ianm8/uDST/PCB/README.md

# PCB Details

## PCB Complete

PCB Complete


## Revision 1.1

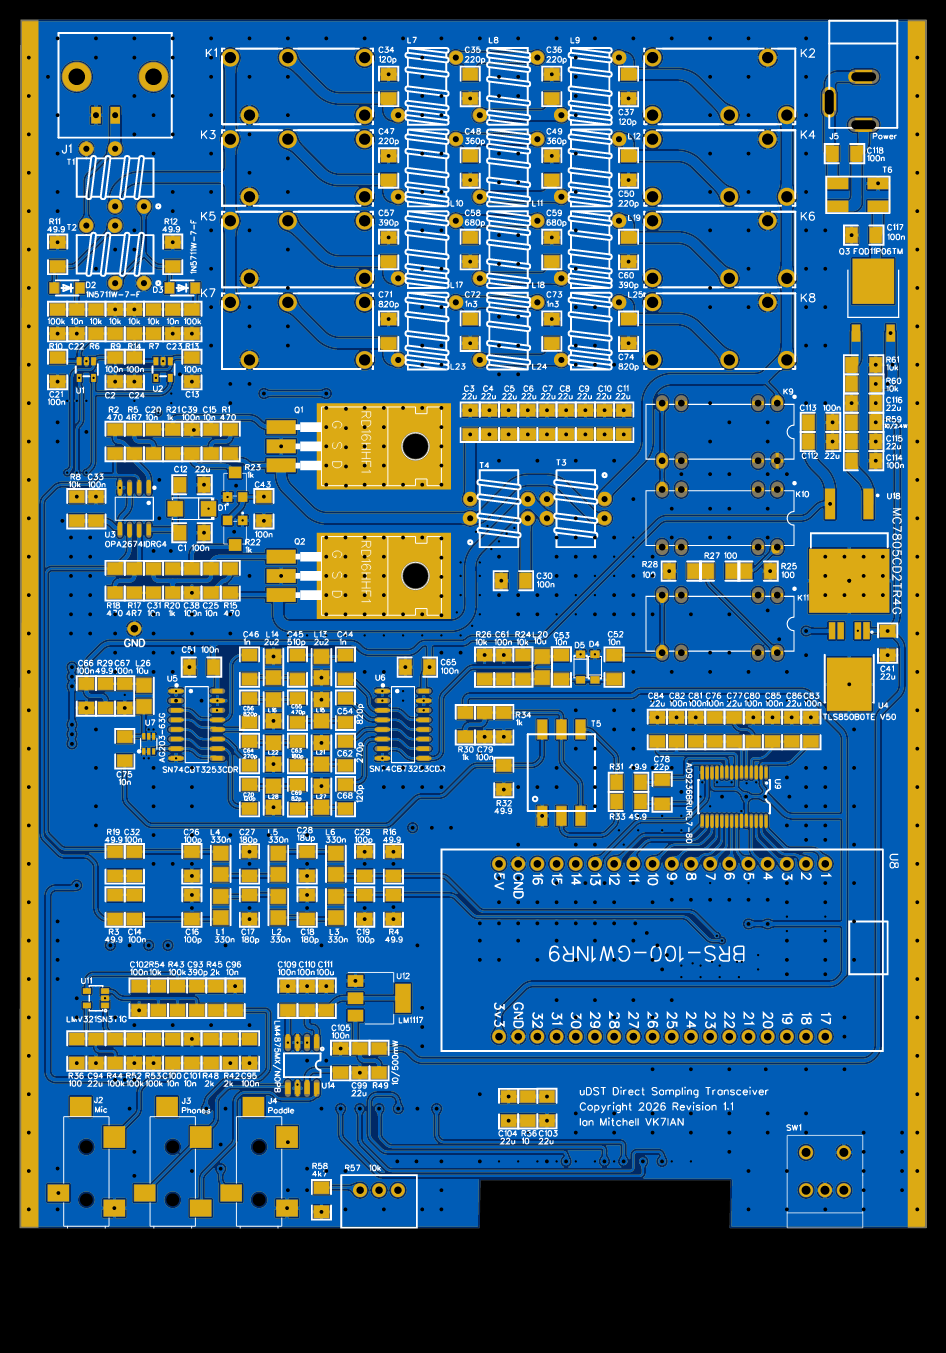
[picture p4: PCB/uDST-Top-1-1.png]
PCB
