ianm8/uDST/docs/README.md

# FPGA Details

## DDC Description

**DDC / receive.** The 12-bit ADC gives an ideal SNR of 6.02×12 + 1.76 = 74.0 dB, but that noise is spread across the full 40 MHz Nyquist band — a density of −74 − 10·log₁₀(40 MHz) = −150 dBFS/Hz. The DDC doesn't remove any noise; it just discards the 39.97 MHz of spectrum you don't want. After mixing to complex baseband and decimating by 2560, the output holds a 31.25 kHz slice, so the retained noise is −150 + 10·log₁₀(31 250) = −105 dBFS. The processing gain is therefore 10·log₁₀(40 MHz / 31.25 kHz) = 10·log₁₀(1280) ≈ **31.1 dB**, split as 24.1 dB from the CIC (÷512 → exactly 4.0 bits) and 7.0 dB from the FIR (÷5 → 1.2 bits). That's 5.2 bits of genuine extra resolution: the 12-bit converter behaves like a ~17-bit converter in the 31.25 kHz channel.

The word-growth bookkeeping matches this exactly. The 3rd-order CIC has a DC gain of 512³ = 2²⁷ (why the 48-bit integrators: worst case 16 + 27 = 43 bits). The ≫22 trim keeps 2⁷⁻²² wait — keeps 2²⁷⁄2²² = ×32, i.e. 5 bits of that gain — and those 5 bits are precisely the 5.2 bits the decimation earned, so the 16-bit I/Q word is filled with real information rather than padded LSBs. It's also why ≫22 calibrated so well: quadrature mixing halves a real carrier's amplitude (A·cosωt → A/2 complex envelope), so the net carrier gain is ×16, and a full-scale ADC input (±2047) lands at ±32 752 — 16-bit full scale within 0.004 dB. The 16-bit interface floor (−98 dBFS) sits ~7 dB above the −105 dBFS theoretical floor, so the pipe, not the ADC, is the final limit — and 98 dB in 31.25 kHz is far beyond anything HF propagation delivers. Firmware channel filtering to a ~2.4 kHz SSB bandwidth adds a further 10·log₁₀(31250⁄2400) ≈ 11 dB on top.

## DDC Block Diagram
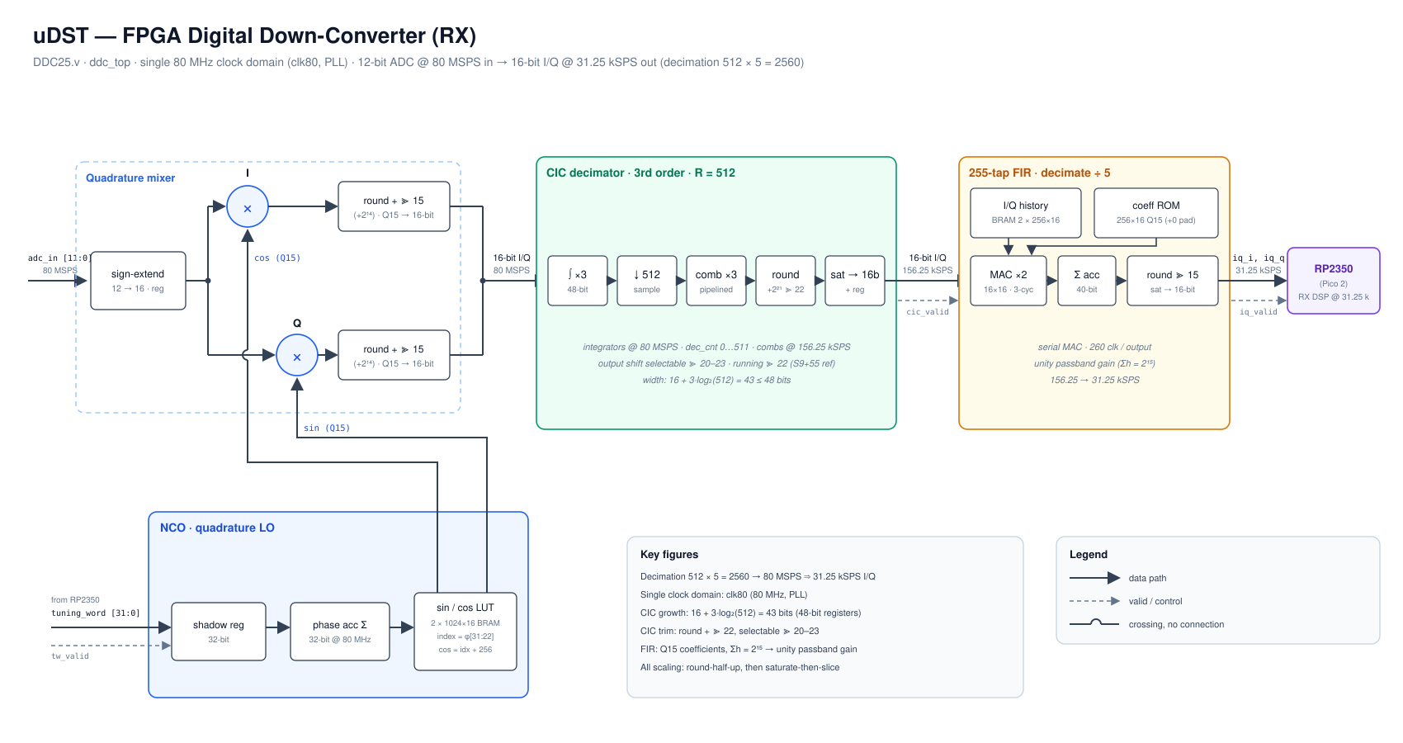
[picture p5: docs/uDST_DDC25_block_diagram.png]
DDC Block Diagram


## DUC Description

**DUC / transmit.** The same bookkeeping runs in reverse, arranged to be unity gain end to end: zero-stuffing ↑5 spreads each sample's energy over five outputs (÷5), which the 63-tap FIR's ≈×5 passband gain restores; the interpolating CIC has DC gain R^(N−1) = 512² = 2¹⁸, cancelled exactly by SCALE_SHIFT = 18; and the Q15 mixer's ≫15 returns to integer scale — so 10-bit TX samples map cleanly onto the 10-bit DAC. Oversampling pays off here too: the DAC's 62 dB SNR is spread over 40 MHz, a quantization-noise density of −138 dBFS/Hz, keeping the digital contribution to close-in transmit noise well below what the analog chain sets.

## DUC Block Diagram
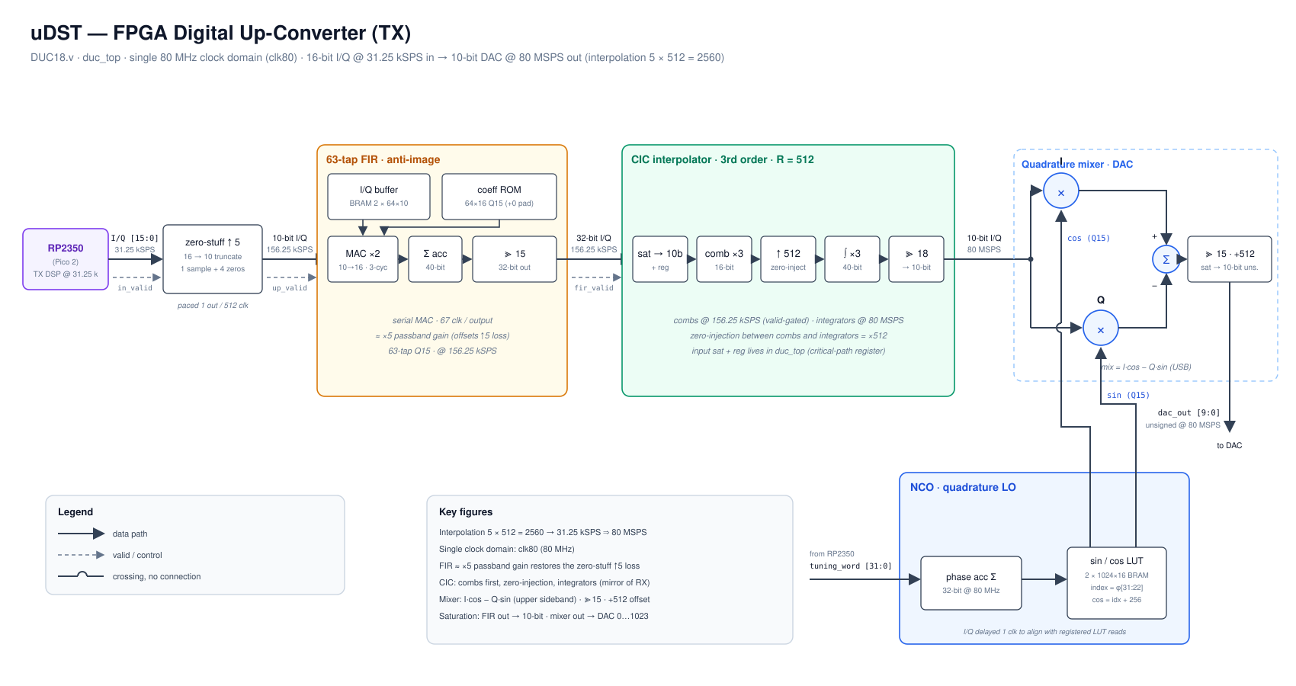
[picture p6: docs/uDST_DUC18_block_diagram.png]
DUC Block Diagram


## Analogue Gain and Attenuation

The uDST has 26dB of analogue gain ahead of the 12b ADC. This consists of an MMIC for 20dB of gain and a trifilar transformer that provides an additional 6dB of gain. A 12dB attenuator can be enabled if necessary.

**Sensitivity.** A bare 12-bit ADC clipping around +8 dBm has a noise density of 8 − 74 − 10·log₁₀(40 MHz) = −142 dBm/Hz, which against the −174 dBm/Hz thermal floor is an effective noise figure of ~32 dB. Gain ahead of the converter divides the ADC's noise contribution by that gain (Friis): antenna-referred, the ADC floor drops from −142 to −168 dBm/Hz, its NF contribution falls to ~6 dB, and the system NF becomes essentially the front-end amp's NF plus a few dB — call it 8–10 dB overall. In a 2.4 kHz SSB bandwidth that's an MDS around −131 to −134 dBm, versus roughly −108 dBm without the gain. The comparison that matters is against ITU-R band noise: quiet-rural at 7 MHz is around −144 dBm/Hz, dropping further on the higher bands. The bare ADC at −142 dBm/Hz would sit *at or above* the band noise — quiet-band weak signals lost in quantization noise — while with 26 dB the converter sits 20-plus dB underneath it on every HF band. Note the gain adds no SNR to any signal already above the amp's own noise; its entire job is to stop the ADC from *subtracting* SNR.

**Headroom.** The cost is exact and unavoidable: every dB of gain lowers the antenna-referred clip point by a dB. With ADC full scale near +8 dBm, 26 dB of gain puts clipping at −18 dBm at the antenna — which is S9+55, i.e. the ≫22 calibration point. That's a satisfying consistency check: the digital scaling and the analog gain plan agree to within a fraction of a dB. It also explains why the selectable shifts are the right companion knob — each step of the ≫20–23 option moves the digital full scale in 6 dB steps (S9+43, +49, +55…), so a future change in analog gain or a switched attenuator can be re-centred without touching the datapath. Practically, −18 dBm of clip headroom has to absorb the *aggregate* power of the whole 0–40 MHz band, since there's no channel filter ahead of a direct-sampling ADC; with typical HF antennas the night-time broadcast aggregate runs perhaps −30 to −20 dBm, so the margin is real but not extravagant — the classic direct-sampling trade, and why an attenuator ahead of a large antenna is worth having.

**Dither** The 31 dB decimation gain assumed quantization noise decorrelated across the band, which requires the LSBs to be genuinely exercised. With band noise arriving 20-odd dB above the ADC's per-Hz floor, the converter is continuously dithered by the antenna itself, so the processing-gain math holds without any added dither.

26 dB of analog gain buys ~23 dB of sensitivity, costs exactly 26 dB of clip headroom (landing full scale at S9+55), leaves every digital number unchanged, and makes the band — not the converter — the noise floor, which is the whole design goal of a direct-sampling receiver.

# Program Structure
Note, for improved resolution, take a look at the associated SVG file.

## Cores

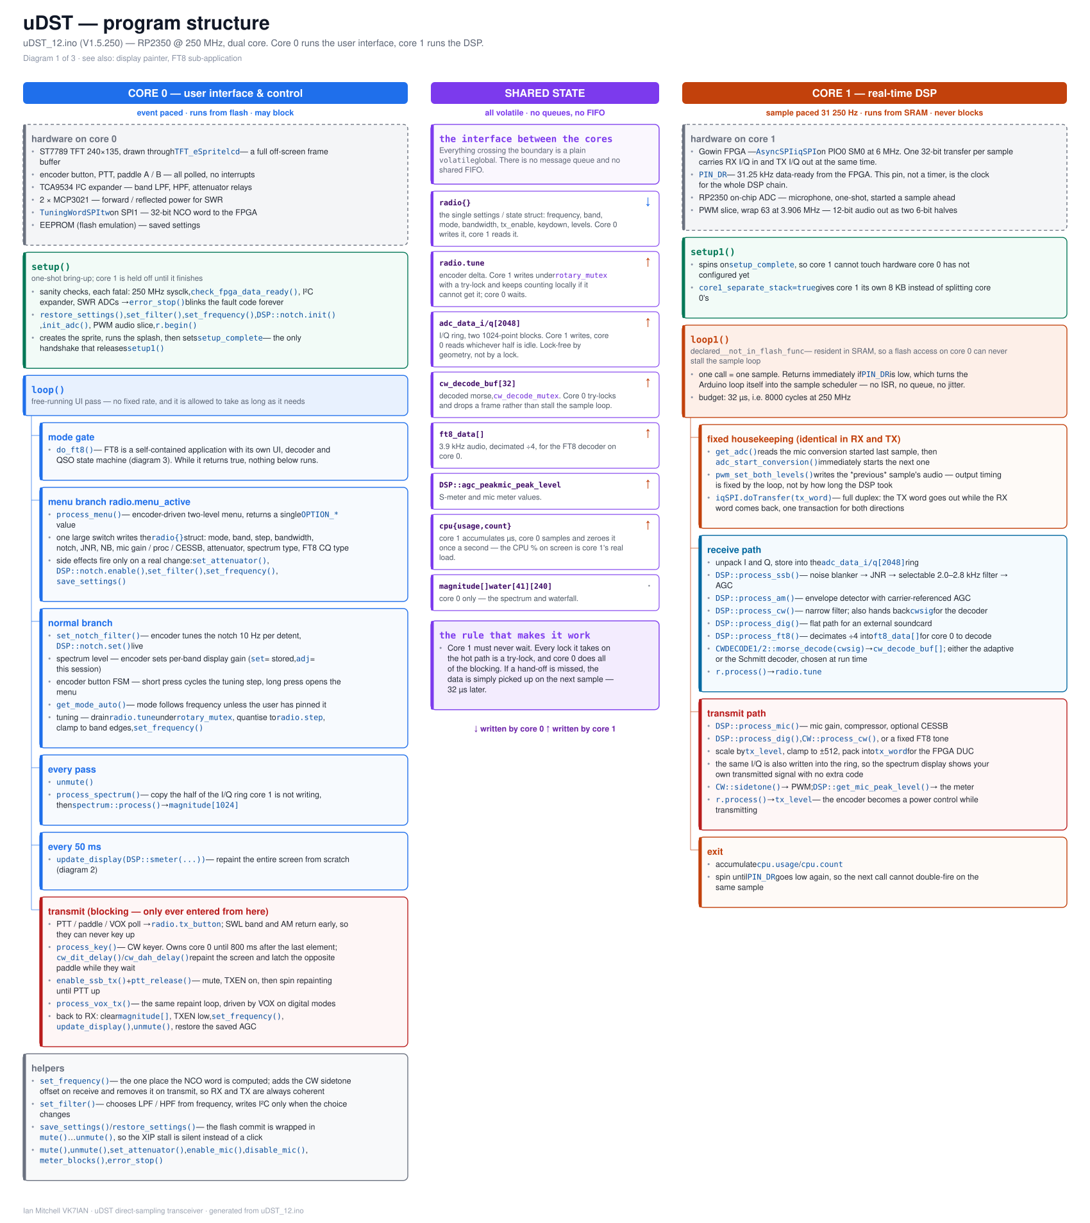
[picture p7: docs/uDST_structure_1_cores.png]


## Display

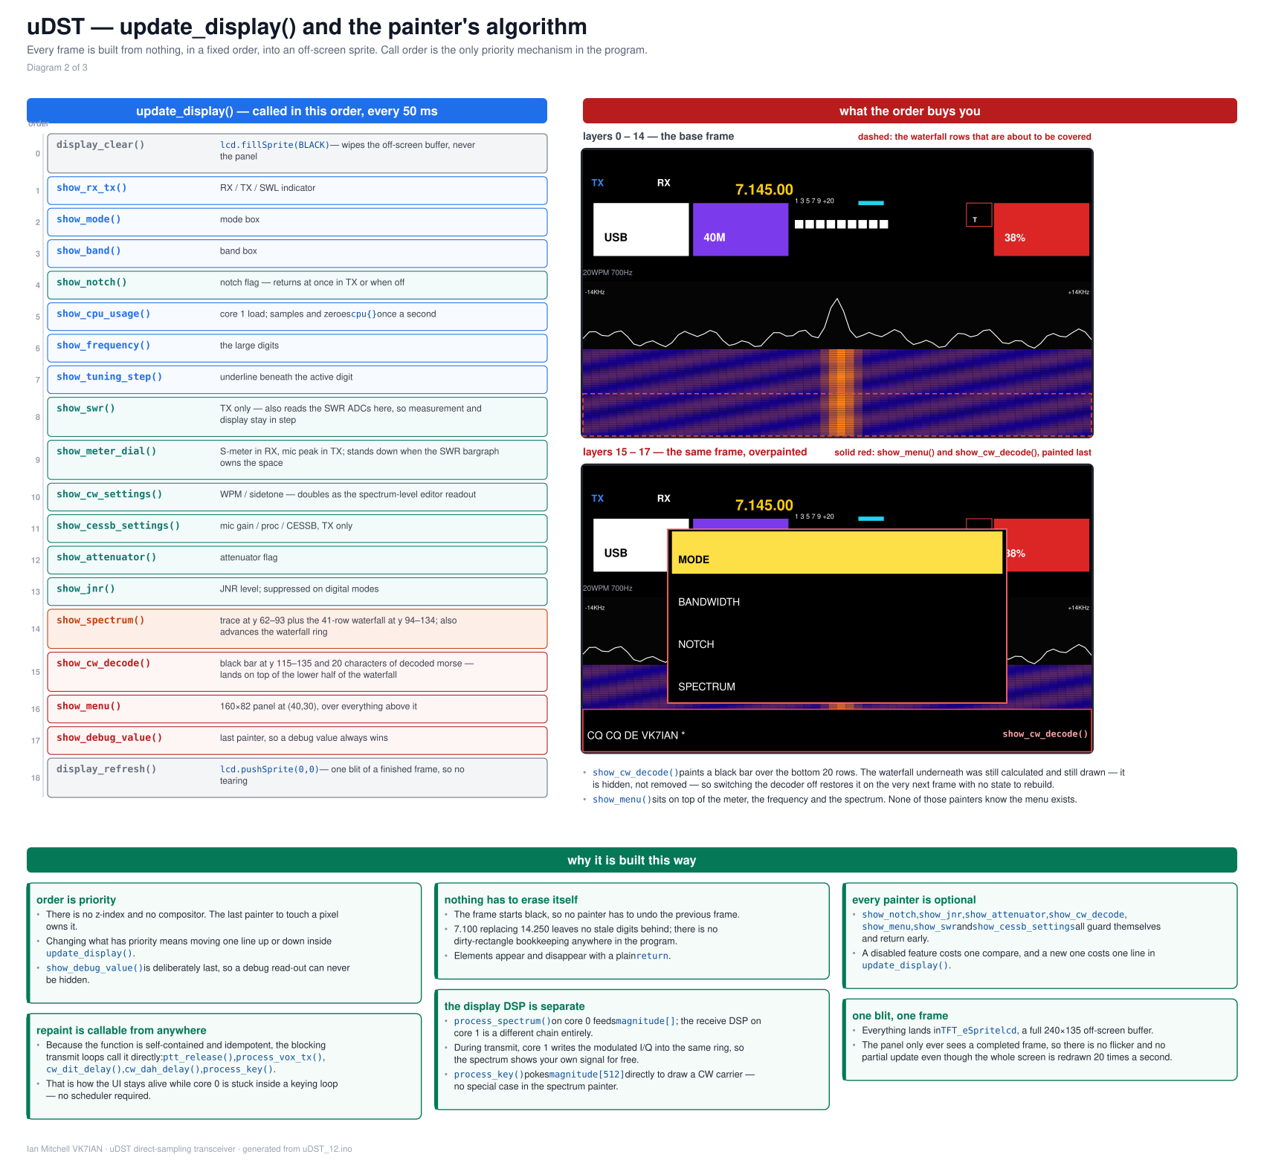
[picture p8: docs/uDST_structure_2_display.png]


## FT8

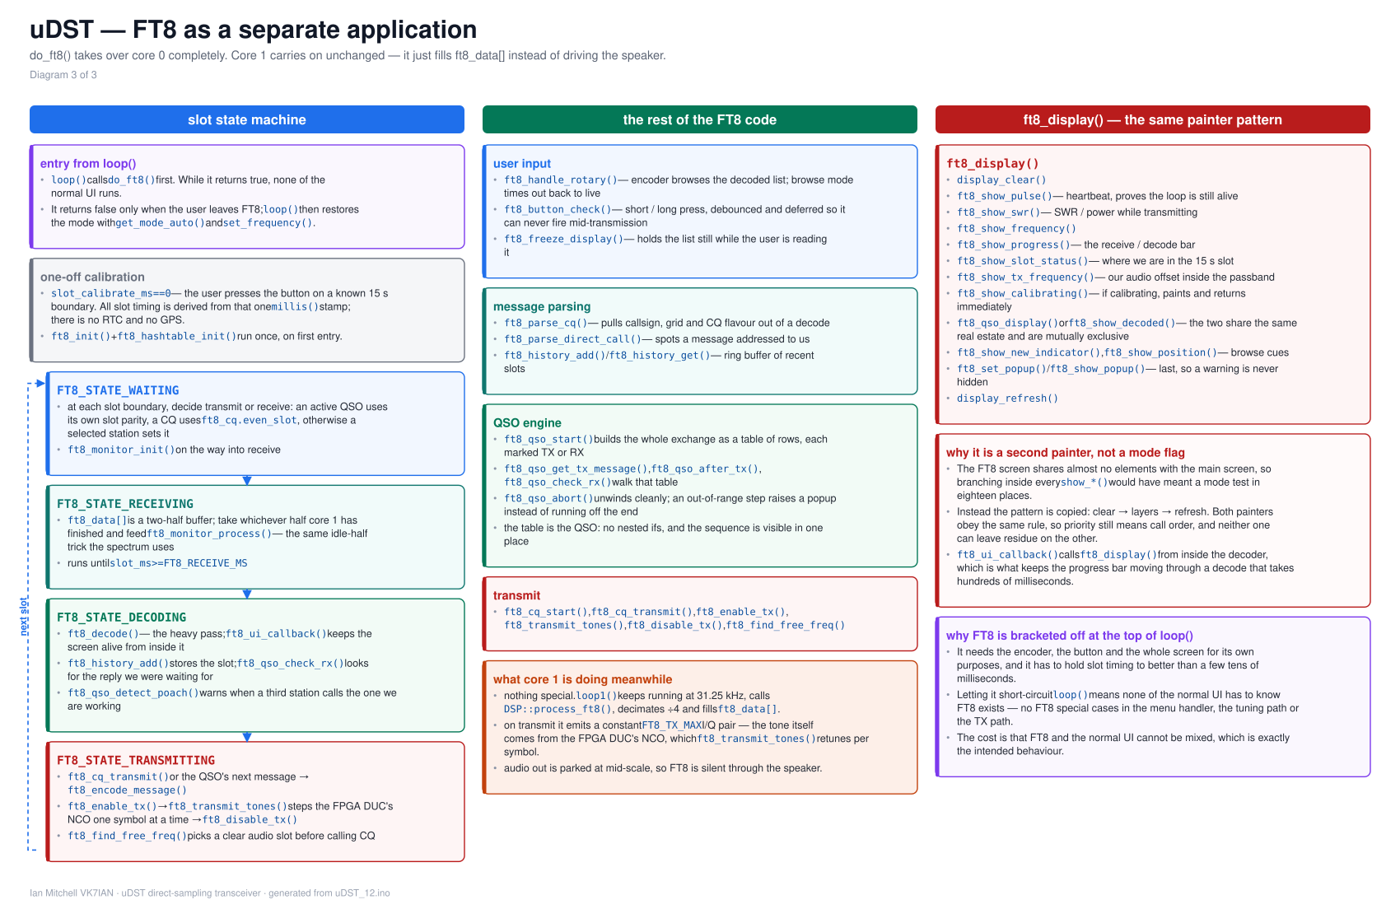
[picture p9: docs/uDST_structure_3_ft8.png]


# How it works

[This file](https://github.com/ianm8/uDST/blob/main/docs/uDST_How_It_Works.pdf) was provided by Brian W8BDM. He wanted to have a better understanding of how uDST worked so he got some help from AI and this file is the result. It is a very interesting and informative read. Thanks Brian!
