ianm8/uDST/src/TFT_eSPI2/README.md

# Modified TFT_eSPI library

* fixes a bug to work with Pico 1 and 2
* adds displayOn() function
