ianm8/uDST/verilog/uDST81/README.md

# 27/81 MHz Version

This version is for the stock, BRS-100 board with the 27MHz clock. **Note, it has not been tested in production**.
