ianm8/uDST/PCB/uDST-Bot-1-1.png

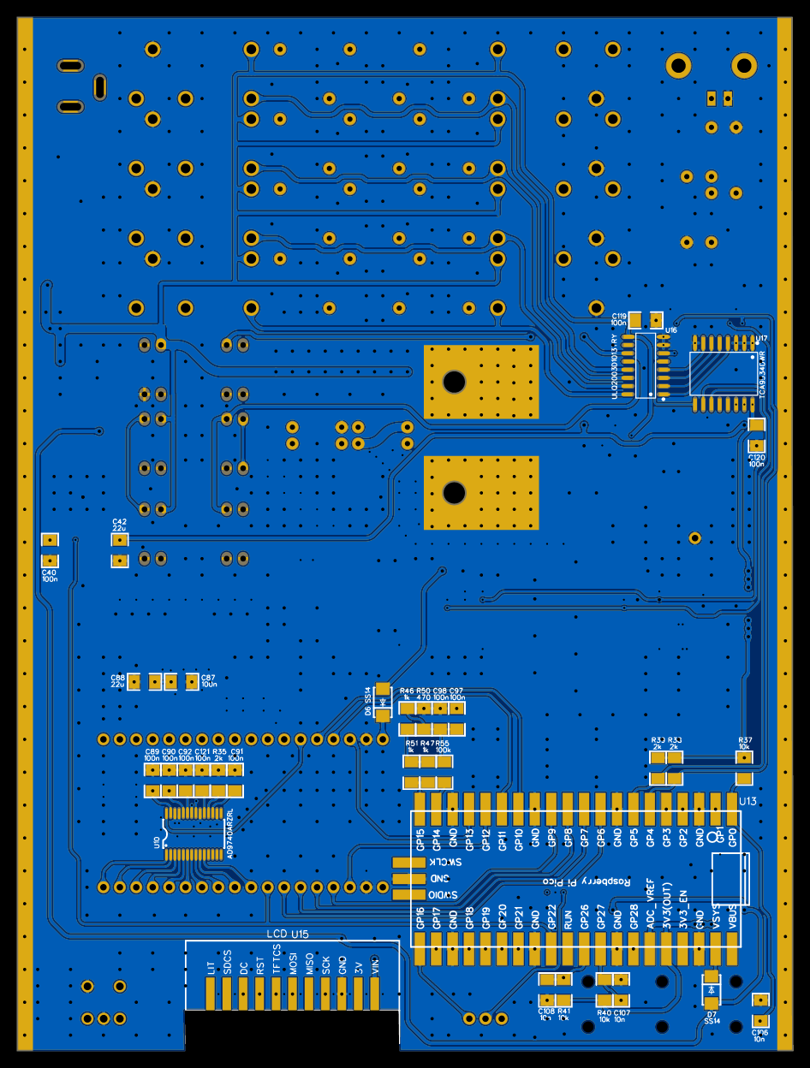
PCB/uDST-Bot-1-1.png
