ianm8/uDST/PCB/uDST-PCB-BOTTOM.png

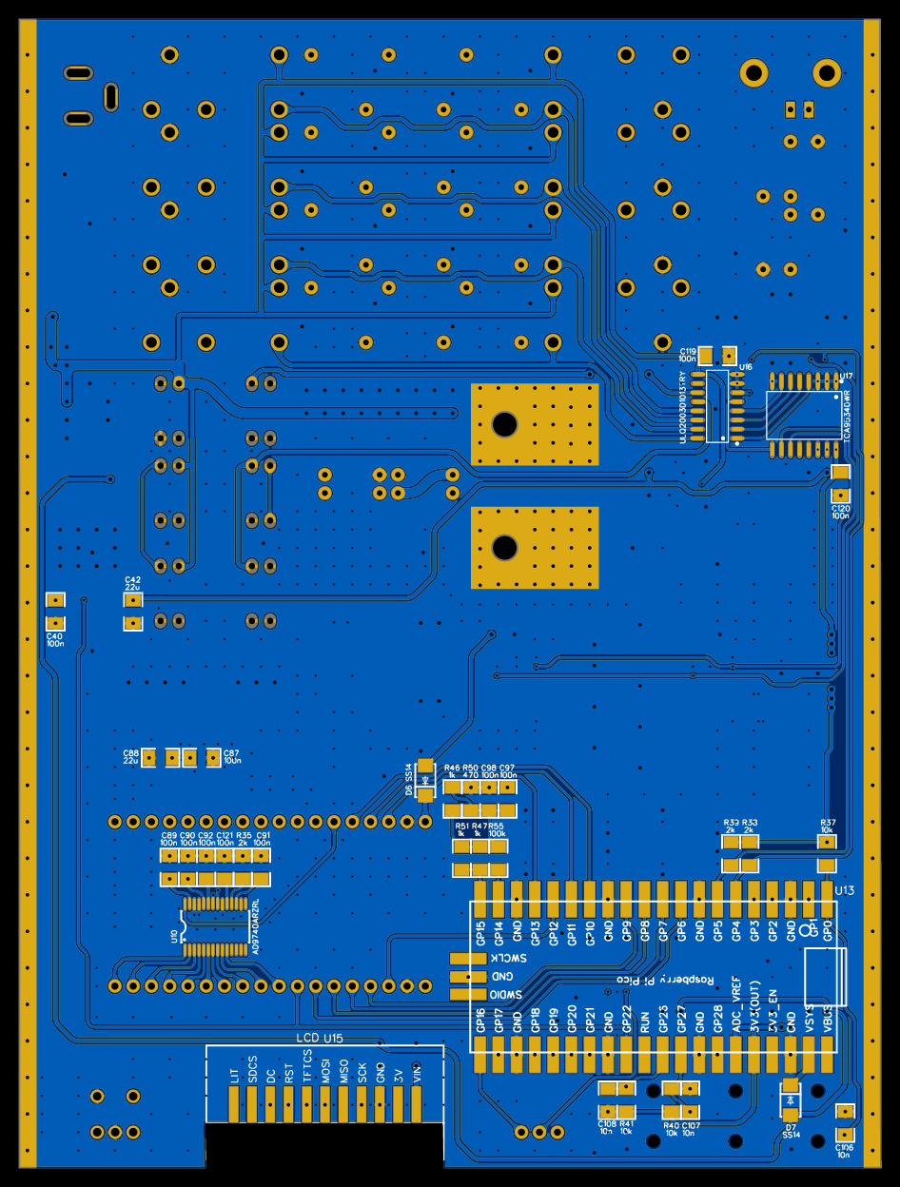
PCB/uDST-PCB-BOTTOM.png
