ianm8/uDST/BOM/BOM_uDST_2026-09-10.md

# BOM — uDST (2026-09-10)

| ID | Name | Designator | Footprint | Quantity | Manufacturer Part | Manufacturer | Supplier | Supplier Part | Notes |
|---|---|---|---|---|---|---|---|---|---|
| 1 | 100n | C1,C2,C13,C14,C21,C24,C30,C32,C33,C38,C39,C40,C43,C51,C61,C65,C66,C67,C76,C79,C80,C81,C82,C83,C85,C87,C89,C90,C91,C92,C95,C97,C98,C102,C105,C109,C110,C113,C114,C117,C118,C119,C120,C121 | 1206 | 44 | | | Mouser | | |
| 2 | 22u | C3,C4,C5,C6,C7,C8,C9,C10,C11,C12,C41,C42,C77,C84,C86,C88,C94,C99,C103,C104,C112,C115,C116 | 1206 | 23 | | | Mouser | | |
| 3 | 10n | C15,C20,C22,C23,C25,C31,C52,C53,C75,C96,C100,C101,C106,C107,C108 | 1206 | 15 | | | Mouser | | |
| 4 | 100p | C16,C19,C26,C29 | 1206 | 4 | | | Mouser | | |
| 5 | 180p | C17,C18,C27,C28,C63 | 1206 | 5 | | | Mouser | | |
| 6 | 120p | C34,C37,C68,C70 | 1206 | 4 | | | Mouser | | |
| 7 | 220p | C35,C36,C47,C50 | 1206 | 4 | | | Mouser | | |
| 8 | 1n | C44,C46 | 1206 | 2 | | | Mouser | | |
| 9 | 510p | C45 | 1206 | 1 | | | Mouser | | |
| 10 | 360p | C48,C49 | 1206 | 2 | | | Mouser | | |
| 11 | 820p | C54,C56,C71,C74 | 1206 | 4 | | | Mouser | | |
| 12 | 470p | C55 | 1206 | 1 | | | Mouser | | |
| 13 | 390p | C57,C60,C93 | 1206 | 3 | | | Mouser | | |
| 14 | 680p | C58,C59 | 1206 | 2 | | | Mouser | | |
| 15 | 270p | C62,C64 | 1206 | 2 | | | Mouser | | |
| 16 | 82p | C69 | 1206 | 1 | | | Mouser | | |
| 17 | 1n3 | C72,C73 | 1206 | 2 | | | Mouser | | |
| 18 | 22p | C78 | 1206 | 1 | | | Mouser | | |
| 19 | 100u | C111 | 1206 | 1 | | | Mouser | | |
| 20 | BZG05C3V3-M3-08 | D1 | SMA_L4.3-W2.6-LS5.2-RD | 1 | BZG05C3V3-M3-08 | VISHAY | Mouser | | |
| 21 | 1N5711W-7-F | D2,D3 | SOD-123_L2.8-W1.8-LS3.7-RD | 2 | 1N5711W-7-F | Diodes Incorporated | Mouser | | |
| 22 | 1N4148W-7-F | D4,D5 | SOD-123_L2.8-W1.8-LS3.7-RD | 2 | 1N4148W-7-F | DIODES | Mouser | | |
| 23 | SS14 | D6,D7 | SMA_L4.4-W2.8-LS5.4-RD | 2 | SS14 | MDD | Mouser | | |
| 24 | Antenna | J1 | BNC_PCB | 1 | | | Mouser | 5227161 | |
| 25 | Mic | J2 | CUI_SJ-3524-SMT | 1 | | | Mouser | SJ-3524-SMT | |
| 26 | Phones | J3 | CUI_SJ-3524-SMT | 1 | | | Mouser | SJ-3524-SMT | |
| 27 | Paddle | J4 | CUI_SJ-3524-SMT | 1 | | | Mouser | SJ-3524-SMT | |
| 28 | Power | J5 | DC-072-165A | 1 | PJ-002AH | Same Sky | Mouser | | |
| 29 | ALQ112 | K1,K2,K3,K4,K5,K6,K7,K8 | RELAY-TH_ALQ1XX | 8 | ALQ112 | PANASONIC | Mouser | | |
| 30 | HE721C1210 | K9,K10,K11 | RELAY-TH_LITTELFUSE_HE700 | 3 | HE721C1200 | Littelfuse | Mouser | | |
| 31 | 330n | L1,L2,L3,L4,L5,L6,L27,L28 | 120608 | 8 | | | Mouser | | |
| 32 | 330n | L7,L9 | T37-6 | 2 | | | Mini Kits | | |
| 33 | 360n | L8 | T37-6 | 1 | | | Mini Kits | | |
| 34 | 560n | L10,L12 | T37-6 | 2 | | | Mini Kits | | |
| 35 | 620n | L11 | T37-6 | 1 | | | Mini Kits | | |
| 36 | 2u2 | L13,L14 | 120608 | 2 | | | Mouser | | |
| 37 | 1u2 | L15,L16 | 120608 | 2 | | | Mouser | | |
| 38 | 1u | L17,L18,L19 | T37-6 | 3 | | | Mouser | | |
| 39 | 10u | L20,L26 | 120608 | 2 | | | Mouser | 1206F-100K-01 | |
| 40 | 680n | L21,L22 | 120608 | 2 | | | Mouser | | |
| 41 | 2u2 | L23,L24,L25 | T37-6 | 3 | | | Mouser | | |
| 42 | RD16HHF1 | Q1,Q2 | TO220 | 2 | | | Mini Kits | | |
| 43 | FQD11P06TM | Q3 | DPAK-3_L6.6-W6.1-P2.28-LS9.9-BR | 1 | FQD11P06TM | ON Semiconductor | Mouser | | |
| 44 | 470 | R1,R2,R15,R18,R50 | 1206 | 5 | | | Mouser | | |
| 45 | 49.9 | R3,R4,R11,R12,R16,R19,R29,R31,R32,R33 | 1206 | 10 | | | Mouser | | |
| 46 | 4R7 | R5,R17 | 1206 | 2 | | | Mouser | | |
| 47 | 10k | R6,R7,R8,R9,R14,R24,R26,R37,R40,R41,R54,R60,R61 | 1206 | 13 | | | Mouser | | |
| 48 | 100k | R10,R13,R43,R44,R52,R53,R55 | 1206 | 7 | | | Mouser | | |
| 49 | 1k | R20,R21,R30,R34,R46,R47,R51 | 1206 | 7 | | | Mouser | | |
| 50 | 1k | R22,R23 | 35WR1KLFTR | 2 | | | Mouser | 35WR1KLFTR | |
| 51 | 100 | R25,R27,R28,R36 | 1206 | 4 | | | Mouser | | |
| 52 | 2k | R35,R38,R39,R42,R45,R48 | 1206 | 6 | | | Mouser | | |
| 53 | 10/500mW | R49 | 1206 | 1 | | | Mouser | 352210RJT | |
| 54 | 10 | R56 | 1206 | 1 | | | Mouser | | |
| 55 | 10k | R57 | BOURNS_PTD901_1GANG | 1 | PTD901-1015F-B103 | Bourns | Mouser | PTD901-1015F-B103 | |
| 56 | 4k7 | R58 | 1206 | 1 | | | Mouser | | |
| 57 | 10/2.4W | R59 | 1206 | 1 | | | Mouser | 352210RJT | |
| 58 | PEC09-SWITCH-T | SW1 | PEC09-SWITCH-T | 1 | PEC09-2320F-T0015 | Bourns | Mouser | 652-PEC092320FT0015 | |
| 59 | FT37_SENSE_TRANSFORMER | T1,T2 | FT37_SENSE_TRANSFORMER | 2 | | | Mini Kits | | |
| 60 | FT50-43 | T3,T4 | SHO-301 | 2 | | | Mini Kits | or SHO-301 from Mouser | |
| 61 | 78602/4JC-2 | T5 | 78602SM | 1 | | | Mouser | | |
| 62 | PA4339.501 | T6 | PA4339.501NLT FOOTPRINT | 1 | PA4339.501NLT | Pulse Electronics Power | Mouser | PA4339.501NLT | |
| 63 | MCP3021A0T-E/OT | U1 | SOT-23-5_L2.9-W1.6-P0.95-LS2.8-BR | 1 | MCP3021A0T-E/OT | MICROCHIP | Mouser | | |
| 64 | MCP3021A1T-E/OT | U2 | SOT-23-5_L2.9-W1.6-P0.95-LS2.8-BR | 1 | MCP3021A1T-E/OT | MICROCHIP | Mouser | | |
| 65 | TLS850B0TE V50 | U4 | PG-TO252-5_L6.5-W6.3-P1.14-LS10.0-BR | 1 | TLS850B0TE V50 | Infineon | Mouser | | |
| 66 | SN74CBT3253CDR | U5,U6 | SOIC-16_L9.9-W3.9-P1.27-LS6.0-BL | 2 | SN74CBT3253CDR | Texas Instruments | Mouser | | |
| 67 | AG203-63G | U7 | SOT-363_L2.0-W1.3-P0.65-LS2.1-BL | 1 | AG203-63G | Qorvo | Mouser | | |
| 68 | BRS-100-GW1NR9 | U8 | BRS-100-GW1NR9 | 1 | | | Brisbane Silicon | Brisbane Silicon | |
| 69 | AD9236BRURL7-80 | U9 | TSSOP-28_L9.7-W4.4-P0.65-LS6.4-TL | 1 | AD9236BRURL7-80 | ADI | DigiKey | | |
| 70 | AD9740ARZRL | U10 | TSSOP-28_L9.7-W4.4-P0.65-LS6.4-TL | 1 | AD9740ARZRL | ADI | DigiKey | | |
| 71 | LMV321SN3T1G | U11 | TSOP-5_L3.0-W1.5-P0.95-BL | 1 | LMV321SN3T1G | | Mouser | | |
| 72 | LM1117 | U12 | SOT-223 | 1 | LM1117MP-5.0/NOPB | TI | Mouser | | |
| 73 | Raspberry Pi Pico 2 Castellated | U13 | PI_PICO_RP2040 | 1 | Pi Pico 2 | Raspberry Pi Foundation | Raspberry Pi or Mouser | Pi Pico 2 | |
| 74 | LM4875MX/NOPB | U14 | SOIC-8 | 1 | LM4875MX/NOPB | TI | Mouser | | |
| 75 | LCD | U15 | LCD4383SM | 1 | 4383 | null | Mouser | 485-4383 | |
| 76 | ULQ2003D1013TRY | U16 | SOIC-16_L9.9-W3.9-P1.27-LS6.0-BL | 1 | ULQ2003D1013TR | STMicroelectronics | Mouser | | |
| 77 | TCA9534DWR | U17 | SOIC-16_L10.3-W7.5-P1.27-LS10.3-BL | 1 | TCA9534DWR | Texas Instruments | Mouser | | |
| 78 | MC7805CD2TR4G | U18 | TO-263-2_L10.0-W9.1-P5.08-LS15.2-TL | 1 | MC7805CD2TR4G | onsemi | Mouser | 863-MC7805CD2TR4G | |
| 79 | OPA2674IDRG4 | U3 | SOIC-8_L4.9-W3.9-P1.27-LS6.0-BL | 1 | OPA2674IDRG4 | TI | Mouser | | |
| 80 | Heatsink | | | 2 | 274-2AB | | Mouser | 567-274-2AB | |
| 81 | Case | | | 1 | 1455P1601BK | | Mouser | 546-1455P1601BK | |
| 82 | TO-220 | | Thermal Insulator | 4 | | | | | |
| 83 | 24MHz TCXO | | | 1 | FT3MHUPM24.0-T1 | | Mouser | FT3MHUPM24.0-T1 | Replaces 27MHz clock on BRS-100 |
