ianm8/uDST/docs/Schematic_uDST_2026-09-06.pdf

20m/17m

## Heat sink: 567-274-2AB

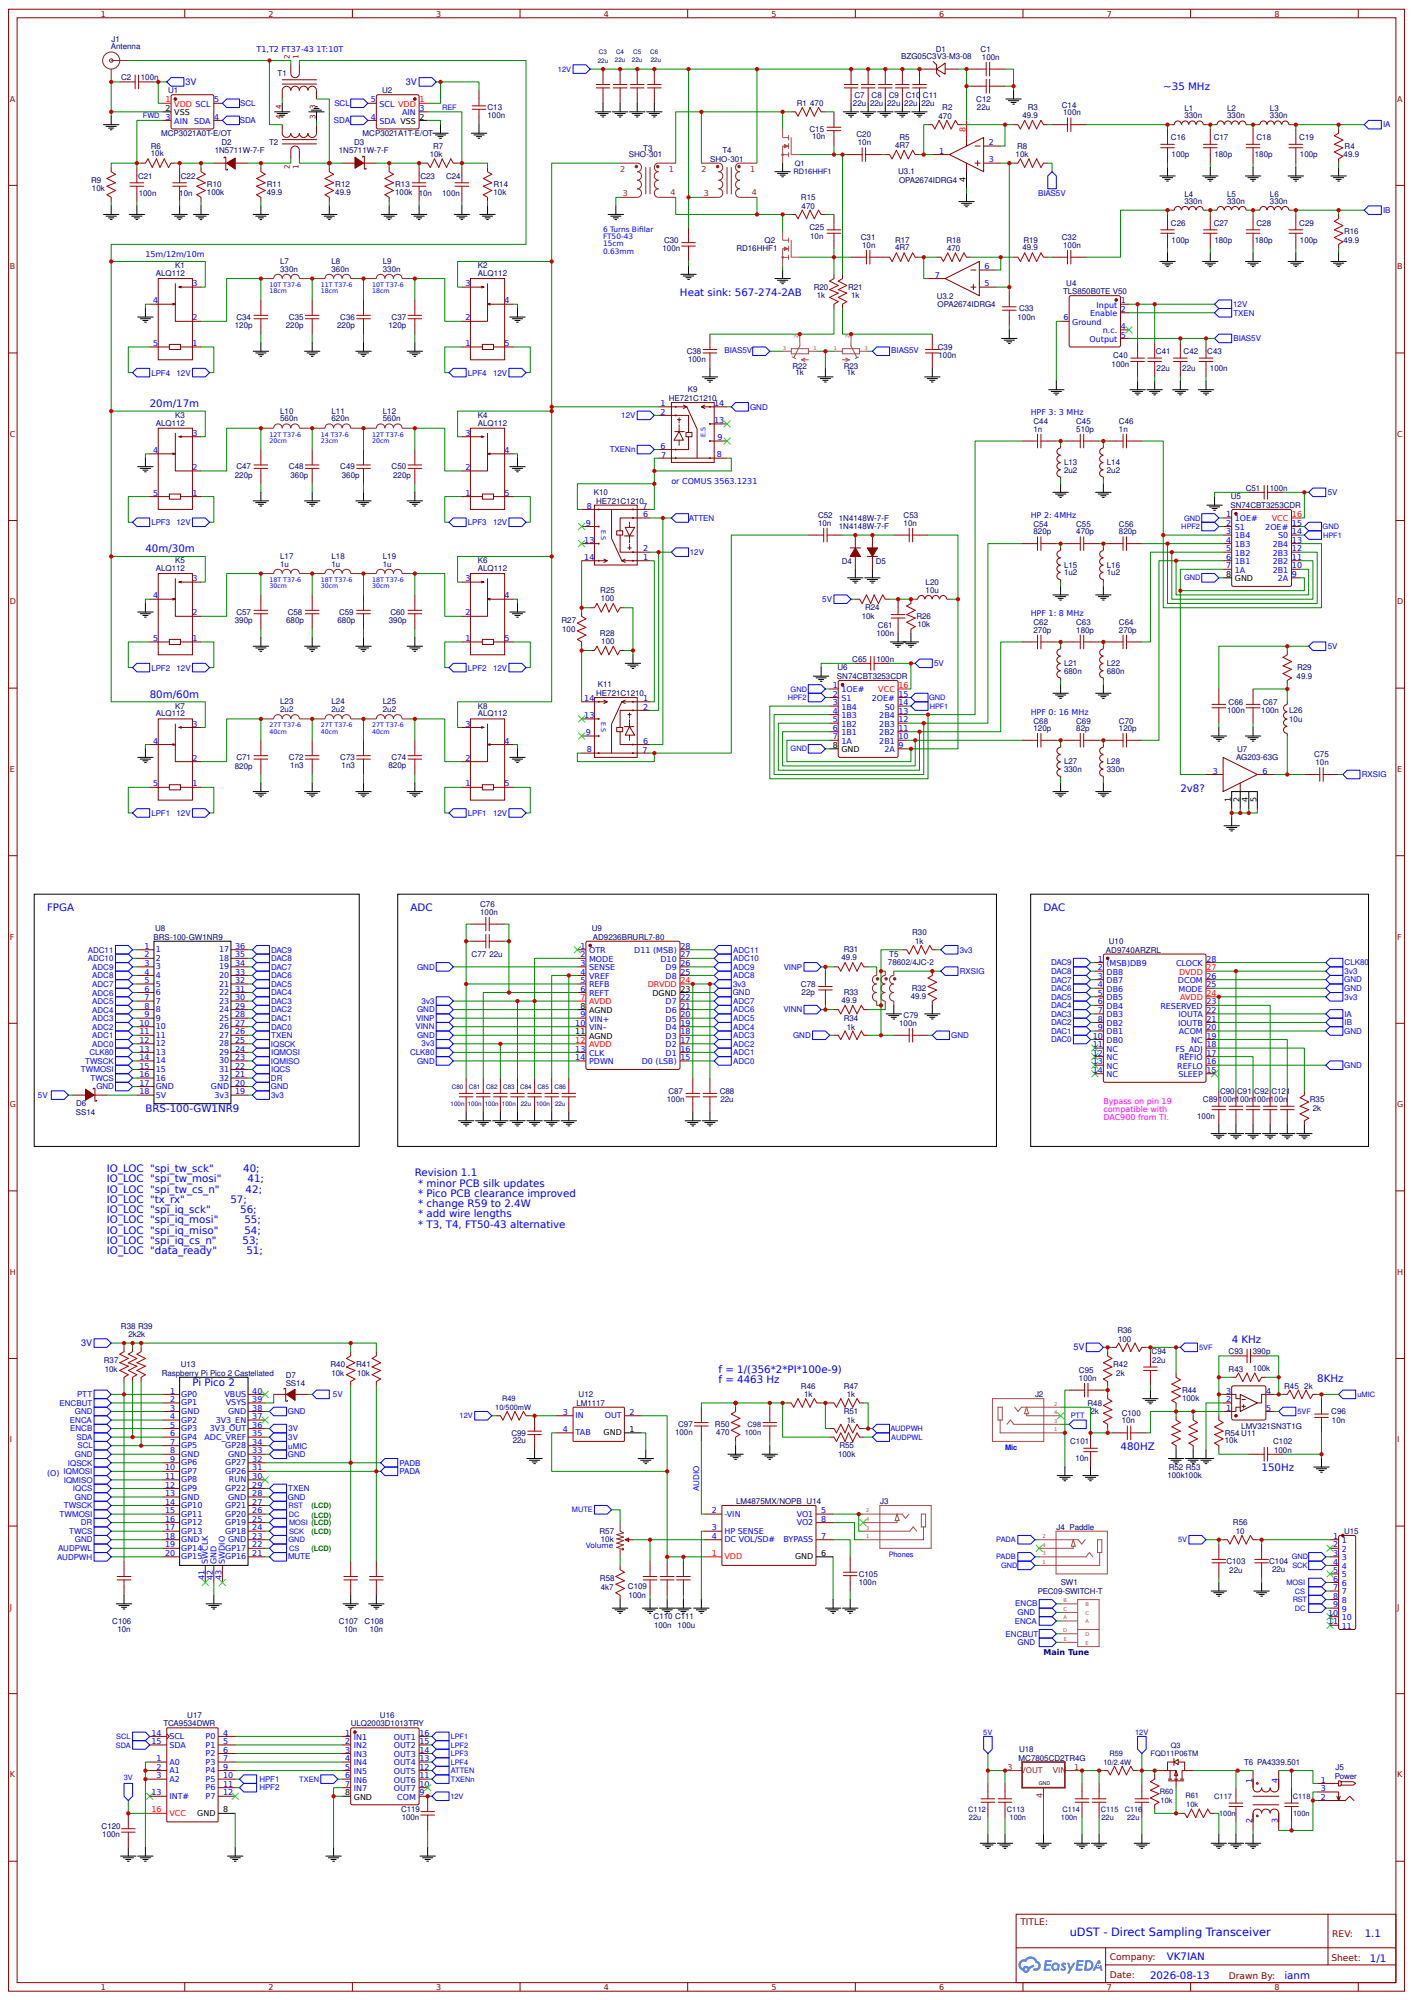
[picture p18: page 1]

Revision 1.1
* minor PCB silk updates
* Pico PCB clearance improved
* change R59 to 2.4W
* add wire lengths
* T3, T4, FT50-43 alternative

Pi Pico 2SWDIO 43 GND 42 SWCLK 41
GP16 21 GP15 20 GP14 19 GND 18 GP13 17 GP12 16 GP11 15 GP10 14 GND 13 GP9 12 GP8 11 GP7 10 GP6 9 GND 8 GP5 7 GP4 6 GP3 5 GP2 4 GND 3 GP1 2 GP0 1

Raspberry Pi Pico 2 Castellated

LM4875MX/NOPB U14
BYPASS 7 DC VOL/SD# 4 HP SENSE 3
