ianm8/uDST/src/uDST.ino

/*
 * uDST Version 4.1.250
 *
 * Copyright 2026 Ian Mitchell VK7IAN
 * Licenced under the GNU GPL Version 3
 *   (unless otherwise indicated)
 *
 * Libraries
 *
 *  TFT_eSPI2 in TFF_ePSI2 folder (based on https://github.com/Bodmer/TFT_eSPI)
 *
 * Filter Design
 *
 *  https://github.com/ianm8/FIR-Designer
 *
 * Build:
 *  Pi Pico 2
 *  CPU Speed: 250Mhz
 *  Optimize: -O3
 *  USB Stack: No USB
 *  Flash Size: 4MB (no FS)
 *
 * Some history
 *  0.01.240 start with MBPTRX code
 *  0.02.240 adjust S meter values
 *  0.03.240 set CW to max gain
 *  0.04.240 improved CESSB
 *  0.05.250 set 250 (not using PCM1808 now)
 *  0.06.250 improved spectrum DC removal
 *  0.07.250 improved AM detection
 *  0.08.250 simplify SSB/DGL/FT8 demod
 *  0.09.250 improved noise blanker
 *  0.10.250 improved s-meter
 *  0.11.250 improved sensitivity (AGC)
 *  0.12.250 notch filter
 *  1.0.250 move DSP to core 1
 *  1.1.250 AM s-meter adjust
 *  1.2.250 s-meter colour
 *  1.3.250 SWR/power meter enhanced
 *  1.4.250 fix spectrum bleed
 *  1.5.250 reduce spectrum stack usage
 *  1.6.250 move mode Auto
 *  1.7.250 add 10000 to quick step
 *  1.8.250 fix frequency step
 *  1.9.250 FT8 hashtable bounds
 *  2.0.250 include TFT_eSPI2 library
 *  2.1.250 add popups
 *  2.2.250 about menu
 *  2.3.250 FT8 AGC display
 *  2.4.250 set all defaults
 *  2.5.250 FT8 auto calibration
 *  2.6.250 FT8 S9 at 80%
 *  2.7.250 fix comments
 *  2.8.250 move mode 2nd menu
 *  2.9.250 reboot option
 *  3.0.250 user set callsign
 *  3.1.250 copyright
 *  3.2.250 spectrum overflow
 *  3.3.250 overflow indicator
 *  3.4.250 float FFT
 *  3.5.250 FPGA version 1.1
 *  3.6.250 improve DC gate
 *  3.7.250 overflow warning
 *  3.8.250 FT8 auto default
 *  3.9.250 fix overflow warning
 *  4.0.250 update all-pass
 *  4.1.250 CW shaping improved
 */

//#define DEBUGGING_SKIP
//#define DEBUG_DDC_SAMPLE
//#define DEBUG_AGC_SAMPLE
//#define DEBUG_STACKCHECK_CORE0
//#define DEBUG_STACKCHECK_CORE1
//#define SPI_LOOPBACK_TEST
// uncomment and connect GP7 and GP8
// using a 220 Ohm resistor
// to test asyncSPI functions

#include <SPI.h>
#include <EEPROM.h>
#include <TFT_eSPI2.h>
#include "tuningWordSPI.h"
#include "asyncSPI.h"
#include "util.h"
#include "mcp3021.h"
#include "TCA9534A.h"
#include "Rotary.h"
#include "spectrum.h"
#include "dsp.h"
#include "menu.h"
#include "CW.h"
#include "cwdecode1.h"
#include "cwdecode2.h"
#include "ft8.h"
#include "ft8ui.h"
#include "hardware/pwm.h"
#include "hardware/adc.h"
#include "hardware/vreg.h"
#include "ArialBold14pt7b.h"
#include "ArialBold16pt7b.h"
#include "stackpaint.h"

// uncomment when dev/debugging
//#define USER_CALL "VK7IAN"
//#define USER_GRID "QE36"

#define VERSION_STRING "  V4.1."
#define CW_TIMEOUT 800u
#define MENU_TIMEOUT 5000u
#define VOX_LEVEL 100u
#define VOX_TIMEOUT 250u
#define POPUP_TIMEOUT 5000u
#define BAND_80M 0
#define BAND_40M 1
#define BAND_30M 2
#define BAND_20M 3
#define BAND_17M 4
#define BAND_15M 5
#define BAND_12M 6
#define BAND_10M 7
#define BAND_SWL 8
#define BAND_MIN BAND_80M
#define BAND_MAX BAND_SWL
#define NUM_BANDS 9
#define DEFAULT_FREQUENCY 7100000ul
#define DEFAULT_BAND BAND_40M
#define DEFAULT_MODE MODE_LSB
#define DEFAULT_STEP 1000ul
#define DEFAULT_CW_SPEED 60ul
#define DEFAULT_SIDETONE 700ul
#define DEFAULT_CW_LEVEL 2ul
#define DEFAULT_MICGAIN 100ul
#define DEFAULT_MICPROC 0ul
#define DEFAULT_BANDWIDTH 3ul
#define NOTCH_LOW 300ul
#define NOTCH_HIGH 2600ul
#define DEFAULT_NOTCH 1000ul
#define BUTTON_LONG_PRESS_TIME 800ul
#define SPECTRUM_LEVEL_MIN -4
#define SPECTRUM_LEVEL_MAX 5
#define LPF_I2C_ADDRESS 0x20U
#define FPGA_CLK 80000000ULL

// sets FT8 output power (technical max is 511)
// when I = Q, maximum peek output value to
// prevent overflow will be when
// I = Q = 511 / sqrt(2) = 361
#define FT8_TX_MAX 360u

#define PIN_PTT      0 // Mic PTT (active low)
#define PIN_ENCBUT   1 // on rotary
#define PIN_ENCA     2 // rotary
#define PIN_ENCB     3 // rotary
#define PIN_SDA      4 // I2C
#define PIN_SCL      5 // I2C
#define PIN_IQSCK    6 // async SPI
#define PIN_IQMOSI   7 // async SPI
#define PIN_IQMISO   8 // async SPI
#define PIN_IQCS     9 // async SPI
#define PIN_TWSCK   10 // sync SPI (SPI1 SCK)
#define PIN_TWMOSI  11 // sync SPI (SPI1 TX)
#define PIN_DR      12 // FPGA Data Ready
#define PIN_TWCS    13 // sync SPI (SPI1 CSn)
#define PIN_AUPWML  14 // audio PWM low
#define PIN_AUPWMH  15 // audio PWM high
#define PIN_MUTE    16 // Audio mute when low
#define PIN_CS      17 // LCD see User_Setup.h (SPI0 CSn)
#define PIN_SCK     18 // LCD see User_Setup.h (SPI0 SCK)
#define PIN_MOSI2   19 // LCD see User_Setup.h (SPI0 TX)
#define PIN_DC      20 // LCD see User_Setup.h
#define PIN_RST     21 // LCD see User_Setup.h
#define PIN_TXEN    22 // enable TX (bias, FPGA, relay)
#define PIN_REG     23 // Pico regulator
#define PIN_PADA    26 // CW Paddle A
#define PIN_PADB    27 // CW Paddle B
#define PIN_MIC     28 // analog MIC (ADC2)

// these "Pins" used with TCA9534
#define I2C_PIN_LPF1 0 // low-pass filter
#define I2C_PIN_LPF2 1 // low-pass filter
#define I2C_PIN_LPF3 2 // low-pass filter
#define I2C_PIN_LPF4 3 // low-pass filter
#define I2C_PIN_ATT  4 // 12dB attenuator relays
#define I2C_PIN_HPF1 5 // high-pass filter low bit
#define I2C_PIN_HPF2 6 // high-pass filter high bit

// width and height of LCD
#define LCD_WIDTH         240
#define LCD_HEIGHT        135
#define POS_CALL_X         70
#define POS_SPLASH_X       80
#define POS_SPLASH_Y       60
#define POS_VERSION_X       0
#define POS_VERSION_Y     122
#define POS_FREQUENCY_X    72
#define POS_FREQUENCY_Y    21
#define POS_TX_X            4
#define POS_TX_Y           17
#define POS_RX_X           35
#define POS_RX_Y           17
#define POS_MODE_X         10
#define POS_MODE_Y         30
#define POS_BAND_X         57
#define POS_BAND_Y         30
#define POS_CPU_X         199
#define POS_CPU_Y          30
#define POS_JNR_X         199
#define POS_JNR_Y          52
#define POS_OVERFLOW_X    199
#define POS_OVERFLOW_Y     62
#define POS_DEBUG1_X       10
#define POS_DEBUG1_Y      100
#define POS_DEBUG2_X      180
#define POS_DEBUG2_Y      100
#define POS_ATT_X         176
#define POS_ATT_Y          38
#define POS_METER_X       100
#define POS_METER_Y        25
#define POS_TUNING_STEP_X 130
#define POS_TUNING_STEP_Y  40
#define POS_NOTCH_X       181
#define POS_NOTCH_Y        25
#define POS_SWR_X         125
#define POS_SWR_Y          40
#define POS_WATER_X         0
#define POS_WATER_Y        62
#define POS_CW_SETTINGS_X   0
#define POS_CW_SETTINGS_Y  52
#define POS_CESSB_MIC_X     0
#define POS_CESSB_MIC_Y    52
#define POS_CENTER_LEFT   119
#define POS_CENTER_RIGHT  120
#define POS_MENU_X         40
#define POS_MENU_Y         30
#define MENU_WIDTH        160
#define MENU_HEIGHT        82
#define SPECTRUM_WIND      0u
#define SPECTRUM_GRASS     1u
#define JNR_OFF            0u
#define JNR_LEVEL1         1u
#define JNR_LEVEL2         2u
#define JNR_LEVEL3         3u
#define NB_OFF             0u
#define NB_LEVEL1          1u
#define NB_LEVEL2          2u
#define NB_LEVEL3          3u
#define NB_LEVEL4          4u
#define NB_LEVEL5          5u
#define MIC_PROC1          1u
#define MIC_PROC2          2u
#define MIC_PROC3          3u
#define MIC_PROC4          4u
#define MIC_PROC5          5u
#define MIC_PROC_OFF       0u

#if PIN_MIC == 26U
#define MIC_MUX 0U
#elif PIN_MIC == 27U
#define MIC_MUX 1U
#elif PIN_MIC == 28U
#define MIC_MUX 2U
#elif PIN_MIC == 29U
#define MIC_MUX 3U
#endif

// two buffers of 1024 FFT bins
#define MAX_ADC_SAMPLES 2048
#define SPECTRUM_BUFFER 1024
#define WATERFALL_ROWS 41

static_assert((MAX_ADC_SAMPLES & (MAX_ADC_SAMPLES - 1)) == 0, "MAX_ADC_SAMPLES must be a power of 2");

// just keep same error codes as MBPTRX
#define ERROR_SYSCLOCK 3u
#define ERROR_FPGA     4u
#define ERROR_LPF      5u
#define ERROR_FWDADC   7u
#define ERROR_REFADC   8u

enum ft8_call_t
{
  FT8_CQ_CQ,
  FT8_CQ_DX,
  FT8_CQ_WWFF,
  FT8_CQ_POTA,
  FT8_CQ_SOTA
};

enum radio_mode_t
{
  MODE_LSB,
  MODE_USB,
  MODE_CWL,
  MODE_CWU,
  MODE_DGL,
  MODE_DGU,
  MODE_FT8,
  MODE_AM
};

volatile static struct
{
  int32_t tune;
  uint32_t step;
  uint32_t frequency;
  uint32_t band;
  uint32_t cw_dit;
  uint32_t cw_level;
  uint32_t sidetone;
  uint32_t cw_phase;
  uint32_t cwdecode;
  uint32_t spectype;
  uint32_t jnrlevel;
  uint32_t nblevel;
  uint32_t micgain;
  uint32_t micproc;
  uint32_t bandwidth;
  uint32_t notch;
  radio_mode_t mode;
  ft8_call_t ft8_cq;
  bool tx_safe;
  bool tx_button;
  bool tx_enable;
  bool keydown;
  bool cessb;
  bool attenuator;
  bool menu_active;
  bool mode_auto;
  bool graph_swr;
  bool notch_enable;
  bool ft8_autocal;
  int8_t level[NUM_BANDS];
  int8_t slevel[NUM_BANDS];
  char callsign[16];
  char grid[16];
}
radio =
{
  0l,
  DEFAULT_STEP,
  DEFAULT_FREQUENCY,
  DEFAULT_BAND,
  DEFAULT_CW_SPEED,
  DEFAULT_CW_LEVEL,
  DEFAULT_SIDETONE,
  (uint32_t)(((uint64_t)DEFAULT_SIDETONE * (1ull << 32)) / SAMPLERATE),
  0l,
  SPECTRUM_WIND,
  JNR_OFF,
  NB_OFF,
  DEFAULT_MICGAIN,
  DEFAULT_MICPROC,
  DEFAULT_BANDWIDTH,
  DEFAULT_NOTCH,
  DEFAULT_MODE,
  FT8_CQ_CQ,
  false,
  false,
  false,
  false,
  false,
  false,
  false,
  true,
  false,
  false,
  true,
  {0,0,0,0,0,0,0,0,0},
  {0,0,0,0,0,0,0,0,0},
  "",
  ""
};

static struct
{
  const uint32_t lo;
  const uint32_t hi;
  uint32_t frequency;
}
bands[] =
{
  { 3500000UL,  3800000UL,  3600000UL},
  { 7000000UL,  7300000UL,  7100000UL},
  {10100000UL, 10150000UL, 10120000UL},
  {14000000UL, 14350000UL, 14200000UL},
  {18068000UL, 18168000UL, 18100000UL},
  {21000000UL, 21450000UL, 21200000UL},
  {24890000UL, 24990000UL, 24900000UL},
  {28000000UL, 29700000UL, 28500000UL},
  {  500000UL, 30000000UL,  5000000UL}
};

volatile static struct
{
  uint32_t frequency;
}
save_data[] =
{
  { 3600000UL},
  { 7100000UL},
  {10120000UL},
  {14200000UL},
  {18100000UL},
  {21200000UL},
  {24900000UL},
  {28500000UL},
  { 5000000UL}
};

volatile static struct
{
  uint32_t usage;
  uint32_t count;
} cpu = {0,0};

// For RP2040/RP2350 multicore: Allocates a dedicated 8KB stack for Core 1
// By default, Core 0 and Core 1 split a single 8KB stack (4KB each)
// Setting this to true prevents Core 1 from causing stack overflow crashes
bool core1_separate_stack = true;

MCP3021 fwdADC;
MCP3021 refADC;
TCA9534 lpf_port;
Rotary r = Rotary(PIN_ENCB,PIN_ENCA);
TuningWordSPI tw(SPI1, PIN_TWCS, 8000000);
AsyncSPI iqSPI(pio0, 0, PIN_IQCS, PIN_IQSCK, PIN_IQMOSI, PIN_IQMISO, 6'000'000.0f);
TFT_eSPI tft = TFT_eSPI();
TFT_eSprite lcd = TFT_eSprite(&tft);

auto_init_mutex(rotary_mutex);
auto_init_mutex(cw_decode_mutex);

volatile static int32_t debug_value_1 = 0;
volatile static int32_t debug_value_2 = 0;
volatile static uint32_t overflow = 0;
volatile static uint32_t audio_pwm = 0;
volatile static uint32_t adc_sample_p = 0;
volatile static uint32_t ft8_sample_p = 0;
volatile static uint32_t mic_peak_level = 0;
volatile static int16_t adc_data_i[MAX_ADC_SAMPLES] = {0};
volatile static int16_t adc_data_q[MAX_ADC_SAMPLES] = {0};
volatile static float ft8_data[FT8_FFT_SIZE] = {0.0f};
volatile static float mic_gain = 0.0f;
volatile static bool dit_latched = false;
volatile static bool dah_latched = false;
volatile static bool setup_complete = false;
volatile static bool set_spectrum_level = false;
volatile static bool adj_spectrum_level = false;
volatile static bool adj_notch_filter = false;
volatile static bool vox_triggered = false;
volatile static bool vox_mic_ready = false;
volatile static char cw_decode_buf[32] = "";
volatile static char sz_version[16] = "";
volatile static uint32_t wp = 0;
static uint8_t water[WATERFALL_ROWS][LCD_WIDTH] = {0};
static uint8_t magnitude[1024] = {0};

/*
 * Callsign and 4-character Maidenhead grid entry for uDST / MBPTRX.
 * 240 x 135 display, drawn into the "lcd" sprite (TFT_eSPI2).
 */
#include "station_entry.h"

static void error_stop(const uint32_t err_code)
{
  // self-test error code
  pinMode(LED_BUILTIN,OUTPUT);
  digitalWrite(LED_BUILTIN,LOW);
  for (;;)
  {
    for (uint32_t i=0;i<err_code;i++)
    {
      digitalWrite(LED_BUILTIN,HIGH);
      delay(50);
      digitalWrite(LED_BUILTIN,LOW);
      delay(250);
    }
    delay(1000);
  }
}

static void run_spi_loopback_test(void)
{
  // connect GP7 to GP8 through a 220 Ohm resistor!
  // --- test parameters ---
  static const uint32_t XFER_GAP_US = 30;     // let each 32-bit transfer finish (~6 us) + margin
  static const uint32_t WINDOW = 16;          // rolling history depth for connect/disconnect decision
  static const uint32_t MATCH_THRESHOLD = 14; // >=14 of last 16 must match to call it "connected"

  // Test vectors chosen to expose specific failures:
  //   0x00000000 / 0xFFFFFFFF : stuck-high / stuck-low bits
  //   0xFFFF0000 / 0x0000FFFF : I-half vs Q-half not swapped
  //   0x80000001              : MSB and LSB positions specifically
  //   alternating + arbitrary : adjacent-bit and general integrity
  static const uint32_t patterns[] =
  {
    0x00000000u, 0xFFFFFFFFu, 0xA5A5A5A5u, 0x5A5A5A5Au,
    0x12345678u, 0x80000001u, 0xDEADBEEFu, 0x0000FFFFu,
    0xFFFF0000u
  };
  static const uint32_t NPAT = sizeof(patterns) / sizeof(patterns[0]);

  // Pull MISO down so a DISCONNECTED input reads a stable 0 (not floating
  // noise). The PIO already claimed the pin; the pad pull bits are independent
  // of the function select, so this is safe to set afterward.
  gpio_pull_down(PIN_IQMISO);
  pinMode(LED_BUILTIN, OUTPUT);

  // Rolling history of recent match results (1 = matched, 0 = mismatch).
  uint8_t hist[WINDOW] = {0};
  uint32_t hist_pos = 0;
  uint32_t match_in_win = 0;
  uint32_t prev_sent  = 0;
  bool have_prev = false;
  uint32_t idx = 0;
  uint32_t pass_total = 0;
  uint32_t fail_total = 0;
  uint32_t last_led_ms = 0;

  for (;;)
  {
    const uint32_t sent = patterns[idx % NPAT];
    const uint32_t got = iqSPI.doTransfer(sent);
    sleep_us(XFER_GAP_US); // let the transfer complete before next call

    // Pipeline: 'got' is the loopback of the PREVIOUS word, so compare to prev_sent.
    if (have_prev)
    {
      const uint8_t matched = (got == prev_sent) ? 1u : 0u;
      if (matched) pass_total++; else fail_total++;

      // slide the rolling window
      match_in_win -= hist[hist_pos];
      hist[hist_pos] = matched;
      match_in_win += matched;
      hist_pos = (hist_pos + 1) % WINDOW;
    }
    prev_sent = sent;
    have_prev = true;
    idx++;

    // "connected" if most of the recent window matched. The rolling window
    // tolerates the one ambiguous case (sending 0x00000000 while disconnected
    // also reads 0 via the pulldown) because the surrounding nonzero patterns
    // dominate the decision.
    const bool connected = (match_in_win >= MATCH_THRESHOLD);

    // live LED: fast blink = passing, slow blink = failing/disconnected
    const uint32_t now = millis();
    const uint32_t period = connected ? 100u : 600u;
    if (now - last_led_ms >= period)
    {
      digitalWrite(LED_BUILTIN, !digitalRead(LED_BUILTIN));
      last_led_ms = now;
    }
  }
}

// Verify the FPGA is alive by checking data_ready is toggling near 31 kHz.
// Returns true if a plausible pulse train is present, false otherwise.
// Call from setup(); on false, invoke error_stop(ERROR_FPGA).
static const bool check_fpga_data_ready(void)
{
  // data_ready is ~31.25 kHz, period ~32 us,
  // ~16 us high / ~16 us low. We don't measure exact frequency -- we just
  // confirm it's toggling at roughly the right rate, which separates "alive"
  // from "dead/disconnected/not-clocking"

  // Count edges over a fixed window and check the count is in a sane band.
  // Over 10 ms at 31.25 kHz we expect ~312 full cycles = ~625 edges.
  // exact clock doesn't matter; we're proving "alive", not measuring Hz.

  static const uint32_t window_us = 10000; // 10 ms observation
  static const uint32_t expect_edges = 625; // ~ at 31.25 kHz
  static const uint32_t min_edges = expect_edges / 2; // ~half rate -> still "alive"
  static const uint32_t max_edges = expect_edges * 2; // ~double rate -> sanity ceiling

  pinMode(PIN_DR, INPUT);
  uint32_t edges = 0;
  int last = digitalRead(PIN_DR);
  const absolute_time_t t_end = make_timeout_time_us(window_us);
  while (!time_reached(t_end))
  {
    const int now = digitalRead(PIN_DR);
    if (now != last)
    {
      edges++;
      last = now;
    }
  }
  return (edges >= min_edges) && (edges <= max_edges);
}

static void mute(void)
{
  digitalWrite(PIN_MUTE,LOW);
}

static void unmute(void)
{
  digitalWrite(PIN_MUTE,HIGH);
}

static void set_filter(void)
{
  // HPF
  static uint8_t old_hpf = 0;
  uint8_t new_hpf = 0;
  if (radio.frequency<5000000UL)
  {
    // HPF 3MHz
    new_hpf = 1;
  }
  else if (radio.frequency<8000000UL)
  {
    // HPF 4MHz
    new_hpf = 2;
  }
  else if (radio.frequency<16000000UL)
  {
    // HPF 8MHz
    new_hpf = 3;
  }
  else
  {
    // HPF 16MHz
    new_hpf = 4;
  }
  if (old_hpf != new_hpf)
  {
    old_hpf = new_hpf;
    switch (new_hpf)
    {
      case 1:
      {
        // HPF 3MHz
        lpf_port.output(I2C_PIN_HPF1,TCA9534::Level::H);
        lpf_port.output(I2C_PIN_HPF2,TCA9534::Level::H);
        break;
      }
      case 2:
      {
        // HPF 4MHz
        lpf_port.output(I2C_PIN_HPF1,TCA9534::Level::L);
        lpf_port.output(I2C_PIN_HPF2,TCA9534::Level::H);
        break;
      }
      case 3:
      {
        // HPF 8MHz
        lpf_port.output(I2C_PIN_HPF1,TCA9534::Level::H);
        lpf_port.output(I2C_PIN_HPF2,TCA9534::Level::L);
        break;
      }
      case 4:
      {
        // HPF 16MHz
        lpf_port.output(I2C_PIN_HPF1,TCA9534::Level::L);
        lpf_port.output(I2C_PIN_HPF2,TCA9534::Level::L);
        break;
      }
    }
  }

  // LPF
  static uint8_t old_lpf = 0;
  uint8_t new_lpf = I2C_PIN_LPF4;
  if (radio.frequency<6000000UL)
  {
    new_lpf = I2C_PIN_LPF1;
  }
  else if (radio.frequency<11000000UL)
  {
    new_lpf = I2C_PIN_LPF2;
  }
  else if (radio.frequency<20000000UL)
  {
    new_lpf = I2C_PIN_LPF3;
  }
  if (old_lpf != new_lpf)
  {
    old_lpf = new_lpf;
    lpf_port.output(I2C_PIN_LPF1,TCA9534::Level::L);
    lpf_port.output(I2C_PIN_LPF2,TCA9534::Level::L);
    lpf_port.output(I2C_PIN_LPF3,TCA9534::Level::L);
    lpf_port.output(I2C_PIN_LPF4,TCA9534::Level::L);
    lpf_port.output(new_lpf,TCA9534::Level::H);
  }
}

static void set_attenuator(void)
{
  TCA9534::Level attenuation = TCA9534::Level::L;
  if (radio.attenuator)
  {
    attenuation = TCA9534::Level::H;
  }
  lpf_port.output(I2C_PIN_ATT,attenuation);
}

static __attribute__((always_inline)) inline void display_clear(void)
{
  lcd.fillSprite(LCD_BLACK);
}

static __attribute__((always_inline)) inline void display_refresh(void)
{
  lcd.pushSprite(0,0);
}

static __attribute__((always_inline)) inline void enable_mic(void)
{
  adc_gpio_init(PIN_MIC);
  adc_select_input(MIC_MUX);
}

static __attribute__((always_inline)) inline void disable_mic(void)
{
  pinMode(PIN_MIC,OUTPUT);
  digitalWrite(PIN_MIC,LOW);
}

static void init_adc(void)
{
  adc_init();
  adc_gpio_init(PIN_MIC);
  adc_select_input(MIC_MUX);
}

static __attribute__((always_inline)) inline void adc_start_conversion(void)
{
  hw_set_bits(&adc_hw->cs, ADC_CS_START_ONCE_BITS);
}

static __attribute__((always_inline)) inline const int16_t get_adc(void)
{
  const uint16_t adc_raw = (uint16_t)adc_hw->result;
  return (int16_t)adc_raw-2048;
}

static void save_settings(void)
{
  static const uint32_t key = 0x12345678ul;
  mute();
  delay(100);
  EEPROM.begin(256);
  uint32_t i = 0;
  EEPROM.put(i,key);                             i += sizeof(uint32_t);
  EEPROM.put(i,(uint32_t)radio.cw_dit);          i += sizeof(uint32_t);
  EEPROM.put(i,(uint32_t)radio.cw_level);        i += sizeof(uint32_t);
  EEPROM.put(i,(uint32_t)radio.sidetone);        i += sizeof(uint32_t);
  EEPROM.put(i,(uint32_t)radio.cw_phase);        i += sizeof(uint32_t);
  EEPROM.put(i,(uint32_t)radio.spectype);        i += sizeof(uint32_t);
  EEPROM.put(i,(uint32_t)radio.jnrlevel);        i += sizeof(uint32_t);
  EEPROM.put(i,(uint32_t)radio.micgain);         i += sizeof(uint32_t);
  EEPROM.put(i,(uint32_t)radio.cessb?1u:0u);     i += sizeof(uint32_t);
  EEPROM.put(i,(uint32_t)radio.bandwidth);       i += sizeof(uint32_t);
  EEPROM.put(i,(uint32_t)radio.graph_swr?1u:0u); i += sizeof(uint32_t);
  for (uint32_t j=0;j<NUM_BANDS;j++)
  {
    EEPROM.put(i,(uint32_t)radio.level[j]);
    i += sizeof(uint32_t);
  }
  EEPROM.put(i,radio.callsign);
  i += sizeof(radio.callsign);
  EEPROM.put(i,radio.grid);
  EEPROM.end();
  unmute();
}

static void restore_settings(void)
{
  uint32_t key = 0 ;
  EEPROM.begin(256);
  EEPROM.get(0,key);
  if (key==0x12345678)
  {
    uint32_t i = sizeof(uint32_t);
    uint32_t data32 = 0;
    EEPROM.get(i,data32); radio.cw_dit   = data32; i += sizeof(uint32_t);
    EEPROM.get(i,data32); radio.cw_level = data32; i += sizeof(uint32_t);
    EEPROM.get(i,data32); radio.sidetone = data32; i += sizeof(uint32_t);
    EEPROM.get(i,data32); radio.cw_phase = data32; i += sizeof(uint32_t);
    EEPROM.get(i,data32); radio.spectype = data32; i += sizeof(uint32_t);
    EEPROM.get(i,data32); radio.jnrlevel = data32; i += sizeof(uint32_t);
    EEPROM.get(i,data32); radio.micgain  = data32; i += sizeof(uint32_t);
    EEPROM.get(i,data32); radio.cessb = data32==1?true:false; i += sizeof(uint32_t);
    EEPROM.get(i,data32); radio.bandwidth = data32; i += sizeof(uint32_t);
    EEPROM.get(i,data32); radio.graph_swr = data32==1?true:false; i += sizeof(uint32_t);
    for (uint32_t j=0;j<NUM_BANDS;j++)
    {
      EEPROM.get(i,data32);
      i += sizeof(uint32_t);
      radio.level[j] = (int8_t)data32;
      if (radio.level[j]<SPECTRUM_LEVEL_MIN || radio.level[j]>SPECTRUM_LEVEL_MAX)
      {
        radio.level[j] = 0;
      }
      radio.slevel[j] = radio.level[j];
    }
    EEPROM.get(i,radio.callsign);
    i += sizeof(radio.callsign);
    EEPROM.get(i,radio.grid);
    radio.callsign[STATION_CALL_MAX] = '\0';
    radio.grid[STATION_GRID_LEN] = '\0';
  }
  if (radio.cw_dit<40 || radio.cw_dit>120)
  {
    radio.cw_dit = DEFAULT_CW_SPEED;
  }
  if (radio.cw_level<1 || radio.cw_level>3)
  {
    radio.cw_level = DEFAULT_CW_LEVEL;
  }
  if (radio.sidetone<500 || radio.sidetone>850)
  {
    radio.sidetone = DEFAULT_SIDETONE;
  }
  radio.cw_phase = ((uint64_t)radio.sidetone * (1ull << 32)) / SAMPLERATE;
  if (radio.spectype!=SPECTRUM_WIND && radio.spectype!=SPECTRUM_GRASS)
  {
    radio.spectype = SPECTRUM_WIND;
  }
  if (radio.jnrlevel>3)
  {
    radio.jnrlevel = JNR_OFF;
  }
  if (radio.micgain<25ul || radio.micgain>200ul)
  {
    radio.micgain = DEFAULT_MICGAIN;
  }
  if (radio.bandwidth<1ul || radio.bandwidth>5ul)
  {
    radio.bandwidth = DEFAULT_BANDWIDTH;
  }
  EEPROM.end();
}

static void set_frequency(const uint32_t ft8_offset = 0u)
{
  constexpr uint64_t TWO32 = 1ULL << 32; // 2^32
  constexpr uint64_t DENOM = FPGA_CLK * 100ULL; // 80e6 Hz * 100 = 8e9
  const int32_t cwoffset = radio.tx_enable?0:radio.sidetone;
  int32_t rx_cwoffsetw = 0;
  switch (radio.mode)
  {
    case MODE_CWL: rx_cwoffsetw = +cwoffset;  break;
    case MODE_CWU: rx_cwoffsetw = -cwoffset;  break;
  }
  const uint64_t f_centiHz = 100ull * (radio.frequency+rx_cwoffsetw) + ft8_offset;
  // numerator = f_centiHz * 2^32  -- check this can't overflow 64 bits:
  //   max f_centiHz for 30 MHz = 3,000,000,000 (3e9)
  //   3e9 * 2^32 ~= 1.29e19, and uint64 max ~= 1.84e19 -> fits, but tightly.
  // Round-to-nearest: add half the denominator before dividing.
  const uint64_t num = f_centiHz * TWO32;
  const uint32_t tuning_word = (uint32_t)((num + DENOM/2) / DENOM);
  tw.write(tuning_word);
  return ;
}

void setup(void)
{
#ifdef DEBUG_STACKCHECK_CORE0
  stackpaint_core();
#endif

  // run UI on core 0
  pinMode(PIN_REG,OUTPUT);
  // set pico regulator to low noise
  digitalWrite(PIN_REG,HIGH);
  pinMode(LED_BUILTIN,OUTPUT);
  digitalWrite(LED_BUILTIN,HIGH);
  delay(1000);
  digitalWrite(LED_BUILTIN,LOW);
  vreg_set_voltage(VREG_VOLTAGE_1_30);
  const uint32_t clksys = frequency_count_khz(CLOCKS_FC0_SRC_VALUE_CLK_SYS);
  // frequency_count_khz() isn't accurate!
  if (clksys < (250000ul - 5ul) || clksys > (250000ul + 5ul))
  {
    // trap the wrong system clock
    error_stop(ERROR_SYSCLOCK);
  }
  pinMode(LED_BUILTIN,OUTPUT);
  pinMode(PIN_TXEN,OUTPUT);
  pinMode(PIN_MUTE,OUTPUT);
  pinMode(PIN_PTT,INPUT_PULLUP);
  pinMode(PIN_PADA,INPUT_PULLUP);
  pinMode(PIN_PADB,INPUT_PULLUP);
  pinMode(PIN_ENCBUT,INPUT_PULLUP);
  pinMode(PIN_DR,INPUT);

#ifndef SPI_LOOPBACK_TEST
  if (!check_fpga_data_ready())
  {
    // FPGA not present
    error_stop(ERROR_FPGA);
  }
#endif

  // ensure TX is off
  digitalWrite(PIN_TXEN, LOW);

  // mute until ready
  digitalWrite(PIN_MUTE, LOW);

  // high speed I2C
  Wire.setSDA(PIN_SDA);
  Wire.setSCL(PIN_SCL);
  Wire.setClock(400000ul);
  Wire.begin();

  // filters and attenuator control
  lpf_port.attach(Wire);
#ifndef SPI_LOOPBACK_TEST
  if (!lpf_port.setDeviceAddress(LPF_I2C_ADDRESS))
  {
    error_stop(ERROR_LPF);
  }
  lpf_port.config(TCA9534::Config::OUT);
  lpf_port.polarity(TCA9534::Polarity::ORIGINAL);
  lpf_port.output(I2C_PIN_LPF1,TCA9534::Level::L);
  lpf_port.output(I2C_PIN_LPF2,TCA9534::Level::L);
  lpf_port.output(I2C_PIN_LPF3,TCA9534::Level::L);
  lpf_port.output(I2C_PIN_LPF4,TCA9534::Level::L);
  lpf_port.output(I2C_PIN_ATT,TCA9534::Level::L);
  lpf_port.output(I2C_PIN_HPF1,TCA9534::Level::L);
  lpf_port.output(I2C_PIN_HPF2,TCA9534::Level::L);
#endif
  delay(40);
  digitalWrite(LED_BUILTIN,LOW);

  // TX unsafe if PTT enabled at start up
  if (digitalRead(PIN_PTT)==HIGH && digitalRead(PIN_PADA)==HIGH && digitalRead(PIN_PADB)==HIGH)
  {
    radio.tx_safe = true;
  }

  // set up audio out PWM
  gpio_set_function(PIN_AUPWMH,GPIO_FUNC_PWM);
  gpio_set_function(PIN_AUPWML,GPIO_FUNC_PWM);
  audio_pwm = pwm_gpio_to_slice_num(PIN_AUPWML);
  pwm_set_wrap(audio_pwm,63); // 250,000,000 / 64 = 3,906,250
  pwm_set_both_levels(audio_pwm,0,31);
  pwm_set_enabled(audio_pwm,true);

#ifdef DEBUG_LED
  pinMode(LED_BUILTIN,OUTPUT);
  for (int i=0;i<2;i++)
  {
    digitalWrite(LED_BUILTIN,HIGH);
    delay(10);
    digitalWrite(LED_BUILTIN,LOW);
    delay(250);
  }
#endif

  // set default frequency
  SPI1.setSCK(PIN_TWSCK);
  SPI1.setTX(PIN_TWMOSI);
  tw.begin();
  set_frequency();

#ifdef DEBUG_LED
  pinMode(LED_BUILTIN,OUTPUT);
  for (int i=0;i<2;i++)
  {
    digitalWrite(LED_BUILTIN,HIGH);
    delay(50);
    digitalWrite(LED_BUILTIN,LOW);
    delay(250);
  }
#endif

#ifndef SPI_LOOPBACK_TEST
  if (!fwdADC.begin(0))
  {
    error_stop(ERROR_FWDADC);
  }
  if (!refADC.begin(1))
  {
    error_stop(ERROR_REFADC);
  }
#endif

#ifdef DEBUG_LED
  pinMode(LED_BUILTIN,OUTPUT);
  for (int i=0;i<2;i++)
  {
    digitalWrite(LED_BUILTIN,HIGH);
    delay(50);
    digitalWrite(LED_BUILTIN,LOW);
    delay(250);
  }
#endif

#ifdef SPI_LOOPBACK_TEST
  run_spi_loopback_test();
#endif

  // init rotary
  r.begin();

  // init critical radio defaults
  radio.frequency = DEFAULT_FREQUENCY;
  radio.band = DEFAULT_BAND;
  radio.mode = DEFAULT_MODE;
  restore_settings();
  set_filter();

  // notch init and not enabled
  // default frequency
  // bandwidth and depth (dB)
  DSP::notch.init(31250.0f);
  DSP::notch.set((float)DEFAULT_NOTCH, 100.0f, 30.0f);
  DSP::notch.enable(false);

#ifdef DEBUG_LED
  pinMode(LED_BUILTIN,OUTPUT);
  for (int i=0;i<2;i++)
  {
    digitalWrite(LED_BUILTIN,HIGH);
    delay(10);
    digitalWrite(LED_BUILTIN,LOW);
    delay(250);
  }
#endif

  // set up mic ADC
  init_adc();

  // disable Mic in RX mode
  disable_mic();

  // init LCD
  char sz_clksys[16] = "";
  memset(sz_clksys,0,sizeof(sz_clksys));
  memset((char*)sz_version,0,sizeof(sz_version));
  ultoa(clksys,sz_clksys,10);
  sz_clksys[3] = '\0';
  strcpy((char*)sz_version,VERSION_STRING);
  strcat((char*)sz_version,sz_clksys);
  tft.init();
  tft.setRotation(1);
  tft.fillScreen(LCD_BLACK);
  tft.displayOn();
  lcd.createSprite(LCD_WIDTH, LCD_HEIGHT);
  lcd.fillSprite(LCD_BLACK);
  lcd.pushSprite(0,0);
  for (uint32_t i=0;i<32;i++)
  {
    lcd.fillSprite(LCD_BLACK);
    lcd.setFreeFont(&FreeSansBold18pt7b);
    lcd.setTextSize(1);
    lcd.setTextColor(spectrum::color_map_32[i],LCD_BLACK);
    lcd.setCursor(POS_SPLASH_X,POS_SPLASH_Y);
    lcd.print("uDST");
    lcd.setTextFont(1);
    lcd.setTextSize(1);
    lcd.setTextColor(LCD_WHITE,LCD_BLACK);
    lcd.setCursor(POS_VERSION_X,POS_VERSION_Y);
    lcd.print((const char*)sz_version);
    lcd.pushSprite(0,0);
    delay(50);
  }
  delay(250);

  // make sure callsign is valid
  if (!check_station_details())
  {
#ifdef USER_CALL
    memset((char*)radio.callsign,0,sizeof(radio.callsign));
    memset((char*)radio.grid,0,sizeof(radio.grid));
    strncpy((char*)radio.callsign,USER_CALL,sizeof(radio.callsign)-1);
    strncpy((char*)radio.grid,USER_GRID,sizeof(radio.grid)-1);
#else
    enter_station_details();
#endif
    save_settings();
    delay(2000);
  }

  // intro screen
  lcd.setTextFont(1);
  lcd.setTextSize(1);
  lcd.fillSprite(LCD_BLACK);
  lcd.setTextColor(LCD_WHITE,LCD_BLACK);
  lcd.setCursor(POS_VERSION_X,POS_VERSION_Y);
  lcd.print((const char*)sz_version);
  lcd.setFreeFont(&FreeSansBold18pt7b);
  lcd.setCursor(POS_CALL_X,POS_SPLASH_Y);
  lcd.print((const char*)radio.callsign);
  lcd.pushSprite(0,0);
  lcd.setTextFont(1);

  for (uint8_t i=0;i<sizeof(cw_decode_buf);i++)
  {
    cw_decode_buf[i] = '\0';
  }

  // splash delay
  delay(2000);

  // unmute
  unmute();

  setup_complete = true;
}

void setup1(void)
{
  // run DSP on core 1
  // only go to loop1 when setup() has completed
#ifdef DEBUG_STACKCHECK_CORE1
  stackpaint_core();
#endif
  while (!setup_complete)
  {
    tight_loop_contents();
  }
#ifdef DEBUG_LED
  pinMode(LED_BUILTIN,OUTPUT);
  for (int i=0;i<5;i++)
  {
    digitalWrite(LED_BUILTIN,HIGH);
    delay(100);
    digitalWrite(LED_BUILTIN,LOW);
    delay(250);
  }
#endif
}

static void show_frequency(void)
{
  const uint16_t tx_rx = radio.tx_enable?LCD_RED:LCD_WHITE;
  const uint16_t fcolour = radio.tx_safe?tx_rx:LCD_YELLOW;
  char sz_frequency[16] = "";
  memset(sz_frequency,0,sizeof(sz_frequency));
  ultoa(radio.frequency,sz_frequency,10);
  if (radio.frequency<1000000u)
  {
    // 6 digits
    //            012 345
    // 936000 ->  936.000
    // 012345    01234567
    sz_frequency[7] = sz_frequency[5];
    sz_frequency[6] = sz_frequency[4];
    sz_frequency[5] = sz_frequency[3];
    sz_frequency[4] = '.';
    sz_frequency[3] = sz_frequency[2];
    sz_frequency[2] = sz_frequency[1];
    sz_frequency[1] = sz_frequency[0];
    sz_frequency[0] = ' ';
  }
  else if (radio.frequency<10000000u)
  {
    // 7 digits
    // 3555000 -> 3.555.000
    // 0123456    012345678
    sz_frequency[9] = sz_frequency[6];
    sz_frequency[8] = sz_frequency[5];
    sz_frequency[7] = sz_frequency[4];
    sz_frequency[6] = '.';
    sz_frequency[5] = sz_frequency[3];
    sz_frequency[4] = sz_frequency[2];
    sz_frequency[3] = sz_frequency[1];
    sz_frequency[2] = '.';
    sz_frequency[1] = sz_frequency[0];
    sz_frequency[0] = ' ';
  }
  else
  {
    // 8 digits
    // 14222000 -> 14.222.000
    // 01234567    0123456789
    sz_frequency[9] = sz_frequency[7];
    sz_frequency[8] = sz_frequency[6];
    sz_frequency[7] = sz_frequency[5];
    sz_frequency[6] = '.';
    sz_frequency[5] = sz_frequency[4];
    sz_frequency[4] = sz_frequency[3];
    sz_frequency[3] = sz_frequency[2];
    sz_frequency[2] = '.';
  }
  lcd.setFreeFont(&Arial_Bold16pt7b);
  lcd.setTextSize(1);
  lcd.setTextColor(fcolour,LCD_BLACK);
  lcd.setCursor(POS_FREQUENCY_X,POS_FREQUENCY_Y);
  lcd.print(sz_frequency);
  lcd.setTextFont(1);
}

static void show_tuning_step(void)
{
  if (radio.tx_enable)
  {
    return;
  }
  lcd.setTextSize(1);
  lcd.setCursor(POS_TUNING_STEP_X-30,POS_TUNING_STEP_Y);
  lcd.setTextColor(LCD_WHITE);
  lcd.print("STEP");
  lcd.setCursor(POS_TUNING_STEP_X,POS_TUNING_STEP_Y);
  lcd.setTextColor(LCD_WHITE);
  lcd.print(radio.step);
}

// ---------------------------------------------------------------------------
// Non-linear meter scale, shared by the PO and SWR bargraphs.
// Knot values are in hundredths (100 = 1.0), positions are per-mille of the
// bar (1000 = full scale). Bottom of the range is expanded so that 1.0..3.0
// occupies the first ~55% of the bar. Retune here only; nothing else changes.
// ---------------------------------------------------------------------------
#define METER_SEGMENTS   16u
#define METER_PITCH       5u
#define METER_BLOCK       4u
#define METER_BAR_WIDTH  (METER_SEGMENTS*METER_PITCH)   // 90 px
#define METER_PO_FS      1000u                          // 10.0 W full scale

struct meter_knot_t { uint16_t value; uint16_t pos; };
static const meter_knot_t METER_SCALE[] =
{
  {    0u,    0u },
  {  100u,   60u },
  {  200u,  320u },
  {  300u,  550u },
  {  500u,  760u },
  {  700u,  890u },
  { 1000u, 1000u }
};
static const uint8_t METER_KNOTS = sizeof(METER_SCALE)/sizeof(METER_SCALE[0]);
struct meter_label_t { uint16_t value; const char *text; };
static const meter_label_t METER_LABELS[] =
{
  {  100u, "1"  },
  {  200u, "2"  },
  {  300u, "3"  },
  {  500u, "5"  },
  { 1000u, "10" }
};
static const uint8_t METER_LABEL_COUNT = sizeof(METER_LABELS)/sizeof(METER_LABELS[0]);

// value in hundredths -> number of lit blocks (0..METER_SEGMENTS)
static uint8_t meter_blocks(uint32_t value)
{
  uint32_t pos = 1000ul;
  if (value<=(uint32_t)METER_SCALE[0].value)
  {
    pos = METER_SCALE[0].pos;
  }
  else for (uint8_t i=1u;i<METER_KNOTS;i++)
  {
    if (value<(uint32_t)METER_SCALE[i].value)
    {
      const uint32_t v0 = METER_SCALE[i-1u].value;
      const uint32_t p0 = METER_SCALE[i-1u].pos;
      const uint32_t v1 = METER_SCALE[i].value;
      const uint32_t p1 = METER_SCALE[i].pos;
      pos = p0 + ((value-v0)*(p1-p0))/(v1-v0);
      break;
    }
  }
  return (uint8_t)((pos*METER_SEGMENTS + 500ul)/1000ul);
}

static void show_swr(void)
{
  static const uint32_t PO_DECAY_RATE = 250ul;
  static const float A = 0.141570128f;
  static const float B = 5.64859373f;
  volatile static uint32_t max_po = 0; 
  volatile static uint32_t po_decay = 0;
  if (!radio.tx_enable)
  {
    max_po = 0;
    return;
  }
  const uint32_t adc_fwd_raw = (uint32_t)fwdADC.read();
  const uint32_t adc_ref_raw = (uint32_t)refADC.read();
  if (adc_fwd_raw==0xffffu || adc_ref_raw==0xffffu)
  {
    return;
  }

  // vswr
  uint32_t vswr = 100u;
  const float adcfwd = (float)(FILTER::ma1(adc_fwd_raw));
  const float adcref = (float)(FILTER::ma2(adc_ref_raw));
  const float vfwd = A * adcfwd + B;
  const float vref = A * adcref + (adcref>2.0f?B:0.0f);
  if (vfwd>vref)
  {
    vswr = (uint32_t)(100.0f * (vfwd + vref) / (vfwd - vref));
    vswr = constrain(vswr,100u,999u);
  }
  // power out
  // Vpp * Vpp / 400
  const uint32_t now = millis();
  const float fwd = A * (float)adc_fwd_raw + (adc_fwd_raw>2?B:0.0f);
  const uint32_t po = (uint32_t)(((fwd * fwd) / 400.0f) * 10.0f + 0.5f);
  if (po<max_po)
  {
    if (now>po_decay)
    {
      if (max_po>0) max_po--;
      po_decay = now + PO_DECAY_RATE;
    }
  }
  else
  {
    max_po = po;
    po_decay = now + PO_DECAY_RATE;
  }

  // show power and SWR
  if (radio.graph_swr)
  {
    // scale labels, positioned from the same warp as the bars
    lcd.setTextSize(1);
    lcd.setTextColor(LCD_WHITE,LCD_BLACK);
    for (uint8_t i=0u;i<METER_LABEL_COUNT;i++)
    {
      const int16_t tick = (int16_t)(meter_blocks(METER_LABELS[i].value)*METER_PITCH);
      const int16_t w = (int16_t)(strlen(METER_LABELS[i].text)*6u - 1u);
      int16_t x = tick - w/2;
      if (x<0) x = 0;
      if (x+w > (int16_t)METER_BAR_WIDTH) x = (int16_t)METER_BAR_WIDTH - w;
      lcd.setCursor(POS_METER_X+x,POS_METER_Y+2);
      lcd.print(METER_LABELS[i].text);
    }
    // graph power (max_po is in 0.1W, so x10 gives hundredths)
    const uint8_t p = meter_blocks(min(max_po*10ul,(uint32_t)METER_PO_FS));
    for (uint8_t i=0u;i<p;i++)
    {
      lcd.fillRect(POS_METER_X+i*METER_PITCH,POS_METER_Y+14,METER_BLOCK,METER_BLOCK,LCD_WHITE);
    }
    // graph SWR (vswr is already in hundredths)
    const uint8_t s = meter_blocks(vswr);
    for (uint8_t i=0u;i<s;i++)
    {
      const uint32_t c = i>3u?LCD_RED:LCD_WHITE;
      lcd.fillRect(POS_METER_X+i*METER_PITCH,POS_METER_Y+20,METER_BLOCK,METER_BLOCK,c);
    }
  }
  else
  {
    // display SWR
    char sz_swr[16] = "";
    memset(sz_swr,0,sizeof(sz_swr));
    ultoa(vswr,sz_swr,10);
    sz_swr[3] = sz_swr[2];
    sz_swr[2] = sz_swr[1];
    sz_swr[1] = '.';
    lcd.setTextSize(1);
    lcd.setCursor(POS_SWR_X-25,POS_SWR_Y);
    lcd.setTextColor(LCD_WHITE);
    lcd.print("SWR");
    lcd.setCursor(POS_SWR_X-5,POS_SWR_Y);
    lcd.setTextColor(LCD_WHITE);
    lcd.print(sz_swr);

    // display power
    char sz_po[16] = "";
    memset(sz_po,0,sizeof(sz_po));
    ultoa(max_po,sz_po,10);
    if (max_po<10)
    {
      sz_po[2] = sz_po[0];
      sz_po[1] = '.';
      sz_po[0] = '0';
    }
    else if (max_po<100)
    {
      sz_po[2] = sz_po[1];
      sz_po[1] = '.';
    }
    else
    {
      sz_po[3] = sz_po[2];
      sz_po[2] = '.';
    }
    lcd.setCursor(POS_SWR_X+25,POS_SWR_Y);
    lcd.print("PO");
    lcd.setCursor(POS_SWR_X+40,POS_SWR_Y);
    lcd.print(sz_po);
  }
}

static void show_tx(void)
{
  lcd.setTextSize(1);
  lcd.setFreeFont(&FreeSansBold9pt7b);
  lcd.setCursor(POS_TX_X,POS_TX_Y);
  lcd.setTextColor(LCD_WHITE);
  lcd.print("TX");
  lcd.setCursor(POS_RX_X,POS_RX_Y);
  lcd.setTextColor(LCD_BLUE);
  lcd.print("RX");
  lcd.setTextFont(1);
}

static void show_rx(void)
{
  lcd.setTextSize(1);
  lcd.setFreeFont(&FreeSansBold9pt7b);
  lcd.setCursor(POS_TX_X,POS_TX_Y);
  lcd.setTextColor(LCD_BLUE);
  lcd.print("TX");
  lcd.setCursor(POS_RX_X,POS_RX_Y);
  lcd.setTextColor(LCD_WHITE);
  lcd.print("RX");
  lcd.setTextFont(1);
}

static void show_swl(void)
{
  lcd.setTextSize(1);
  lcd.setFreeFont(&FreeSansBold9pt7b);
  lcd.setCursor(POS_TX_X,POS_TX_Y);
  lcd.setTextColor(radio.tx_button?LCD_RED:LCD_GREEN);
  lcd.print("TX");
  lcd.setCursor(POS_RX_X,POS_RX_Y);
  lcd.setTextColor(radio.tx_button?LCD_RED:LCD_GREEN);
  lcd.print("RX");
  lcd.setTextFont(1);
}

static void show_rx_tx(void)
{
  if ((radio.band==BAND_SWL) || (radio.mode==MODE_AM))
  {
    show_swl();
  }
  else if (radio.tx_enable)
  {
    show_tx();
  }
  else
  {
    show_rx();
  }
}

static void show_mode(void)
{
  lcd.fillRect(POS_MODE_X-5,POS_MODE_Y-5,45,25,LCD_WHITE);
  lcd.setTextSize(2);
  lcd.setTextColor(LCD_BLACK);
  lcd.setCursor(POS_MODE_X,POS_MODE_Y);
  const char *sz_mode = "XXX";
  if (radio.tx_enable)
  {
    // no TX in AM
    switch (radio.mode)
    {
      case MODE_LSB: sz_mode = "LSB"; break;
      case MODE_USB: sz_mode = "USB"; break;
      case MODE_CWL: sz_mode = "CWL"; break;
      case MODE_CWU: sz_mode = "CWU"; break;
      case MODE_DGL: sz_mode = "DGL"; break;
      case MODE_DGU: sz_mode = "DGU"; break;
      case MODE_FT8: sz_mode = "FT8"; break;
    }
  }
  else
  {
    switch (radio.mode)
    {
      case MODE_LSB: sz_mode = "LSB"; break;
      case MODE_USB: sz_mode = "USB"; break;
      case MODE_CWL: sz_mode = "CWL"; break;
      case MODE_CWU: sz_mode = "CWU"; break;
      case MODE_DGL: sz_mode = "DGL"; break;
      case MODE_DGU: sz_mode = "DGU"; break;
      case MODE_FT8: sz_mode = "FT8"; break;
      case MODE_AM:  sz_mode = "AM";  break;
    }
  }
  lcd.print(sz_mode);
}

static void show_band(void)
{
  const uint32_t background = (radio.band==BAND_SWL)?LCD_RED:LCD_PURPLE;
  lcd.fillRect(POS_BAND_X-5,POS_BAND_Y-5,45,25,background);
  lcd.setTextSize(2);
  lcd.setTextColor(LCD_WHITE);
  lcd.setCursor(POS_BAND_X,POS_BAND_Y);
  const char *sz_band = "";
  switch (radio.band)
  {
    case BAND_80M: sz_band = "80M"; break;
    case BAND_40M: sz_band = "40M"; break;
    case BAND_30M: sz_band = "30M"; break;
    case BAND_20M: sz_band = "20M"; break;
    case BAND_17M: sz_band = "17M"; break;
    case BAND_15M: sz_band = "15M"; break;
    case BAND_12M: sz_band = "12M"; break;
    case BAND_10M: sz_band = "10M"; break;
    case BAND_SWL: sz_band = "SWL"; break;
  }
  lcd.print(sz_band);
}

static void show_cpu_usage(void)
{
  static uint32_t cpu_usage = 0;
  static uint32_t next_update = 0;
  const uint32_t now = millis();
  if (now>next_update)
  {
    next_update = now + 1000ul;
    const uint32_t usage = cpu.usage;
    const uint32_t count = cpu.count;
    cpu.usage = 0;
    cpu.count = 0;
    cpu_usage = (100u * usage / count) >> 5;
  }
  lcd.fillRect(POS_CPU_X-5,POS_CPU_Y-5,45,25,LCD_RED);
  lcd.setTextSize(2);
  lcd.setTextColor(LCD_WHITE);
  lcd.setCursor(POS_CPU_X,POS_CPU_Y);
  lcd.print(cpu_usage);
  if (cpu_usage<100)
  {
    lcd.print("%");
  }
}

static void show_overflow(void)
{
  static constexpr uint32_t HOLD_MS = 1000;
  static uint32_t red_start = 0;
  static uint32_t green_start = 0;
  static bool red_on = false;
  static bool green_on = false;

  const uint32_t now = millis();
  const uint8_t level = overflow;
  overflow = 0;

  if (level == 2)
  {
    red_on = true;
    red_start = now;
  }
  else if (level == 1)
  {
    green_on = true;
    green_start = now;
  }

  if (red_on && (now - red_start) >= HOLD_MS) red_on = false;
  if (green_on && (now - green_start) >= HOLD_MS) green_on = false;
  if (!red_on && !green_on) return;

  lcd.fillRect(POS_OVERFLOW_X-5,POS_OVERFLOW_Y-5,45,25,red_on?LCD_DARKRED:LCD_GREEN);
  lcd.setTextSize(2);
  lcd.setTextColor(LCD_WHITE);
  lcd.setCursor(POS_OVERFLOW_X,POS_OVERFLOW_Y);
  lcd.print("OVR");
}

static void show_notch(void)
{
  if (radio.tx_enable)
  {
    return;
  }
  if (radio.notch_enable)
  {
    lcd.drawRect(POS_NOTCH_X,POS_NOTCH_Y,12,11,LCD_RED);
    lcd.setCursor(POS_NOTCH_X+3,POS_NOTCH_Y+2);
    lcd.setTextSize(1);
    lcd.print("T");
  }
}

static void show_jnr(void)
{
  if (radio.jnrlevel==0)
  {
    return;
  }
  if (radio.mode==MODE_DGU || radio.mode==MODE_DGL || radio.mode==MODE_FT8)
  {
    // no JNR for digital modes
    return;
  }
  lcd.fillRect(POS_JNR_X-5,POS_JNR_Y-1,45,10,LCD_PURPLE);
  lcd.setTextSize(1);
  lcd.setTextColor(LCD_WHITE);
  lcd.setCursor(POS_JNR_X,POS_JNR_Y);
  switch (radio.jnrlevel)
  {
    case 1u: lcd.print("JNR:1"); break;
    case 2u: lcd.print("JNR:2"); break;
    case 3u: lcd.print("JNR:3"); break;
  }
}

static void show_debug_value(const int32_t v1,const int32_t v2 = 0)
{
  if (v1 != 0)
  {
    lcd.setTextSize(2);
    lcd.setTextColor(LCD_WHITE);
    lcd.setCursor(POS_DEBUG1_X,POS_DEBUG1_Y);
    lcd.print(v1);
  }
  if (v2 != 0)
  {
    lcd.setTextSize(2);
    lcd.setTextColor(LCD_WHITE);
    lcd.setCursor(POS_DEBUG2_X,POS_DEBUG2_Y);
    lcd.print(v2);
  }
}

static void show_meter_dial(const uint8_t sig)
{
  if (radio.graph_swr && radio.tx_enable)
  {
    return;
  }
  const uint8_t v = min(sig,15);
  lcd.setTextSize(1);
  lcd.setCursor(POS_METER_X,POS_METER_Y);
  lcd.setTextColor(LCD_WHITE);
  lcd.print("1 3 5 7 9 +20");
  for (uint8_t i=0;i<v;i++)
  {
    const uint32_t c = i<11?LCD_WHITE:LCD_RED;
    lcd.fillRect(POS_METER_X+i*5+0,POS_METER_Y+8,4,4,c);
  }
}

static void show_attenuator(void)
{
  if (radio.tx_enable)
  {
    return;
  }
  if (radio.attenuator)
  {
    lcd.drawRect(POS_ATT_X,POS_ATT_Y,12,11,LCD_RED);
    lcd.setCursor(POS_ATT_X+3,POS_ATT_Y+2);
    lcd.print("T");
  }
}

static void show_cw_settings(void)
{
  if (set_spectrum_level || adj_spectrum_level)
  {
    return;
  }
  if (radio.mode==MODE_CWL || radio.mode==MODE_CWU)
  {
    lcd.setTextSize(1);
    lcd.setTextColor(LCD_YELLOW);
    lcd.setCursor(POS_CW_SETTINGS_X,POS_CW_SETTINGS_Y);
    const char *sz_wpm = "";
    switch (radio.cw_dit)
    {
      case 120u: sz_wpm = "10"; break;
      case 80u:  sz_wpm = "15"; break;
      case 60u:  sz_wpm = "20"; break;
      case 48u:  sz_wpm = "25"; break;
      case 40u:  sz_wpm = "30"; break;
    }
    lcd.print("WPM:");
    lcd.print(sz_wpm);
    const char *sz_level = "";
    switch (radio.cw_level)
    {
      case 1u: sz_level = "LOW"; break;
      case 2u: sz_level = "MED"; break;
      case 3u: sz_level = "HI";  break;
    }
    lcd.print(" Level:");
    lcd.print(sz_level);
    lcd.print(" Sidetone:");
    lcd.print(radio.sidetone);
    if (radio.cwdecode!=0)
    {
      lcd.drawRect(176,POS_CW_SETTINGS_Y-2,12,11,LCD_RED);
      lcd.setCursor(179,POS_CW_SETTINGS_Y);
      lcd.print(radio.cwdecode==1?"A":"S");
    }
  }
}

static void show_cessb_settings(void)
{
  if (set_spectrum_level || adj_spectrum_level)
  {
    lcd.setTextSize(1);
    lcd.setTextColor(LCD_GREEN);
    lcd.setCursor(POS_CESSB_MIC_X,POS_CESSB_MIC_Y);
    lcd.print("Spectrum Level: ");
    lcd.print(radio.level[radio.band]*6);
    lcd.print("dB");
  }
  else if (adj_notch_filter)
  {
    lcd.setTextSize(1);
    lcd.setTextColor(LCD_GREEN);
    lcd.setCursor(POS_CESSB_MIC_X,POS_CESSB_MIC_Y);
    lcd.print("Notch: ");
    lcd.print(radio.notch);
    lcd.print("Hz");
  }
  else
  {
    if (radio.mode==MODE_FT8)
    {
      lcd.setTextSize(1);
      lcd.setTextColor(LCD_GREEN);
      lcd.setCursor(POS_CESSB_MIC_X,POS_CESSB_MIC_Y);
      lcd.print("AGC:Off");
      lcd.print(" BW:3000Hz");
      lcd.print(" CESSB:Off");
      lcd.print(" NB:Off");
    }
    else if (radio.mode==MODE_DGU || radio.mode==MODE_DGL)
    {
      lcd.setTextSize(1);
      lcd.setTextColor(LCD_GREEN);
      lcd.setCursor(POS_CESSB_MIC_X,POS_CESSB_MIC_Y);
      lcd.print("Vox:On");
      lcd.print(" BW:3000Hz");
      lcd.print(" CESSB:Off");
      lcd.print(" NB:Off");
    }
    else if (radio.mode==MODE_LSB || radio.mode==MODE_USB)
    {
      lcd.setTextSize(1);
      lcd.setTextColor(LCD_GREEN);
      lcd.setCursor(POS_CESSB_MIC_X,POS_CESSB_MIC_Y);
      lcd.print("CESSB:");
      lcd.print(radio.cessb?"On":"Off");
      lcd.setCursor(POS_CESSB_MIC_X+58,POS_CESSB_MIC_Y);
      if (radio.micproc==0)
      {
        lcd.print("Mic:");
        lcd.print(radio.micgain);
        lcd.print("%");
      }
      else
      {
        lcd.setTextColor(LCD_RED);
        lcd.print("Mic:");
        lcd.print(radio.micproc);
        lcd.print("P");
        lcd.setTextColor(LCD_GREEN);
      }
      lcd.setCursor(POS_CESSB_MIC_X+110,POS_CESSB_MIC_Y);
      lcd.print("BW:");
      switch (radio.bandwidth)
      {
        case 1: lcd.print("2000Hz"); break;
        case 2: lcd.print("2200Hz"); break;
        case 3: lcd.print("2400Hz"); break;
        case 4: lcd.print("2600Hz"); break;
        case 5: lcd.print("2800Hz"); break;
      }
      lcd.setCursor(POS_CESSB_MIC_X+168,POS_CESSB_MIC_Y);
      switch (radio.nblevel)
      {
        case 0: lcd.print("NB0"); break;
        case 1: lcd.print("NB1"); break;
        case 2: lcd.print("NB2"); break;
        case 3: lcd.print("NB3"); break;
        case 4: lcd.print("NB4"); break;
        case 5: lcd.print("NB5"); break;
      }
    }
  }
}

static void show_cw_decode(void)
{
  static char z_buf[32] = "";
  if (radio.cwdecode==0)
  {
    return;
  }
  if (!(radio.mode==MODE_CWU || radio.mode==MODE_CWL))
  {
    return;
  }
  if (!mutex_try_enter(&cw_decode_mutex,0ul))
  {
    return;
  }
  strcpy(z_buf,(char*)cw_decode_buf);
  mutex_exit(&cw_decode_mutex);
  lcd.fillRect(0,115,240,20,LCD_BLACK);
  lcd.setTextSize(2);
  lcd.setTextColor(LCD_WHITE);
  lcd.setCursor(0,116);
  lcd.print(z_buf);
}

static void show_spectrum(void)
{
  // show the spectrum
  static constexpr uint32_t SSB_WIDTH = 25;
  static constexpr uint32_t DGL_WIDTH = 30;
  static constexpr uint32_t AM_WIDTH = 50;
  lcd.setTextSize(1);
  lcd.setTextColor(LCD_WHITE);
  lcd.setCursor(0,POS_WATER_Y+4);
  lcd.print("-14KHz");
  lcd.setCursor(LCD_WIDTH-38,POS_WATER_Y+4);
  lcd.print("+14KHz");

  if (radio.tx_enable)
  {
    switch (radio.mode)
    {
      case MODE_LSB:
      {
        for (uint32_t x=0;x<SSB_WIDTH;x++)
        {
          lcd.drawLine(POS_CENTER_RIGHT-x,POS_WATER_Y,POS_CENTER_RIGHT-x,POS_WATER_Y+31,LCD_MODE);
        }
        break;
      }
      case MODE_USB:
      {
        for (uint32_t x=0;x<SSB_WIDTH;x++)
        {
          lcd.drawLine(POS_CENTER_RIGHT+x,POS_WATER_Y,POS_CENTER_RIGHT+x,POS_WATER_Y+31,LCD_MODE);
        }
        break;
      }
      case MODE_DGL:
      {
        for (uint32_t x=0;x<DGL_WIDTH;x++)
        {
          lcd.drawLine(POS_CENTER_RIGHT-x,POS_WATER_Y,POS_CENTER_RIGHT-x,POS_WATER_Y+31,LCD_MODE);
        }
        break;
      }
      case MODE_DGU:
      {
        for (uint32_t x=0;x<DGL_WIDTH;x++)
        {
          lcd.drawLine(POS_CENTER_RIGHT+x,POS_WATER_Y,POS_CENTER_RIGHT+x,POS_WATER_Y+31,LCD_MODE);
        }
        break;
      }
      case MODE_FT8:
      {
        for (uint32_t x=0;x<DGL_WIDTH;x++)
        {
          lcd.drawLine(POS_CENTER_RIGHT+x,POS_WATER_Y,POS_CENTER_RIGHT+x,POS_WATER_Y+31,LCD_MODE);
        }
        break;
      }
      case MODE_CWL:
      {
        for (uint32_t x=0;x<5;x++)
        {
          lcd.drawLine(POS_CENTER_LEFT-x,POS_WATER_Y,POS_CENTER_LEFT-x,POS_WATER_Y+31,LCD_MODE);
        }
        break;
      }
      case MODE_CWU:
      {
        for (uint32_t x=0;x<5;x++)
        {
          lcd.drawLine(POS_CENTER_RIGHT+x,POS_WATER_Y,POS_CENTER_RIGHT+x,POS_WATER_Y+31,LCD_MODE);
        }
        break;
      }
    }
  }
  else
  {
    // receive
    switch (radio.mode)
    {
      case MODE_LSB:
      {
        for (uint32_t x=0;x<SSB_WIDTH;x++)
        {
          lcd.drawLine(POS_CENTER_LEFT-x,POS_WATER_Y,POS_CENTER_LEFT-x,POS_WATER_Y+31,LCD_MODE);
        }
        break;
      }
      case MODE_USB:
      {
        for (uint32_t x=0;x<SSB_WIDTH;x++)
        {
          lcd.drawLine(POS_CENTER_RIGHT+x,POS_WATER_Y,POS_CENTER_RIGHT+x,POS_WATER_Y+31,LCD_MODE);
        }
        break;
      }
      case MODE_DGL:
      {
        for (uint32_t x=0;x<DGL_WIDTH;x++)
        {
          lcd.drawLine(POS_CENTER_LEFT-x,POS_WATER_Y,POS_CENTER_LEFT-x,POS_WATER_Y+31,LCD_MODE);
        }
        break;
      }
      case MODE_DGU:
      {
        for (uint32_t x=0;x<DGL_WIDTH;x++)
        {
          lcd.drawLine(POS_CENTER_RIGHT+x,POS_WATER_Y,POS_CENTER_RIGHT+x,POS_WATER_Y+31,LCD_MODE);
        }
        break;
      }
      case MODE_FT8:
      {
        for (uint32_t x=0;x<DGL_WIDTH;x++)
        {
          lcd.drawLine(POS_CENTER_RIGHT+x,POS_WATER_Y,POS_CENTER_RIGHT+x,POS_WATER_Y+31,LCD_MODE);
        }
        break;
      }
      case MODE_AM:
      {
        for (uint32_t x=0;x<AM_WIDTH;x++)
        {
          lcd.drawLine(POS_CENTER_RIGHT+x-(AM_WIDTH/2),POS_WATER_Y,POS_CENTER_RIGHT+x-(AM_WIDTH/2),POS_WATER_Y+31,LCD_MODE);
        }
        break;
      }
      case MODE_CWL:
      {
        for (uint32_t x=0;x<10;x++)
        {
          lcd.drawLine(POS_CENTER_LEFT-x,POS_WATER_Y,POS_CENTER_LEFT-x,POS_WATER_Y+31,LCD_MODE);
        }
        break;
      }
      case MODE_CWU:
      {
        for (uint32_t x=0;x<10;x++)
        {
          lcd.drawLine(POS_CENTER_RIGHT+x,POS_WATER_Y,POS_CENTER_RIGHT+x,POS_WATER_Y+31,LCD_MODE);
        }
        break;
      }
    }
  }

  // greatest of 4 adjacent magnitudes
  for (uint32_t x=0;x<LCD_WIDTH;x++)
  {
    // x=0 => x*4+33 = 0*4+33 = 33
    // x=0 => x*4+34 = 0*4+34 = 34
    // x=0 => x*4+35 = 0*4+35 = 35
    // x=0 => x*4+36 = 0*4+36 = 36
    // x=1 => x*4+33 = 1*4+33 = 37
    // x=1 => x*4+34 = 1*4+34 = 38
    // x=1 => x*4+35 = 1*4+35 = 39
    // x=1 => x*4+36 = 1*4+36 = 40
    // ...
    // x=238 => x*4+33 = 238*4+33 = 985
    // x=238 => x*4+34 = 238*4+34 = 986
    // x=238 => x*4+35 = 238*4+35 = 987
    // x=238 => x*4+36 = 238*4+36 = 988
    // x=239 => x*4+33 = 239*4+33 = 989
    // x=239 => x*4+34 = 239*4+34 = 990
    // x=239 => x*4+35 = 239*4+35 = 991
    // x=239 => x*4+36 = 239*4+36 = 992
    uint8_t droplet = magnitude[x*4+33];
    droplet = max(droplet,magnitude[x*4+34]);
    droplet = max(droplet,magnitude[x*4+35]);
    droplet = max(droplet,magnitude[x*4+36]);
    if (droplet>31) droplet = 31;
    water[wp][x] = droplet;
  }

  // draw the spectrum
  if (radio.spectype==SPECTRUM_WIND)
  {
    for (uint32_t x=0;x<LCD_WIDTH-1;x++)
    {
      const int32_t v0 = water[wp][x];
      const int32_t v1 = water[wp][x+1];
      const int32_t x0 = x;
      const int32_t y0 = POS_WATER_Y+31-v0;
      const int32_t x1 = x+1;
      const int32_t y1 = POS_WATER_Y+31-v1;
      lcd.drawLine(x0,y0,x1,y1,LCD_WHITE);
    }
  }
  else
  {
    // SPECTRUM_GRASS
    lcd.fillRectVGradient(0,POS_WATER_Y,240,32,LCD_RED,LCD_YELLOW);
    for (uint32_t x=0;x<LCD_WIDTH;x++)
    {
      /*
      // single colour grass
      const int32_t x0 = x;
      const int32_t y0 = POS_WATER_Y+31;
      const int32_t x1 = x;
      const int32_t y1 = POS_WATER_Y+31-water[wp][x];
      lcd.drawLine(x0,y0,x1,y1,LCD_WHITE);
      */
      const int32_t x0 = x;
      const int32_t y0 = POS_WATER_Y;
      const int32_t x1 = x;
      const int32_t y1 = POS_WATER_Y+30-water[wp][x];
      lcd.drawLine(x0,y0,x1,y1,LCD_BLACK);
    }
  }

  // draw the waterfall
  int32_t r = wp;
  int32_t y = POS_WATER_Y+32;
  for (uint32_t i=0;i<WATERFALL_ROWS;i++,y++)
  {
    for (uint32_t x=0;x<LCD_WIDTH;x++)
    {
      const uint16_t c = spectrum::color_map_32[water[r][x]];
      lcd.drawPixel(x,y,c);
    }
    r--;
    if (r<0) r = WATERFALL_ROWS-1;
  }
  wp++;
  if (wp>=WATERFALL_ROWS) wp = 0;
}

enum menu_button_state_t {MENU_BUTTON_IDLE,MENU_BUTTON_PRESSED,MENU_WAIT_RELEASE_0,MENU_WAIT_RELEASE_1};
enum menu_button_action_t {MENU_NONE,MENU_TOP_SELECT,MENU_OPTION_SELECT};
static menu_button_state_t menu_button_state = MENU_BUTTON_IDLE;
static menu_button_action_t menu_button_action = MENU_NONE;
static uint8_t menu_window = 0;
static uint8_t menu_current = 0;
static uint8_t option_window = 0;
static uint8_t option_current = 0;

static void show_menu(void)
{
  if (!radio.menu_active)
  {
    return;
  }
  lcd.fillRect(POS_MENU_X,POS_MENU_Y,MENU_WIDTH,MENU_HEIGHT,LCD_BLACK);
  lcd.drawRect(POS_MENU_X,POS_MENU_Y,MENU_WIDTH,MENU_HEIGHT,LCD_WHITE),
  lcd.setTextSize(1);
  lcd.setFreeFont(&FreeSansBold9pt7b);
  if (menu_button_action==MENU_NONE) // MENU_MENU_SELECT
  {
    // display top level menu
    for (uint8_t i=menu_window,j=0;i<NUM_MENU_ITEMS && j<4;i++,j++)
    {
      char sz_menu_name[16] = "";
      memset(sz_menu_name,' ',sizeof(sz_menu_name));
      sz_menu_name[12] = '\0';
      for (int k=0;k<12;k++)
      {
        const char c = menu_options[i].menu_name[k];
        if (c=='\0') break;
        sz_menu_name[k] = c;
      }
      if (i==menu_current)
      {
        lcd.setTextColor(LCD_BLACK);
        lcd.fillRectHGradient(POS_MENU_X+2,POS_MENU_Y+20*j+1,MENU_WIDTH-4,20,LCD_YELLOW,LCD_PINK);
      }
      else
      {
        lcd.setTextColor(LCD_WHITE);
      }
      lcd.setCursor(POS_MENU_X+5,POS_MENU_Y+20*j+16);
      lcd.print(sz_menu_name);
    }
  }
  else if (menu_button_action==MENU_TOP_SELECT) // MENU_OPTION_SELECT
  {
    if (menu_current<NUM_MENU_ITEMS)
    {
      const uint8_t num_options = menu_options[menu_current].num_options;
      if (option_window<num_options && option_current<num_options)
      {
        lcd.setCursor(POS_MENU_X+5,POS_MENU_Y+16);
        lcd.print(menu_options[menu_current].menu_name);
        for (uint8_t i=option_window,j=1;i<num_options && j<4;i++,j++)
        {
          char sz_option_name[16] = "";
          memset(sz_option_name,' ',sizeof(sz_option_name));
          sz_option_name[10] = '\0';
          for (int k=1;k<10;k++)
          {
            const char c = menu_options[menu_current].options[i].option_name[k-1];
            if (c=='\0') break;
            sz_option_name[k] = c;
          }
          if (i==option_current)
          {
            lcd.setTextColor(LCD_BLACK);
            lcd.fillRectHGradient(POS_MENU_X+2,POS_MENU_Y+20*j,MENU_WIDTH-4,20,LCD_YELLOW,LCD_PINK);
          }
          else
          {
            lcd.setTextColor(LCD_WHITE);
          }
          lcd.setCursor(POS_MENU_X+10,POS_MENU_Y+20*j+16);
          lcd.print(sz_option_name);
        }
      }
    }
  }
  lcd.setTextFont(1);
}

static char sz_popup[64] = "";
static char sz_popup_heading[64] = "";
static uint32_t popup_timeout = 0;

static void set_popup(const char *sz_message,const char *sz_heading = NULL)
{
  if (sz_message)
  {
    memset(sz_popup,0,sizeof(sz_popup));
    memset(sz_popup_heading,0,sizeof(sz_popup_heading));
    strncpy(sz_popup,sz_message,sizeof(sz_popup)-1);
    if (sz_heading)
    {
      strncpy(sz_popup_heading,sz_heading,sizeof(sz_popup_heading)-1);
    }
    else
    {
      strcpy(sz_popup_heading,"ATTENTION:");
    }
    popup_timeout = millis() + POPUP_TIMEOUT;
  }
}

static void set_popup(volatile char *sz_message,const char *sz_heading = NULL)
{
  set_popup((const char*)sz_message,sz_heading);
}

static void show_popup(void)
{
  if (sz_popup[0] == '\0') return;
  if (millis() > popup_timeout)
  {
    sz_popup[0] = '\0';
    return;
  }
  // Filled box centred on screen
  lcd.fillRect(10, 48, 220, 40, LCD_DARKRED);
  lcd.drawRect(10, 48, 220, 40, LCD_WHITE);
  lcd.setTextFont(1);
  lcd.setTextSize(1);
  lcd.setTextColor(LCD_YELLOW, LCD_DARKRED);
  lcd.setCursor(16, 52);
  lcd.print(sz_popup_heading);
  lcd.setTextSize(2);
  lcd.setTextColor(LCD_WHITE, LCD_DARKRED);
  lcd.setCursor(16, 64);
  lcd.print(sz_popup);
  lcd.setTextFont(1);
  lcd.setTextSize(1);
}

static void update_display(const uint32_t signal_level = 0u)
{
  display_clear();
  show_rx_tx();
  show_mode();
  show_band();
  show_notch();
  show_cpu_usage();
  show_frequency();
  show_tuning_step();
  show_swr();
  show_meter_dial(signal_level);
  show_cw_settings();
  show_cessb_settings();
  show_attenuator();  
  show_jnr();
  show_spectrum();
  show_overflow();
  show_cw_decode();
  show_menu();
  show_popup();
  show_debug_value(debug_value_1,debug_value_2);
  display_refresh();
}

static void init_menu(void)
{
  menu_window = 0;
  menu_current = 0;
  option_window = 0;
  option_current = 0;
  menu_button_state = MENU_WAIT_RELEASE_0;
  menu_button_action = MENU_NONE;
}

static const option_value_t process_menu(void)
{
  static uint32_t menu_timeout = millis()+MENU_TIMEOUT;
  option_value_t option = OPTION_NONE;
  switch (menu_button_state)
  {
    case MENU_WAIT_RELEASE_0:
    {
      if (digitalRead(PIN_ENCBUT)==HIGH)
      {
        menu_button_state = MENU_BUTTON_IDLE;
        delay(50);
      }
      menu_timeout = millis()+MENU_TIMEOUT;
      break;
    }
    case MENU_BUTTON_IDLE:
    {
      // has the button been pressed?
      if (digitalRead(PIN_ENCBUT)==LOW)
      {
        menu_button_state = MENU_WAIT_RELEASE_1;
        menu_timeout = millis()+MENU_TIMEOUT;
        delay(50);
      }
      break;
    }
    case MENU_WAIT_RELEASE_1:
    {
      if (digitalRead(PIN_ENCBUT)==HIGH)
      {
        menu_button_state = MENU_BUTTON_IDLE;
        switch (menu_button_action)
        {
          case MENU_NONE:          menu_button_action = MENU_TOP_SELECT;    break;
          case MENU_TOP_SELECT:    menu_button_action = MENU_OPTION_SELECT; break;
          case MENU_OPTION_SELECT: menu_button_action = MENU_NONE;          break;
        }
        delay(50);
      }
      menu_timeout = millis()+MENU_TIMEOUT;
      break;
    }
  }
  // process the button action
  switch (menu_button_action)
  {
    case MENU_NONE:
    {
      mutex_enter_blocking(&rotary_mutex);
      const int32_t rotary_delta = radio.tune;
      radio.tune = 0;
      mutex_exit(&rotary_mutex);
      if (rotary_delta>0)
      {
        menu_timeout = millis()+MENU_TIMEOUT;
        if (menu_current<NUM_MENU_ITEMS-1)
        {
          menu_current++;
          if (menu_current>menu_window+3)
          {
            if (menu_window<NUM_MENU_ITEMS-1)
            {
              menu_window++;
            }
          }
        }
      }
      else if (rotary_delta<0)
      {
        menu_timeout = millis()+MENU_TIMEOUT;
        if (menu_current>0)
        {
          menu_current--;
          if (menu_current<menu_window)
          {
            if (menu_window>0)
            {
              menu_window--;
            }          
          }
        }
      }
      break;
    }
    case MENU_TOP_SELECT:
    {
      if (menu_options[menu_current].menu_value==MENU_EXIT)
      {
        return OPTION_EXIT;
      }
      // process menu options
      const uint8_t num_options = menu_options[menu_current].num_options;
      mutex_enter_blocking(&rotary_mutex);
      const int32_t rotary_delta = radio.tune;
      radio.tune = 0;
      mutex_exit(&rotary_mutex);
      if (rotary_delta>0)
      {
        menu_timeout = millis()+MENU_TIMEOUT;
        if (option_current<num_options-1)
        {
          option_current++;
          if (option_current>option_window+2)
          {
            if (option_window<num_options-1)
            {
              option_window++;
            }
          }
        }
      }
      else if (rotary_delta<0)
      {
        menu_timeout = millis()+MENU_TIMEOUT;
        if (option_current>0)
        {
          option_current--;
          if (option_current<option_window)
          {
            if (option_window>0)
            {
              option_window--;
            }          
          }
        }
      }
      break;
    }
    case MENU_OPTION_SELECT:
    {
      option = menu_options[menu_current].options[option_current].option_value;
      radio.menu_active = false;
      break;
    }
  }
  if (millis()>menu_timeout)
  {
    radio.menu_active = false;
  }
  return option;
}

void __not_in_flash_func(loop1)(void)
{
  // run DSP on core 1
  static bool tx = false;
  static uint32_t tx_peak_delay = 0;
  static float tx_level = 100.0f;
  volatile static uint32_t tx_word = 0;
  volatile static int16_t adc_value = 0;
  volatile static int32_t dac_h = 0;
  volatile static int32_t dac_l = 0;
  if (tx)
  {
    // TX, check if changed to RX
    if (radio.tx_enable)
    {
      // wait for FPGA ready for data
      if (digitalRead(PIN_DR)==LOW)
      {
        return;
      }
      volatile const uint32_t cpu_start = time_us_32();
      adc_value = get_adc();
      adc_start_conversion();
      pwm_set_both_levels(audio_pwm,dac_l,dac_h);
      iqSPI.doTransfer(tx_word);
      if ((radio.mode==MODE_DGL||radio.mode==MODE_DGU) && vox_mic_ready && abs(adc_value)>VOX_LEVEL)
      {
        vox_triggered = true;
      }
      int16_t tx_i = 0;
      int16_t tx_q = 0;
      switch (radio.mode)
      {
        case MODE_LSB: DSP::process_mic(adc_value,tx_q,tx_i,mic_gain,radio.micproc,radio.cessb); break;
        case MODE_USB: DSP::process_mic(adc_value,tx_i,tx_q,mic_gain,radio.micproc,radio.cessb); break;
        case MODE_DGL: DSP::process_dig(adc_value,tx_q,tx_i);                                    break;
        case MODE_DGU: DSP::process_dig(adc_value,tx_i,tx_q);                                    break;
        case MODE_CWL: CW::process_cw(radio.keydown,tx_i,tx_q);                                  break;
        case MODE_CWU: CW::process_cw(radio.keydown,tx_i,tx_q);                                  break;
        case MODE_FT8: tx_i = tx_q = FT8_TX_MAX;                                                 break;
      }
      tx_i = (int16_t)((float)tx_i * tx_level / 100.0f);
      tx_q = (int16_t)((float)tx_q * tx_level / 100.0f);
      tx_i = constrain(tx_i,-512,+511);
      tx_q = constrain(tx_q,-512,+511);
      tx_word = ((uint32_t)(uint16_t)tx_q << 16) | (uint16_t)tx_i;
      adc_data_i[adc_sample_p] = tx_i<<5;
      adc_data_q[adc_sample_p] = tx_q<<5;
      adc_sample_p = (adc_sample_p+1) & (MAX_ADC_SAMPLES-1);
      if (radio.mode==MODE_LSB || radio.mode==MODE_USB ||
        radio.mode==MODE_DGL || radio.mode==MODE_DGU)
      {
        if (millis()>tx_peak_delay)
        {
          mic_peak_level = DSP::get_mic_peak_level(adc_value);
        }
        else
        {
          mic_peak_level = 0;
        }
      }
      else if (radio.mode==MODE_CWL || radio.mode==MODE_CWU)
      {
        // generate the sidetone
        int32_t dac_audio = CW::sidetone(radio.keydown);
        dac_audio = constrain(dac_audio,-2048l,+2047l);
        dac_audio += 2048l;
        dac_h = dac_audio >> 6;
        dac_l = dac_audio & 0x3f;
      }
      if (radio.mode!=MODE_FT8)
      {
        // only change TX level in TX mode
        static int32_t rotary = 0l;
        switch (r.process())
        {
          case DIR_CW:  rotary++; break;
          case DIR_CCW: rotary--; break;
        }
        if (rotary!=0)
        {
          // don't hang around if we can't own the mutex immediately
          // rotary will record any rotations
          if (mutex_try_enter(&rotary_mutex,0ul))
          {
            tx_level += (float)rotary;
            rotary = 0;
            mutex_exit(&rotary_mutex);
            tx_level = constrain(tx_level,0.0f,100.0f);
          }
        }
      }
      volatile const uint32_t cpu_end = time_us_32();
      cpu.usage += (cpu_end-cpu_start);
      cpu.count++;
      while (digitalRead(PIN_DR)==HIGH)
      {
        // make sure data ready is LOW before returning
        tight_loop_contents();
      }
    }
    else
    {
      // switched to RX
      if (radio.mode==MODE_DGL || radio.mode==MODE_DGU)
      {
        enable_mic();
      }
      else
      {
        disable_mic();
      }
      // set TX output to zero in receive mode
      tx = false;
    }
  }
  else
  {
    // RX, check if changed to TX
    if (radio.tx_enable)
    {
      // switch to TX
      enable_mic();
      mic_gain = (float)radio.micgain / 100.0f;
      tx_peak_delay = millis() + 100u;
      tx = true;
    }
    else
    {
      // wait for sample from FPGA
      if (digitalRead(PIN_DR)==LOW)
      {
        return;
      }
      volatile const uint32_t cpu_start = time_us_32();
      adc_value = get_adc();
      adc_start_conversion();
      pwm_set_both_levels(audio_pwm,dac_l,dac_h);
      const uint32_t rx_sample = iqSPI.doTransfer(0);
      if ((radio.mode==MODE_DGL||radio.mode==MODE_DGU) && vox_mic_ready && abs(adc_value)>VOX_LEVEL)
      {
        vox_triggered = true;
      }
      const int16_t ii = (int16_t)(rx_sample>>16);
      const int16_t qq = (int16_t)(rx_sample & 0xffff);
      static constexpr uint32_t WARNING_THRESHOLD = 16000;
      static constexpr uint32_t OVERFLOW_THRESHOLD = 32000;
      const uint32_t pk_i = (uint32_t)abs(ii);
      const uint32_t pk_q = (uint32_t)abs(qq);
      const uint32_t pk = (pk_i > pk_q) ? pk_i : pk_q;
      if (pk > OVERFLOW_THRESHOLD)
      {
        overflow = 2;
      }
      else if (pk > WARNING_THRESHOLD && overflow < 2)
      {
        overflow = 1;
      }
#ifdef DEBUG_DDC_SAMPLE
      static uint32_t debug_count = 0;
      static uint32_t debug_abs_1 = 0;
      static uint32_t debug_abs_2 = 0;
      if (abs(ii) > debug_abs_1) debug_abs_1 = abs(ii);
      if (abs(qq) > debug_abs_2) debug_abs_2 = abs(qq);
      if (debug_count >= 15000)
      {
        debug_value_1 = debug_abs_1;
        debug_value_2 = debug_abs_2;
        debug_abs_1 = 0;
        debug_abs_2 = 0;
        debug_count = 0;
      }
      debug_count++;
#endif
#ifdef DEBUG_AGC_SAMPLE
      static uint32_t debug_count = 0;
      static uint32_t debug_abs_1 = 0;
      static uint32_t debug_abs_2 = 0;
      const int32_t agc = DSP::get_agc();
      if (abs(ii) > debug_abs_1) debug_abs_1 = abs(ii);
      if (abs(agc) > debug_abs_2) debug_abs_2 = abs(agc);
      if (debug_count >= 15000)
      {
        debug_value_1 = debug_abs_1;
        debug_value_2 = debug_abs_2;
        debug_abs_1 = 0;
        debug_abs_2 = 0;
        debug_count = 0;
      }
      debug_count++;
#endif
      adc_data_i[adc_sample_p] = ii;
      adc_data_q[adc_sample_p] = qq;
      adc_sample_p = (adc_sample_p+1) & (MAX_ADC_SAMPLES-1);
      int32_t dac_audio = 0;
      float ft8_audio = 0.0f;
      float cwsig = 0.0f;
      const uint8_t jnr = radio.jnrlevel;
      const uint8_t nb = radio.nblevel;
      const uint8_t bw = radio.bandwidth - 1;
      switch (radio.mode)
      {
        case MODE_LSB: dac_audio = DSP::process_ssb(qq,ii,jnr,bw,nb); break;
        case MODE_USB: dac_audio = DSP::process_ssb(ii,qq,jnr,bw,nb); break;
        case MODE_AM:  dac_audio = DSP::process_am(ii,qq,jnr);        break;
        case MODE_CWL: dac_audio = DSP::process_cw(qq,ii,cwsig);      break;
        case MODE_CWU: dac_audio = DSP::process_cw(ii,qq,cwsig);      break;
        case MODE_DGL: dac_audio = DSP::process_dig(qq,ii);           break;
        case MODE_DGU: dac_audio = DSP::process_dig(ii,qq);           break;
        case MODE_FT8: ft8_audio = DSP::process_ft8(ii,qq);           break;
      }
      if (radio.mode==MODE_FT8)
      {
        dac_audio = 2048l;
        volatile static struct {uint32_t c : 2; } downsample = { 0 };
        if (downsample.c == 0)
        {
          // note, ft8_data is two buffers of FT8_FFT_SIZE/2 values
          ft8_data[ft8_sample_p] = ft8_audio;
          ft8_sample_p = (ft8_sample_p + 1) % FT8_FFT_SIZE;
        }
        downsample.c++;
      }
      else
      {
        dac_audio = constrain(dac_audio,-2048l,+2047l);
        dac_audio += 2048l;
      }
      dac_h = dac_audio >> 6;
      dac_l = dac_audio & 0x3f;
      if (radio.cwdecode != 0)
      {
        if (radio.mode==MODE_CWL || radio.mode==MODE_CWU)
        {
          static bool last_key_down = false;
          const uint8_t raw = radio.cwdecode==1?
            CWDECODE1::morse_decode(cwsig):
            CWDECODE2::morse_decode(cwsig);
          const bool cw_key_down = raw&0x80?true:false;
          const char raw_char = raw & 0x7f;
          if (cw_key_down != last_key_down || raw_char!='\0')
          {
            last_key_down = cw_key_down;
            mutex_enter_blocking(&cw_decode_mutex);
            cw_decode_buf[20] = '\0';
            cw_decode_buf[19] = cw_key_down?'*':' ';
            if (raw_char!='\0')
            {
              for (uint8_t i=0;i<18;i++)
              {
                const char c = cw_decode_buf[i+1];
                cw_decode_buf[i] = (c=='\0'?' ':c);
              }
              cw_decode_buf[18] = raw_char;
            }
            mutex_exit(&cw_decode_mutex);
          }
        }
        else
        {
          CWDECODE1::md1_initialised = 0;
          CWDECODE2::md2_initialised = 0;
          memset((char*)cw_decode_buf,0,sizeof(cw_decode_buf));
        }
      }
      else
      {
        CWDECODE1::md1_initialised = 0;
        CWDECODE2::md2_initialised = 0;
        memset((char*)cw_decode_buf,0,sizeof(cw_decode_buf));
      }
      // only process tune in receive mode
      static int32_t rotary = 0l;
      switch (r.process())
      {
        case DIR_CW:  rotary++; break;
        case DIR_CCW: rotary--; break;
      }
      if (rotary!=0)
      {
        // don't hang around if we can't own the mutex immediately
        // rotary will record any rotations
        if (mutex_try_enter(&rotary_mutex,0ul))
        {
          radio.tune += rotary;
          rotary = 0;
          mutex_exit(&rotary_mutex);
        }
      }
      volatile const uint32_t cpu_end = time_us_32();
      cpu.usage += (cpu_end-cpu_start);
      cpu.count++;
      while (digitalRead(PIN_DR)==HIGH)
      {
        // make sure data ready is LOW before returning
        tight_loop_contents();
      }
    }
  }
}

static void process_spectrum(void)
{
  uint32_t offset = 0;
  const uint32_t sample_p = adc_sample_p;
  if (sample_p<800)
  {
    // first half is in use, get the second half
    offset = SPECTRUM_BUFFER;
  }
  else if (sample_p>1023 && sample_p<1800)
  {
    // second half is in use, get the first half
    offset = 0;
  }
  else
  {
    return;
  }
  static constexpr int8_t fcomp = 4;
  static int16_t data_re[SPECTRUM_BUFFER] = {0};
  static int16_t data_im[SPECTRUM_BUFFER] = {0};
  const int8_t ga = (radio.mode==MODE_DGL || radio.mode==MODE_DGU)?-3:0;
  const int8_t gain = radio.tx_enable?ga:radio.level[radio.band]+fcomp;
  for (uint32_t i=0;i<SPECTRUM_BUFFER;i++)
  {
    data_re[i] = adc_data_i[i+offset];
    data_im[i] = adc_data_q[i+offset];
  }
  spectrum::process(data_re,data_im,magnitude,gain);
}

static void enable_ssb_tx(void)
{
  // 1. mute the receiver
  // 2. set TX/RX relay to TX
  // 3. enable MIC (DSP)
  // 4. enable TX bias

  // indicate PTT pressed
  digitalWrite(LED_BUILTIN,HIGH);

  // mute the receiver
  mute();
  delay(10);

  // enable MIC processing
  radio.tx_enable = true;
  set_frequency();
  update_display();
  digitalWrite(PIN_TXEN, HIGH);
  delay(50);
}

static void ptt_release(void)
{
  // wait for PTT release
  uint32_t tx_display_update = 0;
  while (digitalRead(PIN_PTT)==LOW)
  {
    // spectrum data is mic input
    process_spectrum();

    // update display
    const uint32_t now = millis();
    if (now>tx_display_update)
    {
      update_display(mic_peak_level);
      tx_display_update = now + 50ul;
    }
  }
}

static void process_vox_tx(void)
{
  // wait for PTT release
  uint32_t tx_display_update = 0;

  // spectrum data is mic input
  process_spectrum();

  // update display
  const uint32_t now = millis();
  if (now>tx_display_update)
  {
    update_display(mic_peak_level);
    tx_display_update = now + 50ul;
  }
}

static void cw_dit_delay(const uint32_t ms,const uint32_t level)
{
  const uint32_t delay_time = millis()+ms;
  update_display(level);
  while (delay_time>millis())
  {
    // check for dah
    if (digitalRead(PIN_PADB)==LOW)
    {
      dah_latched = true;
    }
  }
}

static void cw_dah_delay(const uint32_t ms,const uint32_t level)
{
  const uint32_t delay_time = millis()+ms;
  update_display(level);
  while (delay_time>millis())
  {
    // check for dit
    if (digitalRead(PIN_PADA)==LOW)
    {
      dit_latched = true;
    }
  }
}

static void process_key(void)
{
  static const uint8_t spectrum_display_level = 16u;

  // enable QSE and TX bias
  digitalWrite(PIN_TXEN, HIGH);
  delay(10);

  // enable TX processing
  radio.keydown = false;
  radio.tx_enable = true;
  set_frequency();
  delay(10);

  // clear spectrum
  memset(magnitude,0,sizeof(magnitude));

  // stay here until timeout after key up (PTT released)
  uint32_t cw_timeout = millis() + CW_TIMEOUT;
  for (;;)
  {
    if (digitalRead(PIN_PTT)==LOW)
    {
      // indicate PTT pressed
      digitalWrite(LED_BUILTIN,HIGH);
      radio.keydown = true;
      magnitude[512] = spectrum_display_level;
      update_display(15u);
      while (digitalRead(PIN_PTT)==LOW)
      {
        update_display(15u);
      }
      // indicate PTT released
      digitalWrite(LED_BUILTIN,LOW);
      radio.keydown = false;
      magnitude[512] = 0u;
      update_display(0u);
      cw_timeout = millis() + CW_TIMEOUT;
    }
    if (digitalRead(PIN_PADA)==LOW || dit_latched)
    {
      // dit
      dit_latched = false;
      cw_dit_delay(radio.cw_dit,0u);
      radio.keydown = true;
      magnitude[512] = spectrum_display_level;
      digitalWrite(LED_BUILTIN,HIGH);
      cw_dit_delay(radio.cw_dit,15u);
      radio.keydown = false;
      magnitude[512] = 0u;
      digitalWrite(LED_BUILTIN,LOW);
      cw_timeout = millis() + CW_TIMEOUT;
    }
    if (digitalRead(PIN_PADB)==LOW || dah_latched)
    {
      // dah
      dah_latched = false;
      cw_dah_delay(radio.cw_dit,0u);
      radio.keydown = true;
      magnitude[512] = spectrum_display_level;
      digitalWrite(LED_BUILTIN,HIGH);
      cw_dah_delay(radio.cw_dit * 3, 15u);
      radio.keydown = false;
      magnitude[512] = 0u;
      digitalWrite(LED_BUILTIN,LOW);
      cw_timeout = millis() + CW_TIMEOUT;
    }
    if (millis()>cw_timeout)
    {
      break;
    }
  }

  // mute during transition back to receive
  mute();
}

static const radio_mode_t get_mode_auto(void)
{
  if (!radio.mode_auto)
  {
    return radio.mode;
  }
  if (radio.band==BAND_SWL)
  {
    return MODE_AM;
  }
  if (radio.frequency<10000000ul)
  {
    if (radio.frequency==7074000ul)
    {
      return MODE_USB;
    }
    if (radio.frequency==3573000ul)
    {
      return MODE_USB;
    }
    if (radio.frequency<7060000ul && radio.frequency>=7000000ul)
    {
      return MODE_CWL;
    }
    return MODE_LSB;
  }
  else if (radio.frequency<14060000ul && radio.frequency>=14000000ul)
  {
    return MODE_CWU;
  }
  return MODE_USB;
}

/*
 * FT8 processing
 */

//------------------------------------------------------------------------------
// FT8 STATIC DATA
//------------------------------------------------------------------------------
static monitor_t ft8mon = { 0 };

// Rolling history ring buffer - accumulates across slots, never cleared
static ft8_history_entry_t ft8_history[FT8_HISTORY_SIZE] = { 0 };
static uint32_t ft8_history_count = 0;
static uint32_t ft8_history_head = 0;

// Frozen display snapshot - taken when user first touches the rotary
static ft8_history_entry_t ft8_display_buf[FT8_HISTORY_SIZE] = { 0 };
static uint32_t ft8_display_count = 0;
static uint32_t ft8_cal_freeze = 0;

// UI state
static bool ft8_new_available = false; // new decodes since last freeze
static ft8_ui_state_t ft8_ui_state = FT8_UI_AUTO;
static int32_t ft8_cursor = 0; // selected line in browse mode
static uint32_t ft8_last_interaction = 0; // millis() of last rotary/button

// Selected message for TX
static ft8_selected_t ft8_selected = { 0 };

// show QSO after completion
static ft8_qso_t ft8_qso = { 0 };
static uint32_t ft8_qso_display_until = 0;
static uint32_t ft8_exit_pending_until = 0;

// CQ state
static ft8_cq_t ft8_cq = { 0 };

// record button during decode callback
static ft8_btn_t ft8_button_deferred = FT8_BTN_IDLE;
static uint32_t ft8_button_down_time = 0;

// auto calibrate
static uint32_t ft8_cal_try = 0;

//------------------------------------------------------------------------------
// DISPLAY FUNCTIONS
//------------------------------------------------------------------------------
static char ft8_sz_popup[64] = "";
static char ft8_sz_heading[64] = "";
static uint32_t ft8_popup_timeout = 0;

static void ft8_set_popup(const char *sz_message,const char *sz_heading = NULL)
{
  if (sz_message)
  {
    memset(ft8_sz_popup,0,sizeof(ft8_sz_popup));
    memset(ft8_sz_heading,0,sizeof(ft8_sz_heading));
    strncpy(ft8_sz_popup,sz_message,sizeof(ft8_sz_popup)-1);
    if (sz_heading)
    {
      strncpy(ft8_sz_heading,sz_heading,sizeof(ft8_sz_heading)-1);
    }
    ft8_popup_timeout = millis() + FT8_POPUP_TIME;
  }
}

static void ft8_show_popup(void)
{
  if (ft8_sz_popup[0] == '\0') return;
  if (millis() > ft8_popup_timeout)
  {
    ft8_sz_popup[0] = '\0';
    return;
  }

  // Filled box centred on screen
  lcd.fillRect(10, 48, 220, 40, LCD_BLUE);
  lcd.drawRect(10, 48, 220, 40, LCD_WHITE);

  lcd.setTextFont(1);
  lcd.setTextSize(1);
  lcd.setTextColor(LCD_YELLOW, LCD_BLUE);
  lcd.setCursor(16, 52);
  lcd.print(ft8_sz_heading[0]=='\0'?"QSO MESSAGE:":ft8_sz_heading);

  lcd.setTextSize(2);
  lcd.setTextColor(LCD_WHITE, LCD_BLUE);
  lcd.setCursor(16, 64);
  lcd.print(ft8_sz_popup);

  lcd.setTextFont(1);
  lcd.setTextSize(1);
}

static void ft8_show_frequency(void)
{
  const uint16_t tx_rx = radio.tx_enable?LCD_RED:LCD_WHITE;
  const uint16_t fcolour = radio.tx_safe?tx_rx:LCD_YELLOW;
  char sz_frequency[16] = "";
  memset(sz_frequency,0,sizeof(sz_frequency));
  ultoa(radio.frequency,sz_frequency,10);
  if (radio.frequency<1000000u)
  {
    // 6 digits
    //            012 345
    // 936000 ->  936.000
    // 012345    01234567
    sz_frequency[7] = sz_frequency[5];
    sz_frequency[6] = sz_frequency[4];
    sz_frequency[5] = sz_frequency[3];
    sz_frequency[4] = '.';
    sz_frequency[3] = sz_frequency[2];
    sz_frequency[2] = sz_frequency[1];
    sz_frequency[1] = sz_frequency[0];
    sz_frequency[0] = ' ';
  }
  else if (radio.frequency<10000000u)
  {
    // 7 digits
    // 3555000 -> 3.555.000
    // 0123456    012345678
    sz_frequency[9] = sz_frequency[6];
    sz_frequency[8] = sz_frequency[5];
    sz_frequency[7] = sz_frequency[4];
    sz_frequency[6] = '.';
    sz_frequency[5] = sz_frequency[3];
    sz_frequency[4] = sz_frequency[2];
    sz_frequency[3] = sz_frequency[1];
    sz_frequency[2] = '.';
    sz_frequency[1] = sz_frequency[0];
    sz_frequency[0] = ' ';
  }
  else
  {
    // 8 digits
    // 14222000 -> 14.222.000
    // 01234567    0123456789
    sz_frequency[9] = sz_frequency[7];
    sz_frequency[8] = sz_frequency[6];
    sz_frequency[7] = sz_frequency[5];
    sz_frequency[6] = '.';
    sz_frequency[5] = sz_frequency[4];
    sz_frequency[4] = sz_frequency[3];
    sz_frequency[3] = sz_frequency[2];
    sz_frequency[2] = '.';
  }
  lcd.setFreeFont(&Arial_Bold14pt7b);
  lcd.setTextSize(1);
  lcd.setTextColor(fcolour,LCD_BLACK);
  lcd.setCursor(FT8_FREQUENCY_X,FT8_FREQUENCY_Y);
  lcd.print(sz_frequency);
  lcd.setTextFont(1);
  lcd.setTextSize(1);
}

static void ft8_show_pulse(void)
{
  if (millis() % 1000 < 500)
  {
    const bool poached = ft8_qso.poached && ft8_qso.active;
    lcd.setFreeFont(&Arial_Bold14pt7b);
    lcd.setTextSize(1);
    lcd.setTextColor(poached?LCD_RED:LCD_BLUE,LCD_BLACK);
    lcd.setCursor(FT8_PULSE_X,FT8_PULSE_Y);
    lcd.print("*");
  }
  lcd.setTextFont(1);
  lcd.setTextSize(1);
}

static void ft8_show_progress(const uint32_t progress)
{
  if (progress == 0) return;
  const uint32_t bar = ((progress>240)?240:progress) - 1;
  lcd.drawLine(0,132,bar,132,radio.tx_enable?LCD_RED:LCD_GREEN);
  lcd.drawLine(0,133,bar,133,radio.tx_enable?LCD_RED:LCD_GREEN);
  lcd.drawLine(0,134,bar,134,radio.tx_enable?LCD_RED:LCD_GREEN);
}

static void ft8_show_agc(void)
{
  // Show RX audio level as a bar across the top. agc_peak is an amplitude
  // (audio_out * 32768.0f) so it spans roughly 0..32768 - the bar has to be
  // logarithmic or everything below a very strong signal sits in the first
  // two pixels. 0 dB (peak 1.0) to 90 dB (peak 32768) across the full width,
  // but the scale bends at S9 (peak ~200, 46 dB) so S9 lands at 80% of the
  // bar - below S9 gets most of the resolution, S9+ reports compress into
  // the remaining 20%, like a conventional S-meter.
  static constexpr float DB_FULL_SCALE = 90.0f;
  static constexpr float DB_S9 = 20.0f * log10f(200.0f); // 46.0206f = 20*log10(200)
  static constexpr float BAR_WIDTH = 239.0f;
  static constexpr float BAR_AT_S9 = BAR_WIDTH * 0.8f;

  const float peak = DSP::agc_peak;

  // dark track, so "no signal" reads as an empty bar rather than a missing one
  lcd.drawLine(0,FT8_AGC_Y+0,239,FT8_AGC_Y+0,LCD_DARKGREY);
  lcd.drawLine(0,FT8_AGC_Y+1,239,FT8_AGC_Y+1,LCD_DARKGREY);
  lcd.drawLine(0,FT8_AGC_Y+2,239,FT8_AGC_Y+2,LCD_DARKGREY);
  if (peak <= 1.0f) return;

  const float db = 20.0f * log10f(peak);
  float barf = 0.0f;
  if (db <= DB_S9)
  {
    barf = db * (BAR_AT_S9 / DB_S9);
  }
  else
  {
    barf = BAR_AT_S9 + (db - DB_S9) * ((BAR_WIDTH - BAR_AT_S9) / (DB_FULL_SCALE - DB_S9));
  }
  int32_t bar = (int32_t)barf;
  if (bar < 0) bar = 0;
  if (bar > 239) bar = 239;

  lcd.drawLine(0,FT8_AGC_Y+0,bar,FT8_AGC_Y+0,LCD_YELLOW);
  lcd.drawLine(0,FT8_AGC_Y+1,bar,FT8_AGC_Y+1,LCD_YELLOW);
  lcd.drawLine(0,FT8_AGC_Y+2,bar,FT8_AGC_Y+2,LCD_YELLOW);
}

// Show slot parity indicator and TX/RX status top-right
static void ft8_show_slot_status(const uint32_t slot_calibrate_ms,const ft8_state_t ft8_state)
{
  const uint32_t slot_number = (millis() - slot_calibrate_ms) / FT8_SLOT_MS;
  const bool even = (slot_number % 2) == 0;

  lcd.setTextFont(1);
  lcd.setTextSize(1);
  lcd.setCursor(FT8_STATUS_X, FT8_STATUS_Y);

  if (ft8_state == FT8_STATE_TRANSMITTING)
  {
    lcd.setTextColor(LCD_RED, LCD_BLACK);
    lcd.print("TX");
  }
  else
  {
    lcd.setTextColor(LCD_GREEN, LCD_BLACK);
    lcd.print("RX");
  }

  // show slot parity
  lcd.setTextColor(LCD_CYAN, LCD_BLACK);
  lcd.print(even ? " E" : " O");

  // flash CQ so it's obvious
  if (ft8_cq.active)
  {
    if (millis() % 1000 < 500) 
    {
      lcd.setCursor(FT8_CQ_X, FT8_CQ_Y);
      lcd.setTextColor(LCD_BLACK, LCD_YELLOW);
      lcd.print("CQ");
    }
  }
}

// Show browse/select position indicator "047/200"
static void ft8_show_position(void)
{
  lcd.setTextFont(1);
  lcd.setTextSize(1);
  lcd.setTextColor(LCD_CYAN, LCD_BLACK);
  lcd.setCursor(FT8_POSITION_X, FT8_POSITION_Y);
  char pos[16];
  snprintf(pos, sizeof(pos), "%3d/%3d", (int)(ft8_cursor + 1), (int)ft8_display_count);
  lcd.print(pos);
}

static void ft8_show_tx_frequency(void)
{
  if (ft8_cq.active)
  {
    lcd.setTextFont(1);
    lcd.setTextSize(1);
    lcd.setTextColor(LCD_CYAN, LCD_BLACK);
    lcd.setCursor(FT8_TXAUDIO_X, FT8_TXAUDIO_Y);
    lcd.print((uint32_t)ft8_cq.audio_freq);
    return;
  }
  if (ft8_qso.active)
  {
    lcd.setTextFont(1);
    lcd.setTextSize(1);
    lcd.setTextColor(LCD_CYAN, LCD_BLACK);
    lcd.setCursor(FT8_TXAUDIO_X, FT8_TXAUDIO_Y);
    lcd.print((uint32_t)ft8_qso.audio_freq);
    return;
  }
}

// Show [NEW] flash when new decodes arrived since last freeze
static void ft8_show_new_indicator(void)
{
  if (!ft8_new_available) return;
  if (millis() % 1000 >= 500) return;
  lcd.setTextFont(1);
  lcd.setTextSize(1);
  lcd.setCursor(FT8_NEW_X,FT8_NEW_Y);
  lcd.setTextColor(LCD_YELLOW, LCD_BLACK);
  lcd.print("NEW");
}

// Main decoded message display
// AUTO mode: live history, newest 12 entries, no cursor
// BROWSE/SELECTED: frozen snapshot, scrollable, cursor highlighted
static void ft8_show_decoded(const uint32_t slot_calibrate_ms)
{
  lcd.setTextFont(1);
  lcd.setTextSize(1);

  if (ft8_ui_state == FT8_UI_AUTO)
  {

    // Live view - show newest FT8_DISPLAY_LINES entries from history
    const int32_t total  = (int32_t)min(ft8_history_count, (uint32_t)FT8_HISTORY_SIZE);
    if (total == 0)
    {
      lcd.setCursor(0, 40);
      lcd.setTextColor(LCD_WHITE, LCD_BLACK);
      lcd.print("Waiting for FT8 signals...");
      return;
    }
    const int32_t lines_show = (total < (int32_t)FT8_DISPLAY_LINES) ? total : (int32_t)FT8_DISPLAY_LINES;
    const int32_t from = total - lines_show;   // always >= 0, no underflow possible
    lcd.setCursor(0, 30);
    for (int32_t i = from; i < total; i++)
    {
      const ft8_history_entry_t* e = ft8_history_get(i);
      lcd.setTextColor(LCD_WHITE, LCD_BLACK);
      char buf[FT8_DISPLAY_COLS + 1];
      strncpy(buf, e->text, FT8_DISPLAY_COLS);
      buf[FT8_DISPLAY_COLS] = '\0';
      if (strstr(buf,(const char*)radio.callsign) !=NULL)
      {
        lcd.setTextColor(LCD_WHITE, LCD_RED);
      }
      else if (strstr(buf,"CQ ") !=NULL)
      {
        lcd.setTextColor(LCD_WHITE, LCD_BLUE);
      }
      lcd.println(buf);
    }
  }
  else
  {
    // Browse/selected mode - frozen snapshot with scrolling cursor
    // Keep cursor visible: window follows cursor
    const int32_t total = (int32_t)ft8_display_count;
    int32_t from = ft8_cursor - FT8_DISPLAY_LINES + 3; // cursor near bottom
    if (from < 0) from = 0;
    if (from > total - FT8_DISPLAY_LINES) from = max(0, total - FT8_DISPLAY_LINES);

    // Age warning threshold - entries older than this many slots
    const uint8_t current_slot_low = (uint8_t)((millis() - slot_calibrate_ms) / FT8_SLOT_MS);

    lcd.setCursor(0, 30);
    for (int32_t i = from; i < from + FT8_DISPLAY_LINES && i < total; i++)
    {
      const ft8_history_entry_t* e = &ft8_display_buf[i];
      const bool is_cursor   = (i == ft8_cursor);
      const bool is_selected = (ft8_ui_state == FT8_UI_SELECTED) && is_cursor;

      // Message text (truncated)
      char buf[FT8_DISPLAY_COLS - 1];
      memset(buf,0,sizeof(buf));
      strncpy(buf, e->text, sizeof(buf) - 1);
      buf[sizeof(buf) - 1] = '\0';

      // Age check: warn if entry is more than 4 slots old
      const uint8_t age = current_slot_low - e->slot_number_low;
      const bool is_old = (age > 4);
      const bool is_cq = strstr(buf,"CQ ") != NULL;
      const bool is_mycall = strstr(buf,(const char*)radio.callsign) != NULL;

      // Slot parity indicator prefix (1 char)
      if (is_selected) lcd.setTextColor(LCD_BLACK, LCD_GREEN);
      else if (is_cursor) lcd.setTextColor(LCD_BLACK, LCD_WHITE);
      else if (is_mycall) lcd.setTextColor(is_old?FT8_AGED_COLOUR:LCD_WHITE, LCD_RED);
      else if (is_cq) lcd.setTextColor(is_old?FT8_AGED_COLOUR:LCD_WHITE, LCD_BLUE);
      else lcd.setTextColor(is_old?FT8_AGED_COLOUR:LCD_WHITE, LCD_BLACK);

      // Parity prefix: E=even slot, O=odd slot
      lcd.print(e->received_in_even_slot ? "E" : "O");
      lcd.print(" ");
      lcd.println(buf);
    }
    lcd.setTextColor(LCD_WHITE, LCD_BLACK); // restore
    ft8_show_position();
    ft8_show_new_indicator();
  }
}

//------------------------------------------------------------------------------
// ft8_qso_display()
// Replaces ft8_show_decoded() during an active QSO.
// Shows all 6 exchange rows, each colour-coded by state.
//------------------------------------------------------------------------------
static void ft8_qso_display(void)
{
  lcd.setTextFont(1);
  lcd.setTextSize(2);
  lcd.setCursor(0, 30);

  bool any_timeout = false;
  for (int i = 0; i < ft8_qso.num_rows; i++)
  {
    const ft8_qso_row_t* row = &ft8_qso.rows[i];
    uint16_t fg = 0;
    uint16_t bg = 0;
    switch (row->state)
    {
      case FT8_QSO_ROW_PENDING: fg = LCD_DARKGREY; bg = LCD_BLACK; break;
      case FT8_QSO_ROW_CURRENT: fg = LCD_BLACK;    bg = LCD_WHITE; break;
      case FT8_QSO_ROW_WAITING: fg = LCD_YELLOW;   bg = LCD_BLACK; break;
      case FT8_QSO_ROW_RETRY:   fg = LCD_PINK;     bg = LCD_BLACK; break;
      case FT8_QSO_ROW_TIMEOUT: fg = LCD_RED;      bg = LCD_BLACK; break;
      case FT8_QSO_ROW_DONE:    fg = LCD_GREEN;    bg = LCD_BLACK; break;
      default:                  fg = LCD_WHITE;    bg = LCD_BLACK; break;
    }
    if (row->state == FT8_QSO_ROW_TIMEOUT) any_timeout = true;
    lcd.setTextColor(fg, bg);

    // Row 0 is the heard CQ (no TX/RX prefix)
    // Rows 1-5 show TX/RX
    if (i > 0)
      lcd.print(row->is_tx ? "T " : "R ");
    else
      lcd.print("  ");
    char buf[FT8_DISPLAY_COLS - 1];
    memset(buf,0,sizeof(buf));
    strncpy(buf, row->text, sizeof(buf) - 1);
    buf[18] = '\0';
    lcd.println(buf);
  }

  lcd.setTextColor(LCD_WHITE, LCD_BLACK);

  // only fire once
  if (any_timeout && !ft8_qso.popup_shown)
  {
    ft8_qso.popup_shown = true;
    ft8_set_popup("Hold to abort");
  }
}

static void ft8_show_swr(void)
{
  static const uint32_t PO_DECAY_RATE = 250ul;
  static const float A = 0.141570128f;
  static const float B = 5.64859373f;
  volatile static uint32_t max_po = 0; 
  volatile static uint32_t po_decay = 0;
  if (!radio.tx_enable)
  {
    max_po = 0;
    return;
  }
  const uint32_t adc_fwd_raw = (uint32_t)fwdADC.read();
  const uint32_t adc_ref_raw = (uint32_t)refADC.read();
  if (adc_fwd_raw==0xffffu || adc_ref_raw==0xffffu)
  {
    return;
  }

  // vswr
  uint32_t vswr = 100u;
  const float adcfwd = (float)(FILTER::ma1(adc_fwd_raw));
  const float adcref = (float)(FILTER::ma2(adc_ref_raw));
  const float vfwd = A * adcfwd + B;
  const float vref = A * adcref + (adcref>2.0f?B:0.0f);
  if (vfwd>vref)
  {
    vswr = (uint32_t)(100.0f * (vfwd + vref) / (vfwd - vref));
    vswr = constrain(vswr,100u,999u);
  }
  // power out
  // Vpp * Vpp / 400
  const uint32_t now = millis();
  const float fwd = A * (float)adc_fwd_raw + (adc_fwd_raw>2?B:0.0f);
  const uint32_t po = (uint32_t)(((fwd * fwd) / 400.0f) * 10.0f + 0.5f);
  if (po<max_po)
  {
    if (now>po_decay)
    {
      if (max_po>0) max_po--;
      po_decay = now + PO_DECAY_RATE;
    }
  }
  else
  {
    max_po = po;
    po_decay = now + PO_DECAY_RATE;
  }

  // display SWR
  char sz_swr[16] = "";
  memset(sz_swr,0,sizeof(sz_swr));
  ultoa(vswr,sz_swr,10);
  sz_swr[3] = sz_swr[2];
  sz_swr[2] = sz_swr[1];
  sz_swr[1] = '.';
  lcd.setTextFont(1);
  lcd.setTextSize(1);
  lcd.setTextColor(LCD_WHITE);
  lcd.setCursor(FT8_SWR_X,FT8_SWR_Y);
  lcd.print(sz_swr);

  // display power
  char sz_po[16] = "";
  memset(sz_po,0,sizeof(sz_po));
  ultoa(max_po,sz_po,10);
  if (max_po<10)
  {
    sz_po[2] = sz_po[0];
    sz_po[1] = '.';
    sz_po[0] = '0';
  }
  else if (max_po<100)
  {
    sz_po[2] = sz_po[1];
    sz_po[1] = '.';
  }
  else
  {
    sz_po[3] = sz_po[2];
    sz_po[2] = '.';
  }
  lcd.setCursor(FT8_PWR_X,FT8_PWR_Y);
  lcd.print(sz_po);
}

static void ft8_show_calibrating(void)
{
  const uint32_t now = millis() % 1000000;
  lcd.setTextFont(1);
  lcd.setTextSize(2);
  lcd.setTextColor(LCD_RED);
  lcd.setCursor(0,30);
  lcd.print("Calibrate:");
  lcd.print(now);
  lcd.println("ms");
  lcd.setTextColor(LCD_WHITE);
  lcd.print("Calibrate:");
  lcd.print(now);
  lcd.println("ms");
  lcd.setTextColor(LCD_GREEN);
  lcd.print("Calibrate:");
  lcd.print(now);
  lcd.println("ms");
  lcd.setTextColor(LCD_BLUE);
  lcd.print("Calibrate:");
  lcd.print(now);
  lcd.println("ms");
  lcd.setTextColor(LCD_PURPLE);
  lcd.print("Calibrate:");
  lcd.print(now);
  lcd.println("ms");
  lcd.setTextColor(LCD_YELLOW);
  lcd.print("Calibrate:");
  lcd.print(now);
  lcd.println("ms");
}

static void ft8_display(
  const uint32_t slot_calibrate_ms,
  const ft8_state_t ft8_state,
  const uint32_t progress = 0,
  const bool calibrating = false)
{
  display_clear();
  ft8_show_agc();
  ft8_show_pulse();
  ft8_show_swr();
  ft8_show_frequency();
  ft8_show_progress(progress);
  ft8_show_slot_status(slot_calibrate_ms, ft8_state);
  ft8_show_tx_frequency();
  if (calibrating)
  {
    ft8_show_calibrating();
    display_refresh();
    return;
  }
  if (ft8_qso.active || millis() < ft8_qso_display_until)
    ft8_qso_display();
  else
    ft8_show_decoded(slot_calibrate_ms);
  ft8_show_popup();
  display_refresh();
}

//------------------------------------------------------------------------------
// HISTORY RING BUFFER
//------------------------------------------------------------------------------

// Get the i-th entry in chronological order (0=oldest, count-1=newest)
static const ft8_history_entry_t* ft8_history_get(uint32_t i)
{
  // if buffer not full yet
  uint32_t idx = i;
  if (ft8_history_count >= FT8_HISTORY_SIZE)
    // oldest is at head
    idx = (ft8_history_head + i) % FT8_HISTORY_SIZE;
  return &ft8_history[idx];
}

// Append decoded messages from one slot into the rolling history
static void ft8_history_add(
  const char lines[][FTX_MAX_DISPLAY_LENGTH],
  const uint32_t count,
  const bool even_slot,
  const uint8_t slot_num)
{
  if (count==0) return;
  for (uint32_t i = 0; i < count; i++)
  {
    ft8_history_entry_t* entry = &ft8_history[ft8_history_head];
    memcpy(entry->text, lines[i], FTX_MAX_DISPLAY_LENGTH);
    entry->text[FTX_MAX_DISPLAY_LENGTH - 1] = '\0';
    entry->received_in_even_slot = even_slot;
    entry->slot_number_low = slot_num;
    ft8_history_head = (ft8_history_head + 1) % FT8_HISTORY_SIZE;
    if (ft8_history_count < FT8_HISTORY_SIZE) ft8_history_count++;
  }
  ft8_new_available = true;
}

// Snapshot live history into the frozen display buffer
// Called once when user first moves the rotary encoder
static void ft8_freeze_display(void)
{
  ft8_display_count = (ft8_history_count < FT8_HISTORY_SIZE)? ft8_history_count : FT8_HISTORY_SIZE;
  for (uint32_t i = 0; i < ft8_display_count; i++)
    ft8_display_buf[i] = *ft8_history_get(i);
  // start at most recent
  ft8_cursor = (int32_t)ft8_display_count - 1;
  ft8_new_available = false;
}

//------------------------------------------------------------------------------
// ROTARY ENCODER HANDLER
// Call this every tick - reads radio.tune via rotary_mutex (same pattern as
// the rest of the codebase)
//------------------------------------------------------------------------------
static void ft8_handle_rotary(void)
{
  // Read and consume rotary delta
  if (!mutex_try_enter(&rotary_mutex,0ul))
  {
    // do not block but try again later
    return;
  }
  const int32_t delta = radio.tune;
  radio.tune = 0;
  mutex_exit(&rotary_mutex);

  if (delta == 0) return;

  ft8_last_interaction = millis();
  ft8_exit_pending_until = 0;
  switch (ft8_ui_state)
  {
    case FT8_UI_AUTO:
    {
      // First rotary movement - freeze display and enter browse mode
      if (ft8_history_count > 0)
      {
        ft8_freeze_display();
        ft8_ui_state = FT8_UI_BROWSE;
      }
      break;
    }
    case FT8_UI_BROWSE:
    {
      // Scroll cursor through frozen display buffer
      // CCW (delta < 0) moves toward older entries (lower index)
      // CW  (delta > 0) moves toward newer entries (higher index)
      ft8_cursor += delta;
      if (ft8_cursor < 0) ft8_cursor = 0;
      if (ft8_cursor >= (int32_t)ft8_display_count) ft8_cursor = (int32_t)ft8_display_count - 1;
      break;
    }
    case FT8_UI_SELECTED:
    {
      break;
    }
  }
}

static const ft8_btn_t ft8_button_check(void)
{
  const bool pressed = (digitalRead(PIN_ENCBUT) == LOW);

  if (ft8_button_down_time == 0)
  {
    if (pressed) ft8_button_down_time = millis();
    return FT8_BTN_IDLE;
  }

  if (pressed) return FT8_BTN_IDLE; // still down

  // Released — classify and consume
  const uint32_t held = millis() - ft8_button_down_time;
  ft8_button_down_time = 0;

  if (held < 50) return FT8_BTN_IDLE;   // debounce
  if (held >= FT8_BUTTON_LONG_PRESS) return FT8_BTN_LONG;
  return FT8_BTN_SHORT;
}

//------------------------------------------------------------------------------
// DECODE CALLBACK
// Called every N candidates during ft8_decode() so the UI stays responsive.
//------------------------------------------------------------------------------
static void ft8_ui_callback(void)
{
  // update display,
  // monitor rotary,
  // monitor button,
  // but only in browse mode
  if (ft8_ui_state != FT8_UI_BROWSE) return;
  ft8_handle_rotary();

  const ft8_btn_t btn = ft8_button_check();
  if (btn != FT8_BTN_IDLE) ft8_button_deferred = btn;

  static uint32_t next_update = 0;
  if (millis() > next_update)
  {
    next_update = millis() + 50ul;
    ft8_display(ft8_cal_freeze, FT8_STATE_DECODING);
  }
}
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
void loop(void)
{
  // run UI on core 0
#if defined(DEBUG_STACKCHECK_CORE0) || defined(DEBUG_STACKCHECK_CORE1)
  static uint32_t stack_next = 0;
  if (millis() > stack_next)
  {
    stack_next = millis() + 1000u;
    // get bytes of margin left
    debug_value_1 = (int32_t)stackpaint_check();
  }  
#endif
  if (radio.mode == MODE_FT8)
  {
    // keep FT8 completely separate
    if (do_ft8())
    {
      return;
    }
    radio.mode_auto = true;
    radio.mode = get_mode_auto();
    set_frequency();
  }
  static uint32_t old_frequency = radio.frequency;
  static uint32_t old_band = radio.band;
  static uint32_t old_sidetone = radio.sidetone;
  static uint32_t old_cw_level = radio.cw_level;
  static uint32_t old_cw_dit = radio.cw_dit;
  static uint32_t old_spectype = radio.spectype;
  static uint32_t old_jnrlevel = radio.jnrlevel;
  static uint32_t old_micgain = radio.micgain;
  static uint32_t old_bandwidth = radio.bandwidth;
  static int8_t old_level = 0;
  static bool old_cessb = radio.cessb;
  static bool old_graph_swr = radio.graph_swr;
  static bool old_attenuator = radio.attenuator;
  static bool old_notch_enable = radio.notch_enable;
  static bool old_ft8_autocal = radio.ft8_autocal;
  static mode_t old_mode = radio.mode;

  // process button press
  // short press: change step
  // long press: menu options
  enum button_state_t {BUTTON_IDLE,BUTTON_TEST_SHORT,BUTTON_WAIT_RELEASE};
  enum button_action_t {BUTTON_NO_PRESS,BUTTON_SHORT_PRESS,BUTTON_LONG_PRESS};
  static button_state_t button_state = BUTTON_IDLE;
  static uint32_t button_timer = 0;
  button_action_t button_action = BUTTON_NO_PRESS;
  if (!radio.tx_enable)
  {
    // receive mode
    if (radio.menu_active)
    {
      const option_value_t option = process_menu();
      switch (option)
      {
        case OPTION_MODE_LSB:        radio.mode = MODE_LSB; radio.mode_auto = false; break;
        case OPTION_MODE_USB:        radio.mode = MODE_USB; radio.mode_auto = false; break;
        case OPTION_MODE_CWL:        radio.mode = MODE_CWL; radio.mode_auto = false; break;
        case OPTION_MODE_CWU:        radio.mode = MODE_CWU; radio.mode_auto = false; break;
        case OPTION_MODE_DGL:        radio.mode = MODE_DGL; radio.mode_auto = false; break;
        case OPTION_MODE_DGU:        radio.mode = MODE_DGU; radio.mode_auto = false; break;
        case OPTION_MODE_FT8:        radio.mode = MODE_FT8; radio.mode_auto = false; break;
        case OPTION_MODE_AM:         radio.mode = MODE_AM;  radio.mode_auto = false; break;
        case OPTION_MODE_AUTO:       radio.mode_auto = true;                         break;
        case OPTION_STEP_10:         radio.step = 10U;                               break;
        case OPTION_STEP_100:        radio.step = 100U;                              break;
        case OPTION_STEP_500:        radio.step = 500U;                              break;
        case OPTION_STEP_1000:       radio.step = 1000U;                             break;
        case OPTION_STEP_5000:       radio.step = 5000U;                             break;
        case OPTION_STEP_10000:      radio.step = 10000U;                            break;
        case OPTION_STEP_100000:     radio.step = 100000U;                           break;
        case OPTION_BAND_80M:        radio.band = BAND_80M;                          break;
        case OPTION_BAND_40M:        radio.band = BAND_40M;                          break;
        case OPTION_BAND_30M:        radio.band = BAND_30M;                          break;
        case OPTION_BAND_20M:        radio.band = BAND_20M;                          break;
        case OPTION_BAND_17M:        radio.band = BAND_17M;                          break;
        case OPTION_BAND_15M:        radio.band = BAND_15M;                          break;
        case OPTION_BAND_12M:        radio.band = BAND_12M;                          break;
        case OPTION_BAND_10M:        radio.band = BAND_10M;                          break;
        case OPTION_BAND_SWL:        radio.band = BAND_SWL;                          break;
        case OPTION_BW_2000:         radio.bandwidth = 1ul;                          break;
        case OPTION_BW_2200:         radio.bandwidth = 2ul;                          break;
        case OPTION_BW_2400:         radio.bandwidth = 3ul;                          break;
        case OPTION_BW_2600:         radio.bandwidth = 4ul;                          break;
        case OPTION_BW_2800:         radio.bandwidth = 5ul;                          break;
        case OPTION_NOTCH_ON:        radio.notch_enable = true;                      break;
        case OPTION_NOTCH_OFF:       radio.notch_enable = false;                     break;
        case OPTION_SIDETONE_500:    radio.sidetone = 500u;                          break;
        case OPTION_SIDETONE_550:    radio.sidetone = 550u;                          break;
        case OPTION_SIDETONE_600:    radio.sidetone = 600u;                          break;
        case OPTION_SIDETONE_650:    radio.sidetone = 650u;                          break;
        case OPTION_SIDETONE_700:    radio.sidetone = 700u;                          break;
        case OPTION_SIDETONE_750:    radio.sidetone = 750u;                          break;
        case OPTION_SIDETONE_800:    radio.sidetone = 800u;                          break;
        case OPTION_SIDETONE_850:    radio.sidetone = 850u;                          break;
        case OPTION_SIDETONE_LOW:    radio.cw_level = 1u;                            break;
        case OPTION_SIDETONE_MED:    radio.cw_level = 2u;                            break;
        case OPTION_SIDETONE_HI:     radio.cw_level = 3u;                            break;
        case OPTION_CW_SPEED_10:     radio.cw_dit = 120u;                            break;
        case OPTION_CW_SPEED_15:     radio.cw_dit = 80u;                             break;
        case OPTION_CW_SPEED_20:     radio.cw_dit = 60u;                             break;
        case OPTION_CW_SPEED_25:     radio.cw_dit = 48u;                             break;
        case OPTION_CW_SPEED_30:     radio.cw_dit = 40u;                             break;
        case OPTION_DECODE_ADAPTIVE: radio.cwdecode = 1;                             break;
        case OPTION_DECODE_SCHMITT:  radio.cwdecode = 2;                             break;
        case OPTION_CWDECODE_OFF:    radio.cwdecode = 0;                             break;
        case OPTION_SPECTRUM_WIND:   radio.spectype = SPECTRUM_WIND;                 break;
        case OPTION_SPECTRUM_GRASS:  radio.spectype = SPECTRUM_GRASS;                break;
        case OPTION_SPEC_SETLEVEL:   set_spectrum_level = true;                      break;
        case OPTION_SPEC_ADJLEVEL:   adj_spectrum_level = true;                      break;
        case OPTION_JNR_LEVEL1:      radio.jnrlevel = JNR_LEVEL1;                    break;
        case OPTION_JNR_LEVEL2:      radio.jnrlevel = JNR_LEVEL2;                    break;
        case OPTION_JNR_LEVEL3:      radio.jnrlevel = JNR_LEVEL3;                    break;
        case OPTION_JNR_OFF:         radio.jnrlevel = JNR_OFF;                       break;
        case OPTION_NB_LEVEL1:       radio.nblevel = NB_LEVEL1;                      break;
        case OPTION_NB_LEVEL2:       radio.nblevel = NB_LEVEL2;                      break;
        case OPTION_NB_LEVEL3:       radio.nblevel = NB_LEVEL3;                      break;
        case OPTION_NB_LEVEL4:       radio.nblevel = NB_LEVEL4;                      break;
        case OPTION_NB_LEVEL5:       radio.nblevel = NB_LEVEL5;                      break;
        case OPTION_NB_OFF:          radio.nblevel = NB_OFF;                         break;
        case OPTION_MIC_25:          radio.micgain = 25;                             break;
        case OPTION_MIC_50:          radio.micgain = 50;                             break;
        case OPTION_MIC_75:          radio.micgain = 75;                             break;
        case OPTION_MIC_100:         radio.micgain = 100;                            break;
        case OPTION_MIC_125:         radio.micgain = 125;                            break;
        case OPTION_MIC_150:         radio.micgain = 150;                            break;
        case OPTION_MIC_175:         radio.micgain = 175;                            break;
        case OPTION_MIC_200:         radio.micgain = 200;                            break;
        case OPTION_MIC_PROC1:       radio.micproc = MIC_PROC1;                      break;
        case OPTION_MIC_PROC2:       radio.micproc = MIC_PROC2;                      break;
        case OPTION_MIC_PROC3:       radio.micproc = MIC_PROC3;                      break;
        case OPTION_MIC_PROC4:       radio.micproc = MIC_PROC4;                      break;
        case OPTION_MIC_PROC5:       radio.micproc = MIC_PROC5;                      break;
        case OPTION_MIC_PROC_OFF:    radio.micproc = MIC_PROC_OFF;                   break;
        case OPTION_CESSB_ON:        radio.cessb = true;                             break;
        case OPTION_CESSB_OFF:       radio.cessb = false;                            break;
        case OPTION_ATTENUATOR_ON:   radio.attenuator = true;                        break;
        case OPTION_ATTENUATOR_OFF:  radio.attenuator = false;                       break;
        case OPTION_GRAPH_SWR_Y:     radio.graph_swr = true;                         break;
        case OPTION_GRAPH_SWR_N:     radio.graph_swr = false;                        break;
        case OPTION_FT8_CQ_CQ:       radio.ft8_cq = FT8_CQ_CQ;                       break;
        case OPTION_FT8_CQ_DX:       radio.ft8_cq = FT8_CQ_DX;                       break;
        case OPTION_FT8_CQ_WWFF:     radio.ft8_cq = FT8_CQ_WWFF;                     break;
        case OPTION_FT8_CQ_POTA:     radio.ft8_cq = FT8_CQ_POTA;                     break;
        case OPTION_FT8_CQ_SOTA:     radio.ft8_cq = FT8_CQ_SOTA;                     break;
        case OPTION_FT8_CALSET:      do_ft8(true);                                   break;
        case OPTION_FT8_AUTOCAL:     radio.ft8_autocal = true;                       break;
        case OPTION_CALL_RESET:      reset_callsign();                               break;
        case OPTION_CALL_REBOOT:     reboot_callsign();                              break;
        case OPTION_VERSION:         set_popup(sz_version,"VERSION:");               break;
        case OPTION_REBOOT:          about_reboot();                                 break;
        case OPTION_ABT:             set_popup("Copyright 2026","THANKS:");          break;
        case OPTION_EXIT:            radio.menu_active = false;                      break;
      }

      if (set_spectrum_level)
      {
        // restore the saved level
        radio.level[radio.band] = radio.slevel[radio.band];
        old_level = radio.level[radio.band];
      }
      if (adj_spectrum_level)
      {
        // only changing current level, not saving it
        old_level = radio.level[radio.band];
      }

      // attenuator enable/disable
      if (radio.attenuator != old_attenuator)
      {
        old_attenuator = radio.attenuator;
        set_attenuator();
      }

      // notch enable/disable
      if (old_notch_enable != radio.notch_enable)
      {
        if (radio.mode==MODE_LSB || radio.mode==MODE_USB)
        {
          old_notch_enable = radio.notch_enable;
          adj_notch_filter = radio.notch_enable;
          DSP::notch.enable(radio.notch_enable);
        }
        else
        {
          // maintain notch condition
          radio.notch_enable = old_notch_enable;
          set_popup("Notch: SSB only");
        }
      }

      // when settings change save them
      bool settings_changed = false;

      // update DDS phase if sidetone changed
      if (radio.sidetone != old_sidetone)
      {
        old_sidetone = radio.sidetone;
        settings_changed = true;
        radio.cw_phase = ((uint64_t)radio.sidetone * (1ull << 32)) / SAMPLERATE;
      }

      // CW timing
      if (radio.cw_dit != old_cw_dit)
      {
        old_cw_dit = radio.cw_dit;
        settings_changed = true;
      }

      // CW level
      if (radio.cw_level != old_cw_level)
      {
        old_cw_level = radio.cw_level;
        settings_changed = true;
      }

      // spectrum type
      if (radio.spectype != old_spectype)
      {
        old_spectype = radio.spectype;
        settings_changed = true;
      }

      // JNR level
      if (radio.jnrlevel != old_jnrlevel)
      {
        old_jnrlevel = radio.jnrlevel;
        settings_changed = true;
      }

      // mic gain
      if (radio.micgain != old_micgain)
      {
        old_micgain = radio.micgain;
        settings_changed = true;
      }

      // bandwidth
      if (radio.bandwidth != old_bandwidth)
      {
        old_bandwidth = radio.bandwidth;
        settings_changed = true;
      }

      // CESSB
      if (radio.cessb != old_cessb)
      {
        old_cessb = radio.cessb;
        settings_changed = true;
      }

      // graph SWR
      if (radio.graph_swr != old_graph_swr)
      {
        old_graph_swr = radio.graph_swr;
        settings_changed = true;
        set_popup(radio.graph_swr?"Graph SWR":"Numeric SWR");
      }

      // FT8 auto cal
      if (radio.ft8_autocal != old_ft8_autocal)
      {
        old_ft8_autocal = radio.ft8_autocal;
        if (radio.ft8_autocal)
        {
          set_popup("Auto cal enabled","FT8 INFO:");
        }
      }

      // save the settings
      if (settings_changed)
      {
        save_settings();
      }

      // mode may change in auto
      const radio_mode_t auto_mode = get_mode_auto();
      if (radio.mode != auto_mode)
      {
        radio.mode = auto_mode;
      }

      // update frequency if mode changes
      // delay enabling Mic for Vox
      if (radio.mode!=old_mode)
      {
        old_mode = radio.mode;
        vox_mic_ready = false;
        vox_triggered = false;
        if (radio.mode==MODE_DGL || radio.mode==MODE_DGU)
        {
          enable_mic();
          delay(100);
          vox_mic_ready = true;
          radio.tx_safe = true;
        }
        else
        {
          disable_mic();
        }
        set_frequency();
      }

      // set band
      if (radio.band!=old_band)
      {
        save_data[old_band].frequency = radio.frequency;
        radio.frequency = save_data[radio.band].frequency;
        old_frequency = radio.frequency;
        old_band = radio.band;
        // mute during change
        mute();
        delay(50);
        set_filter();
        set_frequency();
        delay(50);
      }
    }
    else
    {
      // menu not active
      if (set_spectrum_level || adj_spectrum_level || adj_notch_filter)
      {
        if (adj_notch_filter)
        {
          set_notch_filter();
        }
        else
        {
          // rotary sets level
          mutex_enter_blocking(&rotary_mutex);
          const int32_t level_delta = radio.tune;
          radio.tune = 0;
          mutex_exit(&rotary_mutex);
          int8_t new_level = radio.level[radio.band] + level_delta;
          new_level = constrain(new_level,SPECTRUM_LEVEL_MIN,SPECTRUM_LEVEL_MAX);
          radio.level[radio.band] = new_level;
          if (digitalRead(PIN_ENCBUT)==LOW)
          {
            // if button pressed
            // save new level (if changed)
            // wait for button release
            if (set_spectrum_level && new_level!=old_level)
            {
              // remember saved level
              radio.slevel[radio.band] = new_level;
              save_settings();
            }
            delay(50);
            while (digitalRead(PIN_ENCBUT)==LOW)
            {
              tight_loop_contents();
            }
            delay(50);
            set_spectrum_level = false;
            adj_spectrum_level = false;
          }
        }
      }
      else
      {
        switch (button_state)
        {
          case BUTTON_IDLE:
          {
            if (digitalRead(PIN_ENCBUT)==LOW)
            {
              button_state = BUTTON_TEST_SHORT;
              button_timer = millis()+BUTTON_LONG_PRESS_TIME;
              delay(50);
            }
            break;
          }
          case BUTTON_TEST_SHORT:
          {
            const uint32_t now = millis();
            if (digitalRead(PIN_ENCBUT)==HIGH)
            {
              button_state = BUTTON_IDLE;
              if (now<button_timer)
              {
                button_action = BUTTON_SHORT_PRESS;
              }
              delay(50);
              break;
            }
            if (now>button_timer)
            {
              button_state = BUTTON_WAIT_RELEASE;
              button_action = BUTTON_LONG_PRESS;
            }
            break;
          }
          case BUTTON_WAIT_RELEASE:
          {
            if (digitalRead(PIN_ENCBUT)==HIGH)
            {
              button_state = BUTTON_IDLE;
              delay(50);
            }
            break;
          }
        }

        // process button action
        switch (button_action)
        {
          case BUTTON_SHORT_PRESS:
          {
            radio.step *= 10u;
            if (radio.step>10000u) radio.step = 100u;
            break;
          }
          case BUTTON_LONG_PRESS:
          {
            init_menu();
            radio.menu_active = true;
            break;
          }
        }

        // set the mode based on frequency if auto
        const radio_mode_t auto_mode = get_mode_auto();
        if (radio.mode != auto_mode)
        {
          radio.mode = auto_mode;
        }

        // process main tuning
        mutex_enter_blocking(&rotary_mutex);
        const int32_t tuning_delta = radio.tune;
        radio.tune = 0;
        mutex_exit(&rotary_mutex);
        volatile uint32_t new_frequency = radio.frequency;
        if (tuning_delta != 0)
        {
          const uint32_t step_modifer = (tuning_delta>0)?new_frequency:(new_frequency+radio.step-1);
          new_frequency = (step_modifer / radio.step) * radio.step;
          new_frequency += tuning_delta * radio.step;
          new_frequency = constrain(new_frequency,bands[radio.band].lo,bands[radio.band].hi);
        }
        if (new_frequency!=old_frequency || radio.mode!=old_mode)
        {
          radio.frequency = new_frequency;
          old_frequency = new_frequency;
          old_mode = radio.mode;
          set_frequency();
          if (radio.band==BAND_SWL)
          {
            set_filter();
          }
        } // frequency change
      } // spectrum level
    } // menu active
  } // receive mode
 
  // unmute in case muted
  unmute();

  // process spectrum
  static uint32_t process_spectrum_txrx = 0;
  if (millis()>process_spectrum_txrx)
  {
    process_spectrum();
  }

  // update the display every 50ms
  static uint32_t next_update = 0;
  const uint32_t now = millis();
  if (now>next_update)
  {
    next_update = now + 50ul;
    update_display(DSP::smeter(radio.frequency));
  }

  // check for PTT
  const bool digital = (radio.mode==MODE_DGL || radio.mode==MODE_DGU || radio.mode==MODE_FT8);
  const bool b_PTT = (!digital && radio.tx_safe && digitalRead(PIN_PTT)==LOW);
  const bool b_PADA = (!digital && radio.tx_safe && digitalRead(PIN_PADA)==LOW);
  const bool b_PADB = (!digital && radio.tx_safe && digitalRead(PIN_PADB)==LOW);
  radio.tx_button = (b_PTT || b_PADA || b_PADB);
  if ((radio.band==BAND_SWL) || (radio.mode==MODE_AM))
  {
    // capture TX button before returning
    return;
  }
  if (radio.tx_button || vox_triggered)
  {
    const float saved_agc = DSP::agc_peak;
    radio.menu_active = false;
    if (set_spectrum_level || adj_spectrum_level)
    {
      // restore old level in case it was changed
      set_spectrum_level = false;
      adj_spectrum_level = false;
      radio.level[radio.band] = old_level;
    }
    if (radio.mode==MODE_CWL || radio.mode==MODE_CWU)
    {
      process_key();
    }
    else if (b_PTT)
    {
      enable_ssb_tx();
      ptt_release();
    }
    else if (vox_triggered)
    {
      // wait for Vox to time out
      vox_triggered = false;
      enable_ssb_tx();
      uint32_t now = millis();
      uint32_t vox_timeout = now + VOX_TIMEOUT;
      while (now < vox_timeout)
      {
        process_vox_tx();
        now = millis();
        if (vox_triggered)
        {
          vox_triggered = false;
          vox_timeout = now + VOX_TIMEOUT;
        }
      }
    }
    if (vox_triggered)
    {
      vox_triggered = false;
    }

    // back to receive
    memset(magnitude,0,sizeof(magnitude));
    process_spectrum_txrx = millis()+200;
    digitalWrite(PIN_TXEN, LOW);
    delay(50);
    radio.tx_enable = false;
    set_frequency();
    update_display();
    unmute();
    digitalWrite(LED_BUILTIN,LOW);
    DSP::agc_peak = saved_agc;
  }
}
