ianm8/uDST/src/filter.h

#ifndef FILTER_H
#define FILTER_H

#define JNR_FILTER_LENGTH 8
#define BANDWIDTH_2200 1u
#define BANDWIDTH_2400 2u
#define BANDWIDTH_2600 3u
#define BANDWIDTH_2800 4u
#define BANDWIDTH_3000 5u
#define FIR_LENGTH 256
#define MA_FILTER_LENGTH 8
#define ADC_FILTER_LENGTH 16
#define MA_FILTER_MASK (MA_FILTER_LENGTH-1)
#define __mac_tap(_h) acc += (_h)*x[i++]
#define __mac_zap(_h) i++

namespace FILTER
{
  static const float __not_in_flash_func(ma4i)(const float v1)
  {
    static float delay1[MA_FILTER_LENGTH] = { 0 };
    static float delay2[MA_FILTER_LENGTH] = { 0 };
    static float delay3[MA_FILTER_LENGTH] = { 0 };
    static float delay4[MA_FILTER_LENGTH] = { 0 };
    static float sum1 = 0;
    static float sum2 = 0;
    static float sum3 = 0;
    static float sum4 = 0;
    static uint8_t p = 0;
    sum1 = sum1 - delay1[p] + v1;
    delay1[p] = v1;
    const float v2 = sum1 / (float)MA_FILTER_LENGTH;
    sum2 = sum2 - delay2[p] + v2;
    delay2[p] = v2;
    const float v3 = sum2 / (float)MA_FILTER_LENGTH;
    sum3 = sum3 - delay3[p] + v3;
    delay3[p] = v3;
    const float v4 = sum3 / (float)MA_FILTER_LENGTH;
    sum4 = sum4 - delay4[p] + v4;
    delay4[p] = v4;
    p++;
    p &= MA_FILTER_MASK;
    return sum4 / (float)MA_FILTER_LENGTH;
  }

  static const float __not_in_flash_func(ma4q)(const float v1)
  {
    static float delay1[MA_FILTER_LENGTH] = { 0 };
    static float delay2[MA_FILTER_LENGTH] = { 0 };
    static float delay3[MA_FILTER_LENGTH] = { 0 };
    static float delay4[MA_FILTER_LENGTH] = { 0 };
    static float sum1 = 0;
    static float sum2 = 0;
    static float sum3 = 0;
    static float sum4 = 0;
    static uint8_t p = 0;
    sum1 = sum1 - delay1[p] + v1;
    delay1[p] = v1;
    const float v2 = sum1 / (float)MA_FILTER_LENGTH;
    sum2 = sum2 - delay2[p] + v2;
    delay2[p] = v2;
    const float v3 = sum2 / (float)MA_FILTER_LENGTH;
    sum3 = sum3 - delay3[p] + v3;
    delay3[p] = v3;
    const float v4 = sum3 / (float)MA_FILTER_LENGTH;
    sum4 = sum4 - delay4[p] + v4;
    delay4[p] = v4;
    p++;
    p &= MA_FILTER_MASK;
    return sum4 / (float)MA_FILTER_LENGTH;
  }

  static float __not_in_flash_func(dcf)(const float in)
  {
    // single pole IIR high-pass filter
    //static const float k = 0.004f; // <100Hz
    //static const float k = 0.01f; // ~100Hz
    //static const float k = 0.1f; // ~300Hz
    static const float k = 0.05f; // ~200Hz
    static float s = 0;
    static float x1 = 0;
    static float y1 = 0;
    s -= x1;
    x1 = in;
    s += x1 - y1 * k;
    return (y1 = s);
  }

  static float __not_in_flash_func(dc1f)(const float in)
  {
    static const float k = 0.05f;
    static float s = 0;
    static float x1 = 0;
    static float y1 = 0;
    s -= x1;
    x1 = in;
    s += x1 - y1 * k;
    return (y1 = s);
  }

  static float __not_in_flash_func(dc2f)(const float in)
  {
    static const float k = 0.05f;
    static float s = 0;
    static float x1 = 0;
    static float y1 = 0;
    s -= x1;
    x1 = in;
    s += x1 - y1 * k;
    return (y1 = s);
  }

  // 4-section all-pass pair, 150-3000 Hz @ 31250 Hz
  // phase(fap1f) - phase(fap2f) = -90 degrees, within 0.030 degrees
  // worst-case opposite-sideband suppression 71.7 dB
  static const float __not_in_flash_func(fap1f)(const float s)
  {
    // all pass 41.9 @ 31250
    // all pass 280 @ 31250
    // all pass 908 @ 31250
    // all pass 3224 @ 31250
    static const float k1 = 0.9916065f;
    static const float k2 = 0.9453122f;
    static const float k3 = 0.8322739f;
    static const float k4 = 0.4970640f;
    static float x1 = 0.0f;
    static float y1 = 0.0f;
    static float x2 = 0.0f;
    static float y2 = 0.0f;
    static float x3 = 0.0f;
    static float y3 = 0.0f;
    static float x4 = 0.0f;
    static float y4 = 0.0f;
    y1 = (k1 * (s + y1)) - x1;
    x1 = s;
    y2 = (k2 * (y1 + y2)) - x2;
    x2 = y1;
    y3 = (k3 * (y2 + y3)) - x3;
    x3 = y2;
    y4 = (k4 * (y3 + y4)) - x4;
    x4 = y3;
    return y4;
  }

  static const float __not_in_flash_func(fap2f)(const float s)
  {
    // all pass 139 @ 31250
    // all pass 509 @ 31250
    // all pass 1645 @ 31250
    // all pass 8345 @ 31250
    static const float k1 = 0.9724555f;
    static const float k2 = 0.9024980f;
    static const float k3 = 0.7139754f;
    static const float k4 = -0.0535530f;
    static float x1 = 0.0f;
    static float y1 = 0.0f;
    static float x2 = 0.0f;
    static float y2 = 0.0f;
    static float x3 = 0.0f;
    static float y3 = 0.0f;
    static float x4 = 0.0f;
    static float y4 = 0.0f;
    y1 = (k1 * (s + y1)) - x1;
    x1 = s;
    y2 = (k2 * (y1 + y2)) - x2;
    x2 = y1;
    y3 = (k3 * (y2 + y3)) - x3;
    x3 = y2;
    y4 = (k4 * (y3 + y4)) - x4;
    x4 = y3;
    return y4;
  }

  static const float __not_in_flash_func(lpf_2200f_rx)(const float sample)
  {
    // 31250
    // 2200 Hz
    // att: 60dB
    // 255 taps
    static float x[FIR_LENGTH] = { 0.0f };
    static uint8_t sample_index = 0;
    uint8_t i = sample_index;
    x[sample_index--] = sample;
    float acc = 0;
    __mac_tap(-0.000019f);
    __mac_tap(-0.000042f);
    __mac_tap(-0.000062f);
    __mac_tap(-0.000073f);
    __mac_tap(-0.000069f);
    __mac_tap(-0.000048f);
    __mac_tap(-0.000012f);
    __mac_tap(0.000036f);
    __mac_tap(0.000085f);
    __mac_tap(0.000125f);
    __mac_tap(0.000145f);
    __mac_tap(0.000137f);
    __mac_tap(0.000098f);
    __mac_tap(0.00003f);
    __mac_tap(-0.000056f);
    __mac_tap(-0.000143f);
    __mac_tap(-0.000214f);
    __mac_tap(-0.00025f);
    __mac_tap(-0.000238f);
    __mac_tap(-0.000174f);
    __mac_tap(-0.000063f);
    __mac_tap(0.000077f);
    __mac_tap(0.000219f);
    __mac_tap(0.000335f);
    __mac_tap(0.000396f);
    __mac_tap(0.000381f);
    __mac_tap(0.000285f);
    __mac_tap(0.000118f);
    __mac_tap(-0.000095f);
    __mac_tap(-0.000313f);
    __mac_tap(-0.000493f);
    __mac_tap(-0.00059f);
    __mac_tap(-0.000577f);
    __mac_tap(-0.000443f);
    __mac_tap(-0.000203f);
    __mac_tap(0.000106f);
    __mac_tap(0.000426f);
    __mac_tap(0.000692f);
    __mac_tap(0.000844f);
    __mac_tap(0.000838f);
    __mac_tap(0.00066f);
    __mac_tap(0.000328f);
    __mac_tap(-0.000103f);
    __mac_tap(-0.000556f);
    __mac_tap(-0.000938f);
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
    __mac_tap(0.000134f);
    __mac_tap(0.000086f);
    __mac_zap(0.0f);
    __mac_tap(-0.000071f);
    __mac_tap(-0.000091f);
    __mac_tap(-0.000058f);
    __mac_zap(0.0f);
    __mac_tap(0.000046f);
    __mac_tap(0.000058f);
    __mac_tap(0.000036f);
    return acc;
  }
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
