ianm8/uDST/(commit log)

2026-07-30 Clarify typical power output in specifications
    Added typical power range for operation.
2026-07-30 Fix typo in README note about dual function pin
2026-07-30 Specify device for GOWIN project setup
    Updated device specification and instructions for dual function pin configuration.
2026-07-30 Update README with dual function pin instructions
2026-07-30 Fix formatting in README for dual function pin note
2026-07-30 Update README with device programming steps
    Added instructions for using openFPGALoader.
2026-07-31 PCB Revision 1.0
2026-07-31 Add PCB details section to README
2026-08-01 Add image to PCB README for Revision 1.0
2026-08-07 Schematic revision 1.0
2026-08-08 Add notch filter to features list
2026-08-14 Update README to correct board name from BS100 to BRS-100
2026-08-15 Update README with FPGA programming instructions
    Added a note for users to skip to the Device Programming section if they only want to program the FPGA.
2026-09-06 PCB Revision 1.1
2026-09-06 PCB Front and Back Panels
2026-09-07 Add BOM notes for components and specifications
2026-09-07 Revision 1.1 BOM
2026-09-09 Add prerequisites for Arduino Pi Pico project
    Added prerequisites section with link to Arduino core.
2026-09-09 Revise oscillator recommendation in BOM README
    Updated recommendation for oscillator replacement in BOM notes.
2026-09-10 BOM clarifications for revision 1.1
2026-09-10 BOM fixes for revision 1.1
2026-09-10 Fix typo in clock resolution description
    Corrected 'sub-millihertz' to 'sub-hertz' for accuracy.
2026-09-10 Version 2.7.250
    Issues with comments identified by Brian, W8BDM, fixed.
    [filter.h, ft8.h, notch.h, uDST.ino]
2026-09-16 Clarify resistor specifications in README.md
2026-09-16 Clarify capacitor substitution for audio amp
    Added note about substituting the 100uF capacitor with a 22uF.
2026-09-20 firmware programming instructions
    Added instructions for programming the FPGA and Pico 2.
2026-09-21 Fix typos in README for Pico UF2 instructions
2026-09-22 Update resistor power rating in README
2026-09-23 Fix inductor package size in README
    Corrected the package size for surface mount inductors from 0806 to 0805.
2026-09-24 Update README with MDS and ADC clipping details
    Added specifications for MDS and ADC clipping.
2026-09-26 PCB Completed
2026-09-26 Update README with new PCB images
    Added additional PCB images to the README.
2026-09-26 Update PCB README formatting and images
2026-10-04 Version 3.9.250
    Fixes overflow warning
    [uDST.ino]
2026-10-05 Add RX and TX current specifications to README
2026-10-14 Revise MDS and TX current values in README
    Updated minimum detectable signal and maximum TX current specifications.
2026-10-14 Add windings information to README
    Added details about wire specifications for windings.
