ianm8/uDST/PCB/uDST-PCB-Complete.jpg

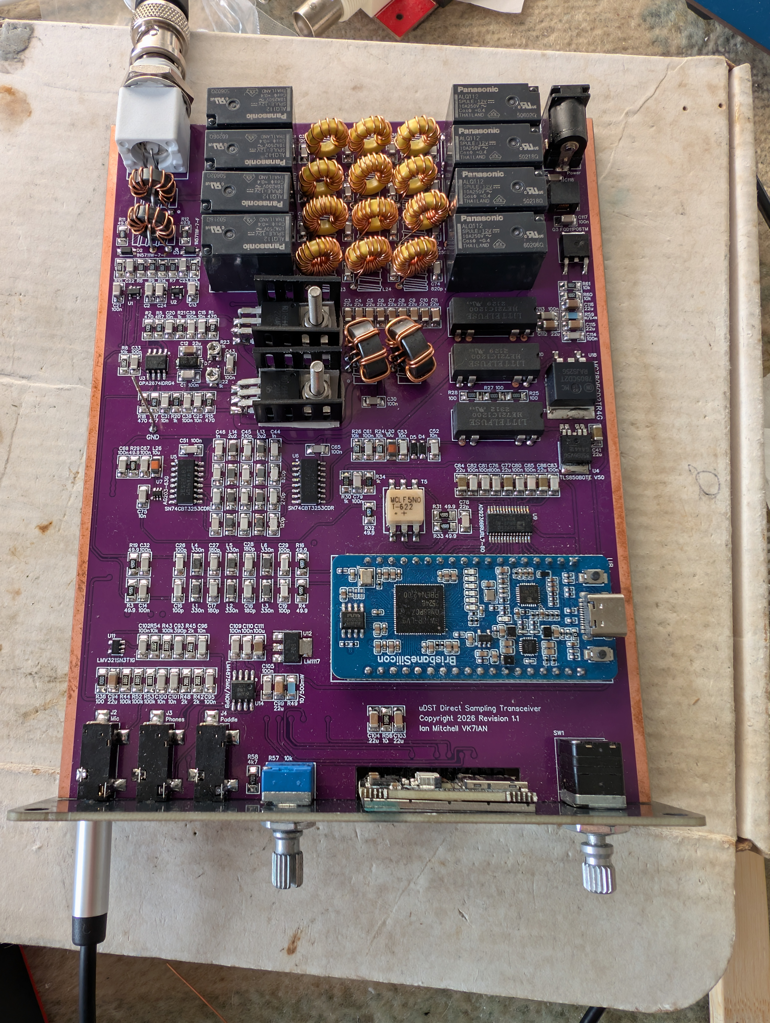
[picture p3: PCB/uDST-PCB-Complete.jpg]
PCB/uDST-PCB-Complete.jpg
