ianm8/uDST/docs/uDST-Complete.jpg

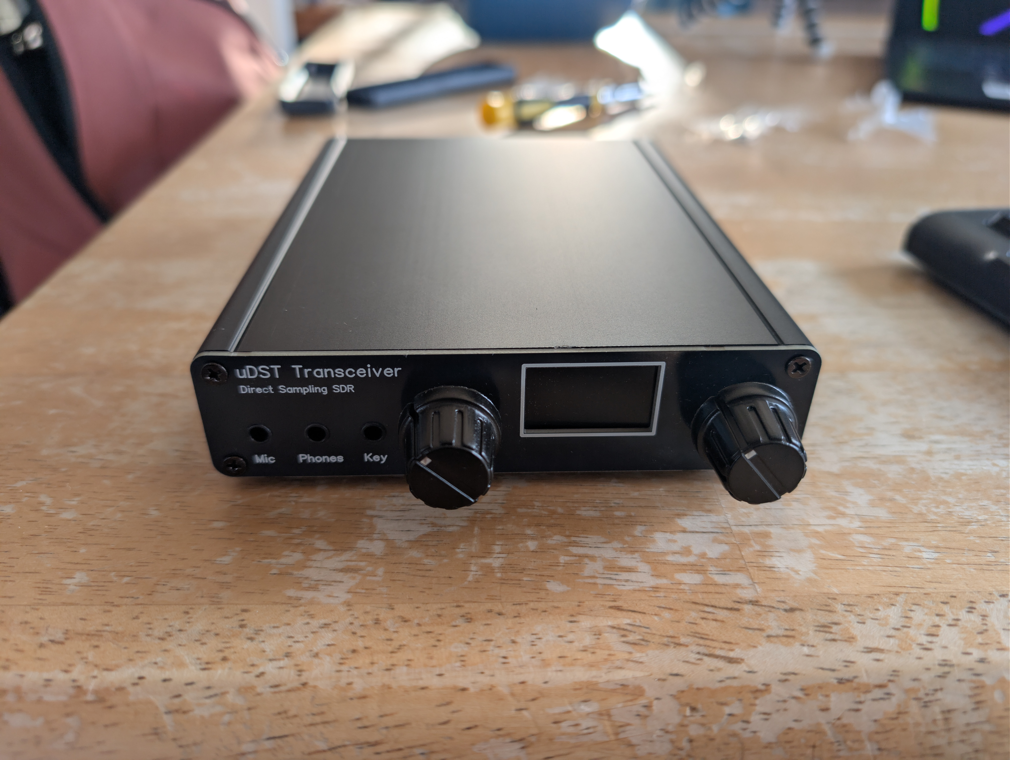
[picture p1: docs/uDST-Complete.jpg]
docs/uDST-Complete.jpg
